itsmevjnk/MelbourneTrainTracker/Hardware/Rev2/models/usbc.STEP

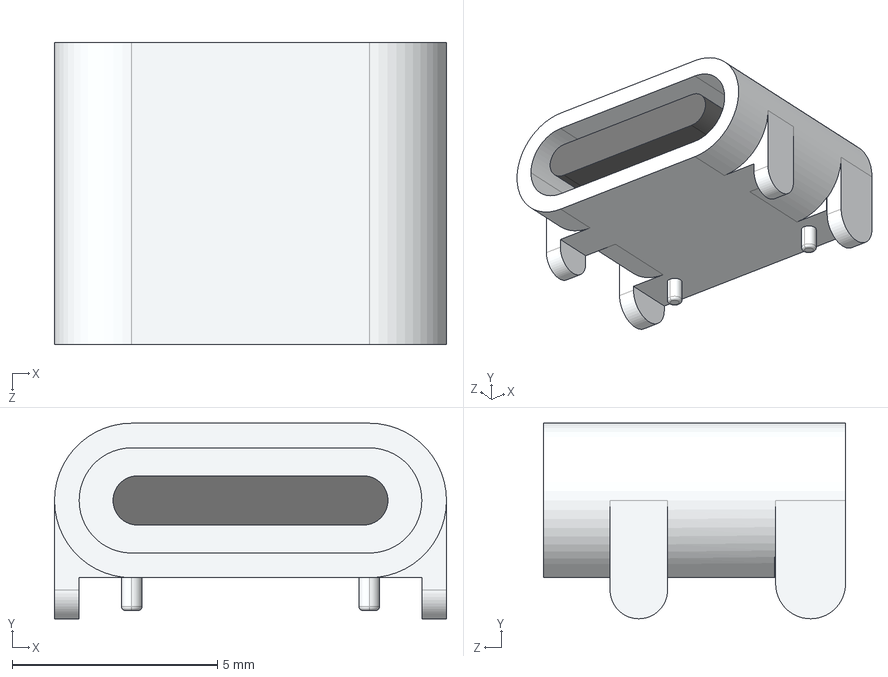
[picture p1: CAD file, 2026-01-21]
Hardware/Rev2/models/usbc.STEP
9.54 x 4.76 x 7.35 mm
