itsmevjnk/MelbourneTrainTracker/Hardware/Rev2/models/sd.STEP

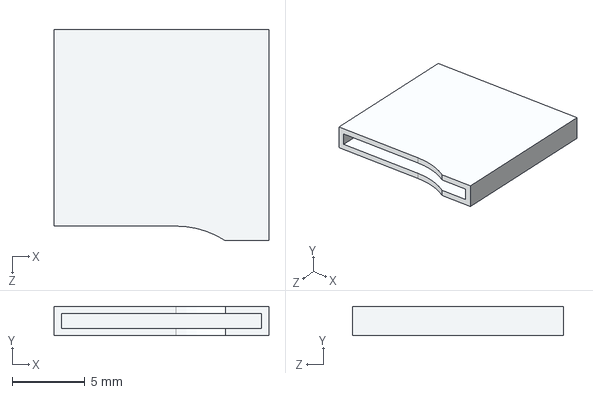
[picture p2: CAD file, 2026-01-21]
Hardware/Rev2/models/sd.STEP
14.8 x 2.00 x 14.5 mm
