itsmevjnk/MelbourneTrainTracker/Hardware/Rev2/models/1010 led.STEP

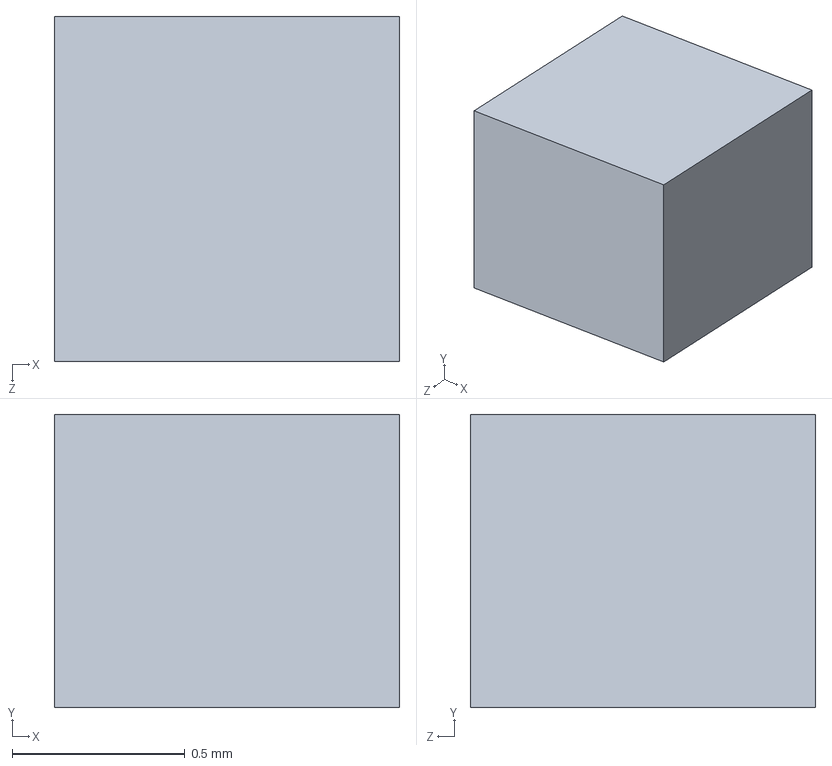
[picture p3: CAD file, 2026-01-21]
Hardware/Rev2/models/1010 led.STEP
1.00 x 0.85 x 1.00 mm
