itsmevjnk/MelbourneTrainTracker/Hardware/Rev2/models/aw20216.STEP

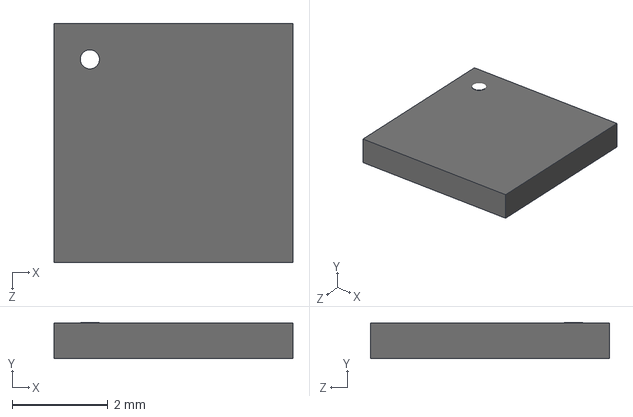
[picture p4: CAD file, 2026-01-21]
Hardware/Rev2/models/aw20216.STEP
5.00 x 0.76 x 5.00 mm
