itsmevjnk/MelbourneTrainTracker/Hardware/Rev1/Schematic.pdf

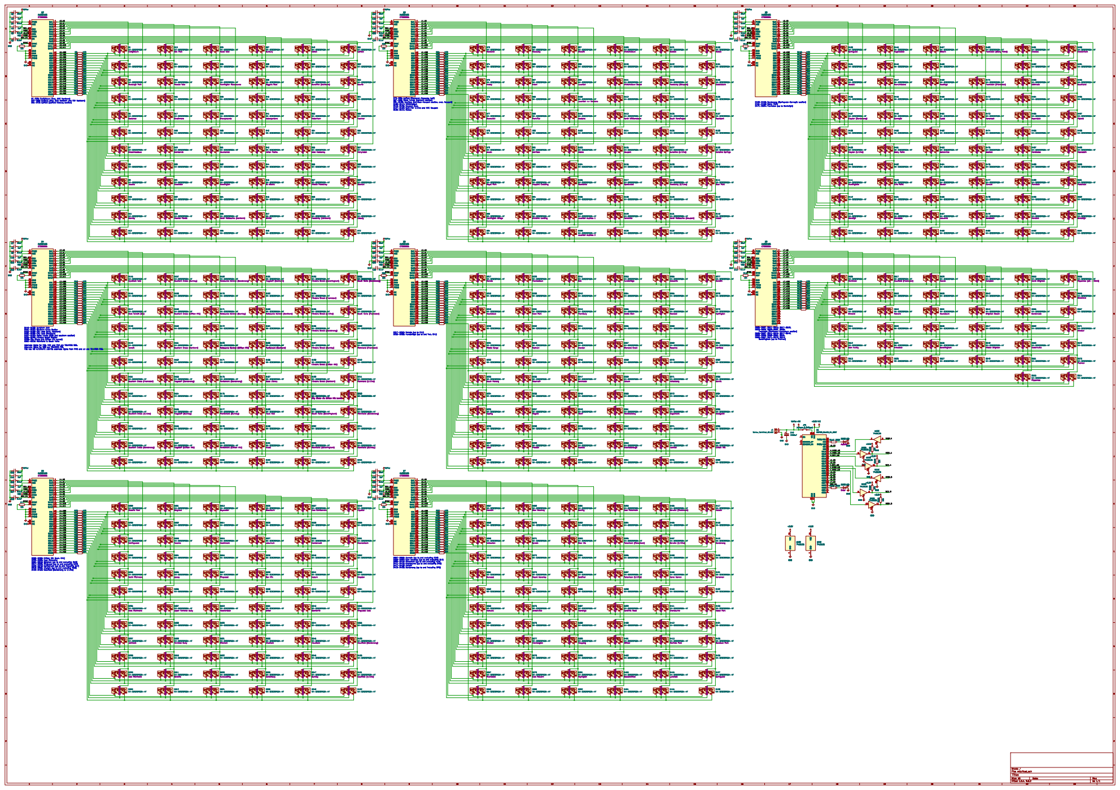
[picture p5: page 1]

Vdrive
PVCC 6 VCC 24 SCK 30 MOSI 31 CSN 28 MISO 27 EN 29 SYNC 33

3 D13 NH-B2020RGBA-HF Oak Park C2874116 RG

3 D25 NH-B2020RGBA-HF Ascot Vale C2874116 RG

3 D37 NH-B2020RGBA-HF Sunbury C2874116 RG

3 D49 NH-B2020RGBA-HF Albion C2874116 RG

3 D61 NH-B2020RGBA-HF Upfield C2874116 RG

3 D85 NH-B2020RGBA-HF Macaulay C2874116 RG

3 D133 NH-B2020RGBA-HF Melton C2874116 RG

3 D41 NH-B2020RGBA-HF C2874116 Watergardens RG

3 D51 NH-B2020RGBA-HF C2874116 Sunshine (Northern) RG

3 D135 NH-B2020RGBA-HF C2874116 Cobblebank RG

3 D483 NH-B2020RGBA-HF C2874116 Edithvale RG

3 D333 NH-B2020RGBA-HF Chatham C2874116 GND

3 D15 NH-B2020RGBA-HF C2874116 Pascoe Vale RG

3 D123 NH-B2020RGBA-HF C2874116 Footscray (Newport) RG

3 D447 NH-B2020RGBA-HF C2874116 Murrumbeena RG

3 D27 NH-B2020RGBA-HF C2874116 Flemington Racecourse RG

3 D39 NH-B2020RGBA-HF C2874116 Diggers Rest RG

3 D111 NH-B2020RGBA-HF C2874116 Williamstown Beach RG

3 D471 NH-B2020RGBA-HF C2874116 Frankston (Frankston)

3 D495 NH-B2020RGBA-HF C2874116 Southland RG

3 D17 NH-B2020RGBA-HF C2874116 Strathmore RG

3 D29 NH-B2020RGBA-HF C2874116 Showgrounds RG

3 D241 NH-B2020RGBA-HF Bell C2874116 RG

3 D101 NH-B2020RGBA-HF C2874116 Westona RG

3 D65 NH-B2020RGBA-HF C2874116 Fawkner RG

3 D113 NH-B2020RGBA-HF C2874116 North Williamstown RG

3 D125 NH-B2020RGBA-HF C2874116 South Kensington RG

3 D497 NH-B2020RGBA-HF C2874116 Highett RG

3 D499 NH-B2020RGBA-HF C2874116 Moorabbin RG

3 D347 NH-B2020RGBA-HF Burnley C2874116 RG

3 D115 NH-B2020RGBA-HF C2874116 Newport RG

3 D7 NH-B2020RGBA-HF C2874116 Broadmeadows RG

3 D31 NH-B2020RGBA-HF C2874116 Newmarket RG

3 D43 NH-B2020RGBA-HF C2874116 Keilor Plains RG

3 D55 NH-B2020RGBA-HF C2874116 West Footscray RG

3 D67 NH-B2020RGBA-HF C2874116 Merlynston RG

3 D127 NH-B2020RGBA-HF C2874116 Sunshine (V/Line) RG

3 D139 NH-B2020RGBA-HF C2874116 Caroline Springs RG

3 D451 NH-B2020RGBA-HF C2874116 Stony Point RG

3 D487 NH-B2020RGBA-HF C2874116 Mordialloc RG

3 D21 NH-B2020RGBA-HF Essendon C2874116 RG

3 D81 NH-B2020RGBA-HF Royal Park C2874116 RG

3 D453 NH-B2020RGBA-HF Crib Point C2874116 RG

3 D93 NH-B2020RGBA-HF Hoppers Crossing C2874116 RG

3 D143 NH-B2020RGBA-HF Ardeer C2874116 RG

3 D45 NH-B2020RGBA-HF St Albans C2874116

3 D57 NH-B2020RGBA-HF Middle Footscray C2874116

3 D117 NH-B2020RGBA-HF Spotswood C2874116 RG

3 D141 NH-B2020RGBA-HF Deer Park C2874116 VCC 14 GND

3 D465 NH-B2020RGBA-HF Baxter C2874116 RG

3 D95 NH-B2020RGBA-HF Williams Landing C2874116 RG

3 D119 NH-B2020RGBA-HF Yarraville C2874116 RG

3 D503 NH-B2020RGBA-HF Bentleigh C2874116 RG

3 D35 NH-B2020RGBA-HF North Melbourne (Northern) C2874116 RG

3 D47 NH-B2020RGBA-HF Ginifer C2874116 RG

3 D131 NH-B2020RGBA-HF North Melbourne (Newport) C2874116

3 D479 NH-B2020RGBA-HF Bonbeach C2874116 RG

3 D132 NH-B2020RGBA-HF C2874116 R151 10k +3.3V GND R152 10k +3.3V VCC GND

3 D219 NH-B2020RGBA-HF C2874116 Hawkstowe RG

3 D253 NH-B2020RGBA-HF Hurstbridge C2874116 RG

3 D157 NH-B2020RGBA-HF Southern Cross (Burnley) C2874116 RG

3 D145 NH-B2020RGBA-HF Wyndham Vale C2874116

3 D217 NH-B2020RGBA-HF Mernda C2874116 RG

3 D265 NH-B2020RGBA-HF Watsonia C2874116 RG

3 D277 NH-B2020RGBA-HF Darebin C2874116 RG

3 D517 NH-B2020RGBA-HF Caulfield (Frankston) C2874116

3 D553 NH-B2020RGBA-HF North Brighton C2874116

3 D565 NH-B2020RGBA-HF Ripponlea (alt - D515) C2874116 RG

3 D543 NH-B2020RGBA-HF C2874116 Brighton Beach RG

3 D231 NH-B2020RGBA-HF C2874116 Keon Park RG

3 D267 NH-B2020RGBA-HF C2874116 Macleod RG

3 D555 NH-B2020RGBA-HF C2874116 Gardenvale RG

3 D512 NH-B2020RGBA-HF C2874116 Glen Huntly R144 30R

3 D159 NH-B2020RGBA-HF C2874116 Southern Cross (Clifton Hill)

3 D195 NH-B2020RGBA-HF C2874116 Flinders Street (V/Line) RG

3 D183 NH-B2020RGBA-HF C2874116 Melbourne Central (Northern) RG

3 D255 NH-B2020RGBA-HF C2874116 Wattle Glen RG

3 D519 NH-B2020RGBA-HF C2874116 Malvern RG

3 D531 NH-B2020RGBA-HF C2874116 Hawksburn RG

3 D185 NH-B2020RGBA-HF C2874116 Parliament (Northern) RG

3 D281 NH-B2020RGBA-HF C2874116 Fairfield RG

3 D196 NH-B2020RGBA-HF C2874116 Flinders Street (Dandenong)

3 D571 NH-B2020RGBA-HF C2874116 Windsor RG

3 D271 NH-B2020RGBA-HF C2874116 Heidelberg RG

3 D524 NH-B2020RGBA-HF C2874116 Armadale RG

3 D257 NH-B2020RGBA-HF C2874116 Diamond Creek RG

3 D161 NH-B2020RGBA-HF C2874116 Southern Cross (Northern)

3 D173 NH-B2020RGBA-HF C2874116 Melbourne Central (Clifton Hill) RG

3 D197 NH-B2020RGBA-HF C2874116 Flinders Street (Burnley) RG

3 D209 NH-B2020RGBA-HF C2874116 Richmond (Frankston)

3 D221 NH-B2020RGBA-HF C2874116 Middle Gorge RG

3 D233 NH-B2020RGBA-HF C2874116 Ruthven RG

3 D245 NH-B2020RGBA-HF C2874116 Croxton RG

3 D560 NH-B2020RGBA-HF C2874116 Elsternwick RG

3 D269 NH-B2020RGBA-HF C2874116 Rosanna RG

3 D548 NH-B2020RGBA-HF C2874116 Middle Brighton RG

3 D199 NH-B2020RGBA-HF C2874116 Flinders Street (Northern) RG

3 D515 NH-B2020RGBA-HF C2874116 Ripponlea RG

3 D273 NH-B2020RGBA-HF Eaglemont C2874116 RG

3 D187 NH-B2020RGBA-HF C2874116 State Library

3 D211 NH-B2020RGBA-HF C2874116 Richmond (V/Line)

3 D223 NH-B2020RGBA-HF C2874116 South Morang RG

3 D235 NH-B2020RGBA-HF C2874116 Reservoir RG

3 D283 NH-B2020RGBA-HF C2874116 Dennis RG

3 D200 NH-B2020RGBA-HF C2874116 City Circle via Clifton Hill tunnel RG

3 D261 NH-B2020RGBA-HF Montmorency C2874116 RG

3 D153 NH-B2020RGBA-HF Southern Cross (V/Line) C2874116 R78 47R

3 D177 NH-B2020RGBA-HF Parliament (Burnley) C2874116

3 D201 NH-B2020RGBA-HF South Yarra (Sandringham) C2874116

3 D213 NH-B2020RGBA-HF Richmond (Dandenong) C2874116

3 D155 NH-B2020RGBA-HF Southern Cross (Dandenong) C2874116 RG

3 D179 NH-B2020RGBA-HF Parliament (Clifton Hill) C2874116

3 D191 NH-B2020RGBA-HF Anzac C2874116 RG

3 D203 NH-B2020RGBA-HF Richmond (Sandringham) C2874116 RG

3 D215 NH-B2020RGBA-HF Richmond (Burnley) C2874116 RG

3 D287 NH-B2020RGBA-HF Clifton Hill C2874116

Vdrive R77

3 D289 NH-B2020RGBA-HF Victoria Park C2874116 RG

3 D325 NH-B2020RGBA-HF Blackburn C2874116 RG

3 D337 NH-B2020RGBA-HF East Camberwell C2874116

3 D369 NH-B2020RGBA-HF Glen Waverley C2874116 RG

3 D393 NH-B2020RGBA-HF East Pakenham C2874116

3 D405 NH-B2020RGBA-HF Berwick (Pakenham) C2874116

3 D395 NH-B2020RGBA-HF C2874116 Pakenham (Pakenham) RG

3 D303 NH-B2020RGBA-HF C2874116 Tecoma RG

3 D383 NH-B2020RGBA-HF C2874116 Glen Iris R104 30R

3 D361 NH-B2020RGBA-HF C2874116 Burwood RG

3 D371 NH-B2020RGBA-HF C2874116 Syndal RG

3 D339 NH-B2020RGBA-HF C2874116 Camberwell RG

3 D407 NH-B2020RGBA-HF C2874116 Berwick (V/Line)

3 D299 NH-B2020RGBA-HF East Richmond C2874116 RG

3 D305 NH-B2020RGBA-HF C2874116 Upwey RG

3 D341 NH-B2020RGBA-HF C2874116 Auburn RG

3 D293 NH-B2020RGBA-HF C2874116 North Richmond RG

3 D329 NH-B2020RGBA-HF C2874116 Box Hill

3 D397 NH-B2020RGBA-HF C2874116 Pakenham (V/Line) RG

3 D409 NH-B2020RGBA-HF C2874116 Narre Warren

3 D421 NH-B2020RGBA-HF C2874116 Yarraman RG

3 D307 NH-B2020RGBA-HF C2874116 Upper Ferntree Gully RG

3 D411 NH-B2020RGBA-HF C2874116 Cranbourne RG

3 D295 NH-B2020RGBA-HF C2874116 West Richmond

3 D331 NH-B2020RGBA-HF C2874116 Union RG

3 D399 NH-B2020RGBA-HF C2874116 Cardinia Road RG

3 D423 NH-B2020RGBA-HF C2874116 Noble Park

3 D321 NH-B2020RGBA-HF Mitcham C2874116 RG

3 D345 NH-B2020RGBA-HF Hawthorn C2874116 RG

3 D425 NH-B2020RGBA-HF Sandown Park C2874116 RG

3 D429 NH-B2020RGBA-HF Caulfield (Dandenong) C2874116

3 D413 NH-B2020RGBA-HF Merinda Park C2874116

3 D311 NH-B2020RGBA-HF Boronia C2874116 RG

3 D379 NH-B2020RGBA-HF East Malvern C2874116

Id: 1/1 Title: File: mtt.kicad_sch Sheet: /
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
