itsmevjnk/MelbourneTrainTracker/Hardware/Rev2/Rev2.kicad_pcb

## KiCad design Hardware/Rev2/Rev2.kicad_pcb (2026-08-19)

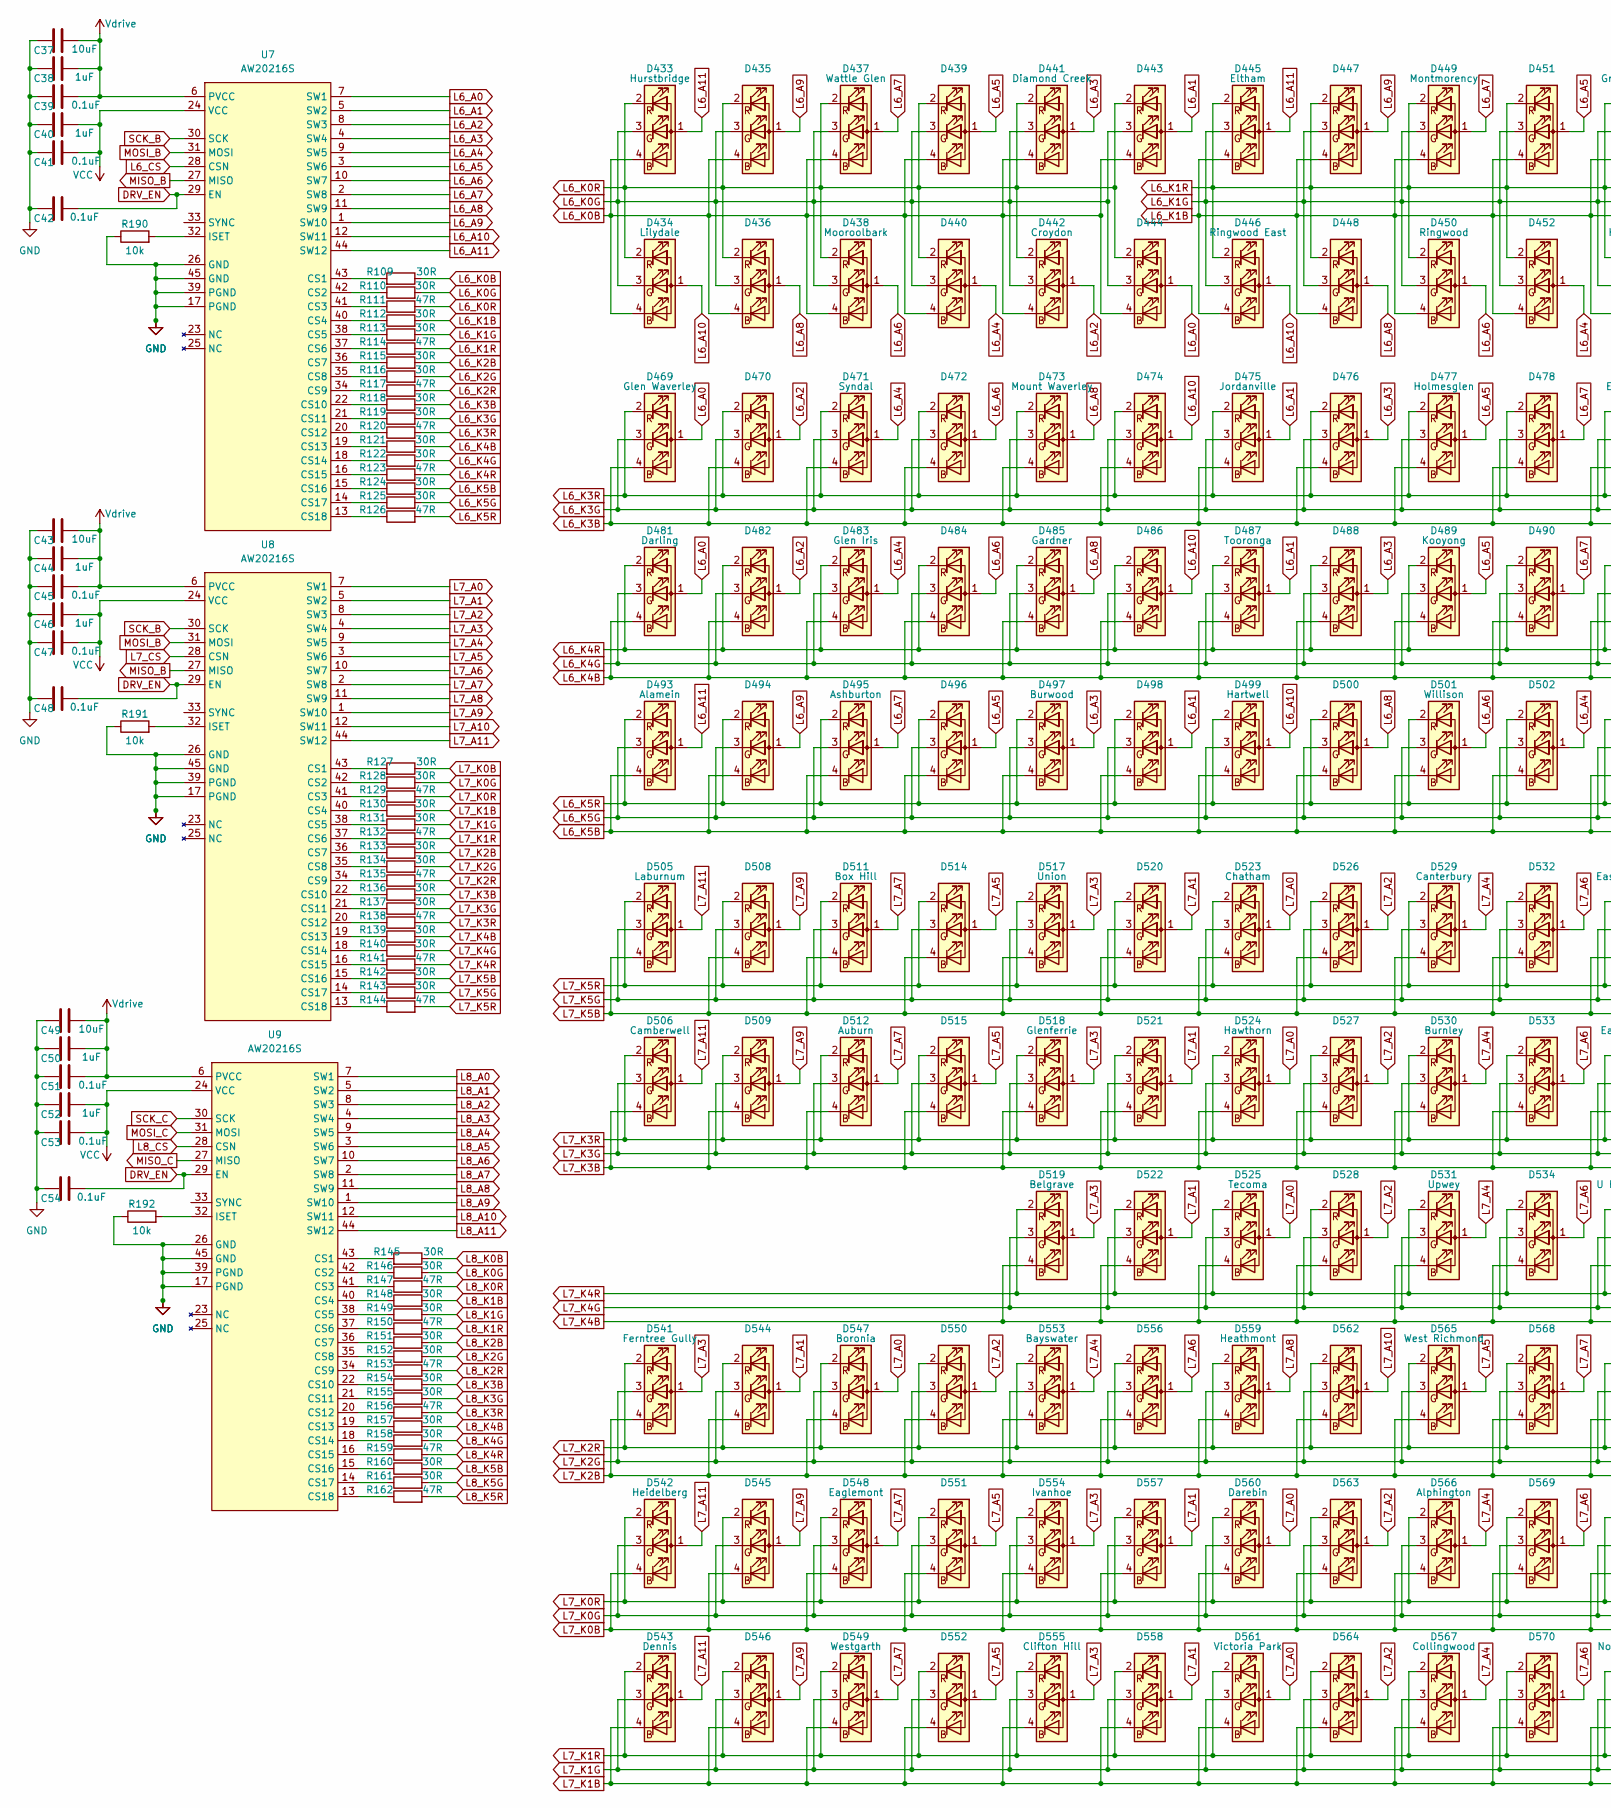
[picture p6: schematic led3.kicad_sch, part in row 1, column 1]

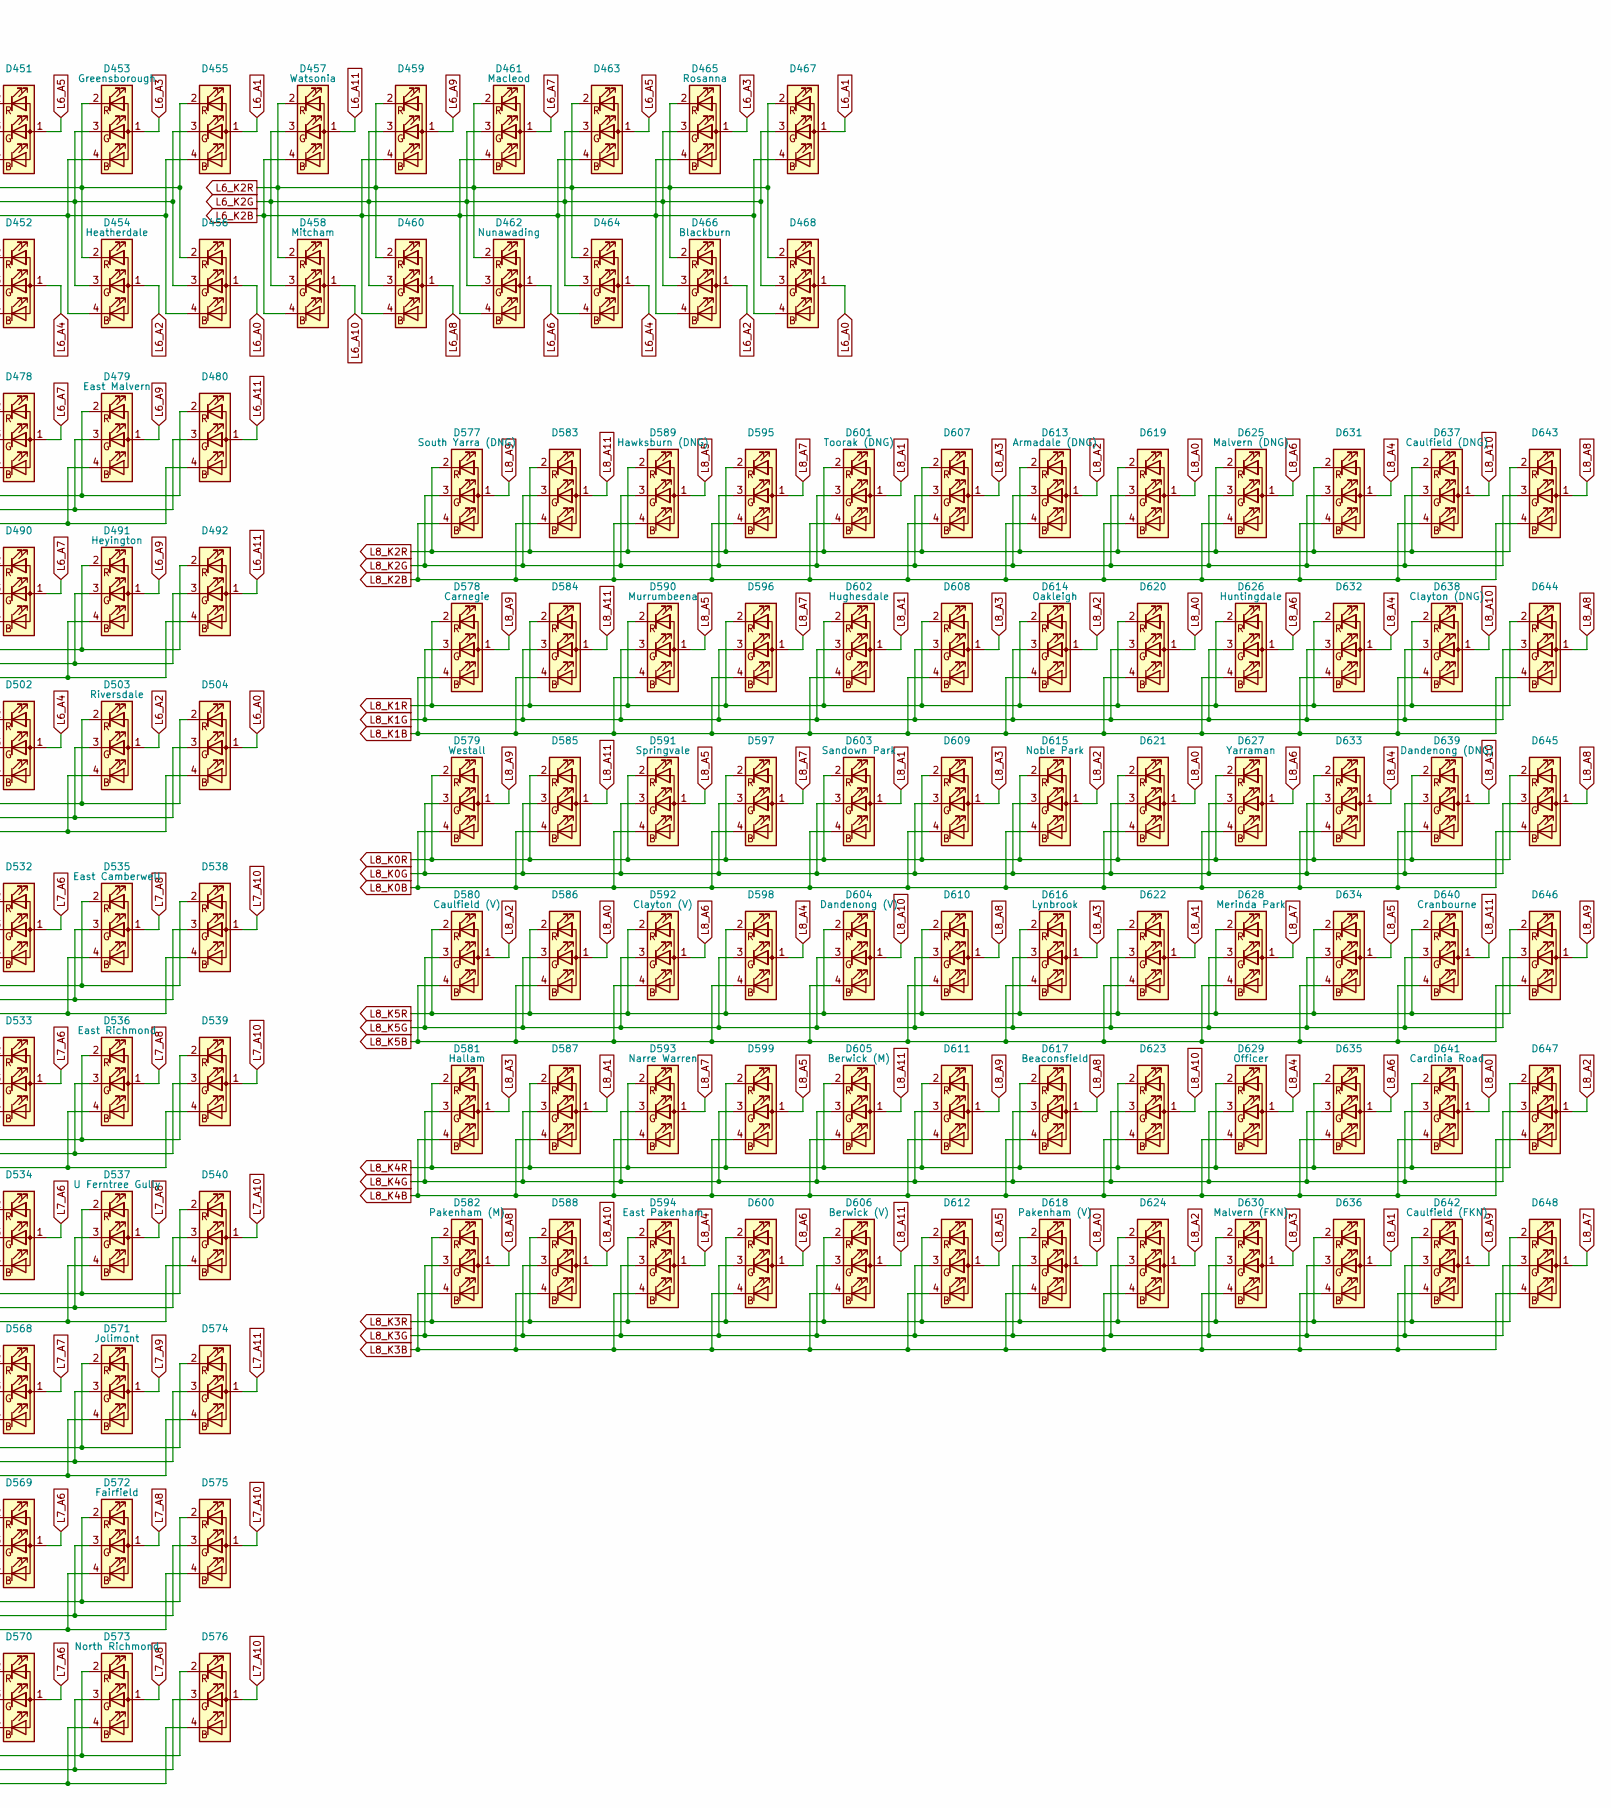
[picture p7: schematic led3.kicad_sch, part in row 1, column 2]

Parts:
C37, C43, C49: 10uF; C_0805_2012Metric_Pad1.18x1.45mm_HandSolder; MPN C380332
C38, C40, C44, C46, C50, C52: 1uF; C_0603_1608Metric_Pad1.08x0.95mm_HandSolder; MPN C6119849
C39, C41, C42, C45, C47, C48, C51, C53, C54: 0.1uF; C_0603_1608Metric_Pad1.08x0.95mm_HandSolder; MPN C14663
D433, D434, D435, D436, D437, D438, D439, D440, D441, D442, D443, D444, D445, D446, D447, D448, D449, D450, D451, D452, D453, D454, D455, D456, D457, D458, D459, D460, D461, D462, D463, D464, D465, D466, D467, D468, D469, D470, D471, D472, D473, D474, D475, D476, D477, D478, D479, D480, D481, D482, D483, D484, D485, D486, D487, D488, D489, D490, D491, D492, D493, D494, D495, D496, D497, D498, D499, D500, D501, D502, D503, D504, D505, D506, D508, D509, D511, D512, D514, D515, D517, D518, D519, D520, D521, D522, D523, D524, D525, D526, D527, D528, D529, D530, D531, D532, D533, D534, D535, D536, D537, D538, D539, D540, D541, D542, D543, D544, D545, D546, D547, D548, D549, D550, D551, D552, D553, D554, D555, D556, D557, D558, D559, D560, D561, D562, D563, D564, D565, D566, D567, D568, D569, D570, D571, D572, D573, D574, D575, D576, D577, D578, D579, D580, D581, D582, D583, D584, D585, D586, D587, D588, D589, D590, D591, D592, D593, D594, D595, D596, D597, D598, D599, D600, D601, D602, D603, D604, D605, D606, D607, D608, D609, D610, D611, D612, D613, D614, D615, D616, D617, D618, D619, D620, D621, D622, D623, D624, D625, D626, D627, D628, D629, D630, D631, D632, D633, D634, D635, D636, D637, D638, D639, D640, D641, D642, D643, D644, D645, D646, D647, D648: XL-B1010RGBT-HF; LED_RGB_Xinglight-1010; MPN C22464515
R109, R110, R112, R113, R115, R116, R118, R119, R121, R122, R124, R125, R127, R128, R130, R131, R133, R134, R136, R137, R139, R140, R142, R143, R145, R146, R148, R149, R151, R152, R154, R155, R157, R158, R160, R161: 30R; R_0805_2012Metric_Pad1.20x1.40mm_HandSolder
R111, R114, R117, R120, R123, R126, R129, R132, R135, R138, R141, R144, R147, R150, R153, R156, R159, R162: 47R; R_0805_2012Metric_Pad1.20x1.40mm_HandSolder
R190, R191, R192: 10k; R_0603_1608Metric_Pad0.98x0.95mm_HandSolder; MPN C15401
U7, U8, U9: AW20216S; QFN-44-1EP_5x5mm_P0.4mm_EP2.45x2.45mm; MPN C7385556

Connections:
+3.3V: C40.2, C41.2, C46.2, C47.2, C52.2, C53.2, U7.24 (VCC), U8.24 (VCC), U9.24 (VCC); also elsewhere on the board
+5V: C37.2, C38.2, C39.2, C43.2, C44.2, C45.2, C49.2, C50.2, C51.2, U7.6 (PVCC), U8.6 (PVCC), U9.6 (PVCC); also elsewhere on the board
DRV_EN: C42.2, C48.2, C54.2, U7.29 (EN), U8.29 (EN), U9.29 (EN); also elsewhere on the board
GND: C37.1, C38.1, C39.1, C40.1, C41.1, C42.1, C43.1, C44.1, C45.1, C46.1, C47.1, C48.1, C49.1, C50.1, C51.1, C52.1, C53.1, C54.1, R190.1, R191.1, R192.1, U7.17 (PGND), U7.26 (GND), U7.39 (PGND), U7.45 (GND), U8.17 (PGND), U8.26 (GND), U8.39 (PGND), U8.45 (GND), U9.17 (PGND), U9.26 (GND), U9.39 (PGND), U9.45 (GND); also elsewhere on the board
L6_A0: D444.1 (A), D456.1 (A), D468.1 (A), D469.1 (A), D481.1 (A), D504.1 (A), U7.7 (SW1)
L6_A1: D443.1 (A), D455.1 (A), D467.1 (A), D475.1 (A), D487.1 (A), D498.1 (A), U7.5 (SW2)
L6_A2: D442.1 (A), D454.1 (A), D466.1 (A), D470.1 (A), D482.1 (A), D503.1 (A), U7.8 (SW3)
L6_A3: D441.1 (A), D453.1 (A), D465.1 (A), D476.1 (A), D488.1 (A), D497.1 (A), U7.4 (SW4)
L6_A4: D440.1 (A), D452.1 (A), D464.1 (A), D471.1 (A), D483.1 (A), D502.1 (A), U7.9 (SW5)
L6_A5: D439.1 (A), D451.1 (A), D463.1 (A), D477.1 (A), D489.1 (A), D496.1 (A), U7.3 (SW6)
L6_A6: D438.1 (A), D450.1 (A), D462.1 (A), D472.1 (A), D484.1 (A), D501.1 (A), U7.10 (SW7)
L6_A7: D437.1 (A), D449.1 (A), D461.1 (A), D478.1 (A), D490.1 (A), D495.1 (A), U7.2 (SW8)
L6_A8: D436.1 (A), D448.1 (A), D460.1 (A), D473.1 (A), D485.1 (A), D500.1 (A), U7.11 (SW9)
L6_A9: D435.1 (A), D447.1 (A), D459.1 (A), D479.1 (A), D491.1 (A), D494.1 (A), U7.1 (SW10)
L6_A10: D434.1 (A), D446.1 (A), D458.1 (A), D474.1 (A), D486.1 (A), D499.1 (A), U7.12 (SW11)
L6_A11: D433.1 (A), D445.1 (A), D457.1 (A), D480.1 (A), D492.1 (A), D493.1 (A), U7.44 (SW12)
L6_CS: U7.28 (CSN); also elsewhere on the board
L6_K0B: D433.4 (BK), D434.4 (BK), D435.4 (BK), D436.4 (BK), D437.4 (BK), D438.4 (BK), D439.4 (BK), D440.4 (BK), D441.4 (BK), D442.4 (BK), D443.4 (BK), D444.4 (BK), R109.1
L6_K0G: D433.3 (GK), D434.3 (GK), D435.3 (GK), D436.3 (GK), D437.3 (GK), D438.3 (GK), D439.3 (GK), D440.3 (GK), D441.3 (GK), D442.3 (GK), D443.3 (GK), D444.3 (GK), R110.2
L6_K0R: D433.2 (RK), D434.2 (RK), D435.2 (RK), D436.2 (RK), D437.2 (RK), D438.2 (RK), D439.2 (RK), D440.2 (RK), D441.2 (RK), D442.2 (RK), D443.2 (RK), D444.2 (RK), R111.2
L6_K1B: D445.4 (BK), D446.4 (BK), D447.4 (BK), D448.4 (BK), D449.4 (BK), D450.4 (BK), D451.4 (BK), D452.4 (BK), D453.4 (BK), D454.4 (BK), D455.4 (BK), D456.4 (BK), R112.2
L6_K1G: D445.3 (GK), D446.3 (GK), D447.3 (GK), D448.3 (GK), D449.3 (GK), D450.3 (GK), D451.3 (GK), D452.3 (GK), D453.3 (GK), D454.3 (GK), D455.3 (GK), D456.3 (GK), R113.2
L6_K1R: D445.2 (RK), D446.2 (RK), D447.2 (RK), D448.2 (RK), D449.2 (RK), D450.2 (RK), D451.2 (RK), D452.2 (RK), D453.2 (RK), D454.2 (RK), D455.2 (RK), D456.2 (RK), R114.2
L6_K2B: D457.4 (BK), D458.4 (BK), D459.4 (BK), D460.4 (BK), D461.4 (BK), D462.4 (BK), D463.4 (BK), D464.4 (BK), D465.4 (BK), D466.4 (BK), D467.4 (BK), D468.4 (BK), R115.2
L6_K2G: D457.3 (GK), D458.3 (GK), D459.3 (GK), D460.3 (GK), D461.3 (GK), D462.3 (GK), D463.3 (GK), D464.3 (GK), D465.3 (GK), D466.3 (GK), D467.3 (GK), D468.3 (GK), R116.2
L6_K2R: D457.2 (RK), D458.2 (RK), D459.2 (RK), D460.2 (RK), D461.2 (RK), D462.2 (RK), D463.2 (RK), D464.2 (RK), D465.2 (RK), D466.2 (RK), D467.2 (RK), D468.2 (RK), R117.2
L6_K3B: D469.4 (BK), D470.4 (BK), D471.4 (BK), D472.4 (BK), D473.4 (BK), D474.4 (BK), D475.4 (BK), D476.4 (BK), D477.4 (BK), D478.4 (BK), D479.4 (BK), D480.4 (BK), R118.2
L6_K3G: D469.3 (GK), D470.3 (GK), D471.3 (GK), D472.3 (GK), D473.3 (GK), D474.3 (GK), D475.3 (GK), D476.3 (GK), D477.3 (GK), D478.3 (GK), D479.3 (GK), D480.3 (GK), R119.2
L6_K3R: D469.2 (RK), D470.2 (RK), D471.2 (RK), D472.2 (RK), D473.2 (RK), D474.2 (RK), D475.2 (RK), D476.2 (RK), D477.2 (RK), D478.2 (RK), D479.2 (RK), D480.2 (RK), R120.2
L6_K4B: D481.4 (BK), D482.4 (BK), D483.4 (BK), D484.4 (BK), D485.4 (BK), D486.4 (BK), D487.4 (BK), D488.4 (BK), D489.4 (BK), D490.4 (BK), D491.4 (BK), D492.4 (BK), R121.2
L6_K4G: D481.3 (GK), D482.3 (GK), D483.3 (GK), D484.3 (GK), D485.3 (GK), D486.3 (GK), D487.3 (GK), D488.3 (GK), D489.3 (GK), D490.3 (GK), D491.3 (GK), D492.3 (GK), R122.2
L6_K4R: D481.2 (RK), D482.2 (RK), D483.2 (RK), D484.2 (RK), D485.2 (RK), D486.2 (RK), D487.2 (RK), D488.2 (RK), D489.2 (RK), D490.2 (RK), D491.2 (RK), D492.2 (RK), R123.2
L6_K5B: D493.4 (BK), D494.4 (BK), D495.4 (BK), D496.4 (BK), D497.4 (BK), D498.4 (BK), D499.4 (BK), D500.4 (BK), D501.4 (BK), D502.4 (BK), D503.4 (BK), D504.4 (BK), R124.2
L6_K5G: D493.3 (GK), D494.3 (GK), D495.3 (GK), D496.3 (GK), D497.3 (GK), D498.3 (GK), D499.3 (GK), D500.3 (GK), D501.3 (GK), D502.3 (GK), D503.3 (GK), D504.3 (GK), R125.2
L6_K5R: D493.2 (RK), D494.2 (RK), D495.2 (RK), D496.2 (RK), D497.2 (RK), D498.2 (RK), D499.2 (RK), D500.2 (RK), D501.2 (RK), D502.2 (RK), D503.2 (RK), D504.2 (RK), R126.2
L7_A0: D523.1 (A), D524.1 (A), D525.1 (A), D547.1 (A), D560.1 (A), D561.1 (A), U8.7 (SW1)
L7_A1: D520.1 (A), D521.1 (A), D522.1 (A), D544.1 (A), D557.1 (A), D558.1 (A), U8.5 (SW2)
L7_A2: D526.1 (A), D527.1 (A), D528.1 (A), D550.1 (A), D563.1 (A), D564.1 (A), U8.8 (SW3)
L7_A3: D517.1 (A), D518.1 (A), D519.1 (A), D541.1 (A), D554.1 (A), D555.1 (A), U8.4 (SW4)
L7_A4: D529.1 (A), D530.1 (A), D531.1 (A), D553.1 (A), D566.1 (A), D567.1 (A), U8.9 (SW5)
L7_A5: D514.1 (A), D515.1 (A), D551.1 (A), D552.1 (A), D565.1 (A), U8.3 (SW6)
L7_A6: D532.1 (A), D533.1 (A), D534.1 (A), D556.1 (A), D569.1 (A), D570.1 (A), U8.10 (SW7)
L7_A7: D511.1 (A), D512.1 (A), D548.1 (A), D549.1 (A), D568.1 (A), U8.2 (SW8)
L7_A8: D535.1 (A), D536.1 (A), D537.1 (A), D559.1 (A), D572.1 (A), D573.1 (A), U8.11 (SW9)
L7_A9: D508.1 (A), D509.1 (A), D545.1 (A), D546.1 (A), D571.1 (A), U8.1 (SW10)
L7_A10: D538.1 (A), D539.1 (A), D540.1 (A), D562.1 (A), D575.1 (A), D576.1 (A), U8.12 (SW11)
L7_A11: D505.1 (A), D506.1 (A), D542.1 (A), D543.1 (A), D574.1 (A), U8.44 (SW12)
L7_CS: U8.28 (CSN); also elsewhere on the board
L7_K0B: D542.4 (BK), D545.4 (BK), D548.4 (BK), D551.4 (BK), D554.4 (BK), D557.4 (BK), D560.4 (BK), D563.4 (BK), D566.4 (BK), D569.4 (BK), D572.4 (BK), D575.4 (BK), R127.1
L7_K0G: D542.3 (GK), D545.3 (GK), D548.3 (GK), D551.3 (GK), D554.3 (GK), D557.3 (GK), D560.3 (GK), D563.3 (GK), D566.3 (GK), D569.3 (GK), D572.3 (GK), D575.3 (GK), R128.2
L7_K0R: D542.2 (RK), D545.2 (RK), D548.2 (RK), D551.2 (RK), D554.2 (RK), D557.2 (RK), D560.2 (RK), D563.2 (RK), D566.2 (RK), D569.2 (RK), D572.2 (RK), D575.2 (RK), R129.2
L7_K1B: D543.4 (BK), D546.4 (BK), D549.4 (BK), D552.4 (BK), D555.4 (BK), D558.4 (BK), D561.4 (BK), D564.4 (BK), D567.4 (BK), D570.4 (BK), D573.4 (BK), D576.4 (BK), R130.2
L7_K1G: D543.3 (GK), D546.3 (GK), D549.3 (GK), D552.3 (GK), D555.3 (GK), D558.3 (GK), D561.3 (GK), D564.3 (GK), D567.3 (GK), D570.3 (GK), D573.3 (GK), D576.3 (GK), R131.2
L7_K1R: D543.2 (RK), D546.2 (RK), D549.2 (RK), D552.2 (RK), D555.2 (RK), D558.2 (RK), D561.2 (RK), D564.2 (RK), D567.2 (RK), D570.2 (RK), D573.2 (RK), D576.2 (RK), R132.2
L7_K2B: D541.4 (BK), D544.4 (BK), D547.4 (BK), D550.4 (BK), D553.4 (BK), D556.4 (BK), D559.4 (BK), D562.4 (BK), D565.4 (BK), D568.4 (BK), D571.4 (BK), D574.4 (BK), R133.2
L7_K2G: D541.3 (GK), D544.3 (GK), D547.3 (GK), D550.3 (GK), D553.3 (GK), D556.3 (GK), D559.3 (GK), D562.3 (GK), D565.3 (GK), D568.3 (GK), D571.3 (GK), D574.3 (GK), R134.2
L7_K2R: D541.2 (RK), D544.2 (RK), D547.2 (RK), D550.2 (RK), D553.2 (RK), D556.2 (RK), D559.2 (RK), D562.2 (RK), D565.2 (RK), D568.2 (RK), D571.2 (RK), D574.2 (RK), R135.2
L7_K3B: D506.4 (BK), D509.4 (BK), D512.4 (BK), D515.4 (BK), D518.4 (BK), D521.4 (BK), D524.4 (BK), D527.4 (BK), D530.4 (BK), D533.4 (BK), D536.4 (BK), D539.4 (BK), R136.2
L7_K3G: D506.3 (GK), D509.3 (GK), D512.3 (GK), D515.3 (GK), D518.3 (GK), D521.3 (GK), D524.3 (GK), D527.3 (GK), D530.3 (GK), D533.3 (GK), D536.3 (GK), D539.3 (GK), R137.2
L7_K3R: D506.2 (RK), D509.2 (RK), D512.2 (RK), D515.2 (RK), D518.2 (RK), D521.2 (RK), D524.2 (RK), D527.2 (RK), D530.2 (RK), D533.2 (RK), D536.2 (RK), D539.2 (RK), R138.2
L7_K4B: D519.4 (BK), D522.4 (BK), D525.4 (BK), D528.4 (BK), D531.4 (BK), D534.4 (BK), D537.4 (BK), D540.4 (BK), R139.2
L7_K4G: D519.3 (GK), D522.3 (GK), D525.3 (GK), D528.3 (GK), D531.3 (GK), D534.3 (GK), D537.3 (GK), D540.3 (GK), R140.2
L7_K4R: D519.2 (RK), D522.2 (RK), D525.2 (RK), D528.2 (RK), D531.2 (RK), D534.2 (RK), D537.2 (RK), D540.2 (RK), R141.2
L7_K5B: D505.4 (BK), D508.4 (BK), D511.4 (BK), D514.4 (BK), D517.4 (BK), D520.4 (BK), D523.4 (BK), D526.4 (BK), D529.4 (BK), D532.4 (BK), D535.4 (BK), D538.4 (BK), R142.2
L7_K5G: D505.3 (GK), D508.3 (GK), D511.3 (GK), D514.3 (GK), D517.3 (GK), D520.3 (GK), D523.3 (GK), D526.3 (GK), D529.3 (GK), D532.3 (GK), D535.3 (GK), D538.3 (GK), R143.2
L7_K5R: D505.2 (RK), D508.2 (RK), D511.2 (RK), D514.2 (RK), D517.2 (RK), D520.2 (RK), D523.2 (RK), D526.2 (RK), D529.2 (RK), D532.2 (RK), D535.2 (RK), D538.2 (RK), R144.2
L8_A0: D586.1 (A), D618.1 (A), D619.1 (A), D620.1 (A), D621.1 (A), D641.1 (A), U9.7 (SW1)
L8_A1: D587.1 (A), D601.1 (A), D602.1 (A), D603.1 (A), D622.1 (A), D636.1 (A), U9.5 (SW2)
L8_A2: D580.1 (A), D613.1 (A), D614.1 (A), D615.1 (A), D624.1 (A), D647.1 (A), U9.8 (SW3)
L8_A3: D581.1 (A), D607.1 (A), D608.1 (A), D609.1 (A), D616.1 (A), D630.1 (A), U9.4 (SW4)
L8_A4: D594.1 (A), D598.1 (A), D629.1 (A), D631.1 (A), D632.1 (A), D633.1 (A), U9.9 (SW5)
L8_A5: D589.1 (A), D590.1 (A), D591.1 (A), D599.1 (A), D612.1 (A), D634.1 (A), U9.3 (SW6)
L8_A6: D592.1 (A), D600.1 (A), D625.1 (A), D626.1 (A), D627.1 (A), D635.1 (A), U9.10 (SW7)
L8_A7: D593.1 (A), D595.1 (A), D596.1 (A), D597.1 (A), D628.1 (A), D648.1 (A), U9.2 (SW8)
L8_A8: D582.1 (A), D610.1 (A), D617.1 (A), D643.1 (A), D644.1 (A), D645.1 (A), U9.11 (SW9)
L8_A9: D577.1 (A), D578.1 (A), D579.1 (A), D611.1 (A), D642.1 (A), D646.1 (A), U9.1 (SW10)
L8_A10: D588.1 (A), D604.1 (A), D623.1 (A), D637.1 (A), D638.1 (A), D639.1 (A), U9.12 (SW11)
L8_A11: D583.1 (A), D584.1 (A), D585.1 (A), D605.1 (A), D606.1 (A), D640.1 (A), U9.44 (SW12)
L8_CS: U9.28 (CSN); also elsewhere on the board
L8_K0B: D579.4 (BK), D585.4 (BK), D591.4 (BK), D597.4 (BK), D603.4 (BK), D609.4 (BK), D615.4 (BK), D621.4 (BK), D627.4 (BK), D633.4 (BK), D639.4 (BK), D645.4 (BK), R145.1
L8_K0G: D579.3 (GK), D585.3 (GK), D591.3 (GK), D597.3 (GK), D603.3 (GK), D609.3 (GK), D615.3 (GK), D621.3 (GK), D627.3 (GK), D633.3 (GK), D639.3 (GK), D645.3 (GK), R146.2
L8_K0R: D579.2 (RK), D585.2 (RK), D591.2 (RK), D597.2 (RK), D603.2 (RK), D609.2 (RK), D615.2 (RK), D621.2 (RK), D627.2 (RK), D633.2 (RK), D639.2 (RK), D645.2 (RK), R147.2
L8_K1B: D578.4 (BK), D584.4 (BK), D590.4 (BK), D596.4 (BK), D602.4 (BK), D608.4 (BK), D614.4 (BK), D620.4 (BK), D626.4 (BK), D632.4 (BK), D638.4 (BK), D644.4 (BK), R148.2
L8_K1G: D578.3 (GK), D584.3 (GK), D590.3 (GK), D596.3 (GK), D602.3 (GK), D608.3 (GK), D614.3 (GK), D620.3 (GK), D626.3 (GK), D632.3 (GK), D638.3 (GK), D644.3 (GK), R149.2
L8_K1R: D578.2 (RK), D584.2 (RK), D590.2 (RK), D596.2 (RK), D602.2 (RK), D608.2 (RK), D614.2 (RK), D620.2 (RK), D626.2 (RK), D632.2 (RK), D638.2 (RK), D644.2 (RK), R150.2
L8_K2B: D577.4 (BK), D583.4 (BK), D589.4 (BK), D595.4 (BK), D601.4 (BK), D607.4 (BK), D613.4 (BK), D619.4 (BK), D625.4 (BK), D631.4 (BK), D637.4 (BK), D643.4 (BK), R151.2
L8_K2G: D577.3 (GK), D583.3 (GK), D589.3 (GK), D595.3 (GK), D601.3 (GK), D607.3 (GK), D613.3 (GK), D619.3 (GK), D625.3 (GK), D631.3 (GK), D637.3 (GK), D643.3 (GK), R152.2
L8_K2R: D577.2 (RK), D583.2 (RK), D589.2 (RK), D595.2 (RK), D601.2 (RK), D607.2 (RK), D613.2 (RK), D619.2 (RK), D625.2 (RK), D631.2 (RK), D637.2 (RK), D643.2 (RK), R153.2
L8_K3B: D582.4 (BK), D588.4 (BK), D594.4 (BK), D600.4 (BK), D606.4 (BK), D612.4 (BK), D618.4 (BK), D624.4 (BK), D630.4 (BK), D636.4 (BK), D642.4 (BK), D648.4 (BK), R154.2
L8_K3G: D582.3 (GK), D588.3 (GK), D594.3 (GK), D600.3 (GK), D606.3 (GK), D612.3 (GK), D618.3 (GK), D624.3 (GK), D630.3 (GK), D636.3 (GK), D642.3 (GK), D648.3 (GK), R155.2
L8_K3R: D582.2 (RK), D588.2 (RK), D594.2 (RK), D600.2 (RK), D606.2 (RK), D612.2 (RK), D618.2 (RK), D624.2 (RK), D630.2 (RK), D636.2 (RK), D642.2 (RK), D648.2 (RK), R156.2
L8_K4B: D581.4 (BK), D587.4 (BK), D593.4 (BK), D599.4 (BK), D605.4 (BK), D611.4 (BK), D617.4 (BK), D623.4 (BK), D629.4 (BK), D635.4 (BK), D641.4 (BK), D647.4 (BK), R157.2
L8_K4G: D581.3 (GK), D587.3 (GK), D593.3 (GK), D599.3 (GK), D605.3 (GK), D611.3 (GK), D617.3 (GK), D623.3 (GK), D629.3 (GK), D635.3 (GK), D641.3 (GK), D647.3 (GK), R158.2
L8_K4R: D581.2 (RK), D587.2 (RK), D593.2 (RK), D599.2 (RK), D605.2 (RK), D611.2 (RK), D617.2 (RK), D623.2 (RK), D629.2 (RK), D635.2 (RK), D641.2 (RK), D647.2 (RK), R159.2
L8_K5B: D580.4 (BK), D586.4 (BK), D592.4 (BK), D598.4 (BK), D604.4 (BK), D610.4 (BK), D616.4 (BK), D622.4 (BK), D628.4 (BK), D634.4 (BK), D640.4 (BK), D646.4 (BK), R160.2
L8_K5G: D580.3 (GK), D586.3 (GK), D592.3 (GK), D598.3 (GK), D604.3 (GK), D610.3 (GK), D616.3 (GK), D622.3 (GK), D628.3 (GK), D634.3 (GK), D640.3 (GK), D646.3 (GK), R161.2
L8_K5R: D580.2 (RK), D586.2 (RK), D592.2 (RK), D598.2 (RK), D604.2 (RK), D610.2 (RK), D616.2 (RK), D622.2 (RK), D628.2 (RK), D634.2 (RK), D640.2 (RK), D646.2 (RK), R162.2
MISO_B: U7.27 (MISO), U8.27 (MISO); also elsewhere on the board
MISO_C: U9.27 (MISO); also elsewhere on the board
MOSI_B: U7.31 (MOSI), U8.31 (MOSI); also elsewhere on the board
MOSI_C: U9.31 (MOSI); also elsewhere on the board
unnamed: R109.2, U7.43 (CS1)
unnamed: R110.1, U7.42 (CS2)
unnamed: R111.1, U7.41 (CS3)
unnamed: R112.1, U7.40 (CS4)
unnamed: R113.1, U7.38 (CS5)
unnamed: R114.1, U7.37 (CS6)
unnamed: R115.1, U7.36 (CS7)
unnamed: R116.1, U7.35 (CS8)
unnamed: R117.1, U7.34 (CS9)
unnamed: R118.1, U7.22 (CS10)
unnamed: R119.1, U7.21 (CS11)
unnamed: R120.1, U7.20 (CS12)
unnamed: R121.1, U7.19 (CS13)
unnamed: R122.1, U7.18 (CS14)
unnamed: R123.1, U7.16 (CS15)
unnamed: R124.1, U7.15 (CS16)
unnamed: R125.1, U7.14 (CS17)
unnamed: R126.1, U7.13 (CS18)
unnamed: R190.2, U7.32 (ISET)
unnamed: R127.2, U8.43 (CS1)
unnamed: R128.1, U8.42 (CS2)
unnamed: R129.1, U8.41 (CS3)
unnamed: R130.1, U8.40 (CS4)
unnamed: R131.1, U8.38 (CS5)
unnamed: R132.1, U8.37 (CS6)
unnamed: R133.1, U8.36 (CS7)
unnamed: R134.1, U8.35 (CS8)
unnamed: R135.1, U8.34 (CS9)
unnamed: R136.1, U8.22 (CS10)
unnamed: R137.1, U8.21 (CS11)
unnamed: R138.1, U8.20 (CS12)
unnamed: R139.1, U8.19 (CS13)
unnamed: R140.1, U8.18 (CS14)
unnamed: R141.1, U8.16 (CS15)
unnamed: R142.1, U8.15 (CS16)
unnamed: R143.1, U8.14 (CS17)
unnamed: R144.1, U8.13 (CS18)
unnamed: R191.2, U8.32 (ISET)
unnamed: R145.2, U9.43 (CS1)
unnamed: R146.1, U9.42 (CS2)
unnamed: R147.1, U9.41 (CS3)
unnamed: R148.1, U9.40 (CS4)
unnamed: R149.1, U9.38 (CS5)
unnamed: R150.1, U9.37 (CS6)
unnamed: R151.1, U9.36 (CS7)
unnamed: R152.1, U9.35 (CS8)
unnamed: R153.1, U9.34 (CS9)
unnamed: R154.1, U9.22 (CS10)
unnamed: R155.1, U9.21 (CS11)
unnamed: R156.1, U9.20 (CS12)
unnamed: R157.1, U9.19 (CS13)
unnamed: R158.1, U9.18 (CS14)
unnamed: R159.1, U9.16 (CS15)
unnamed: R160.1, U9.15 (CS16)
unnamed: R161.1, U9.14 (CS17)
unnamed: R162.1, U9.13 (CS18)
unnamed: R192.2, U9.32 (ISET)
SCK_B: U7.30 (SCK), U8.30 (SCK); also elsewhere on the board
SCK_C: U9.30 (SCK); also elsewhere on the board
