itsmevjnk/MelbourneTrainTracker/Hardware/Rev2/Rev2.kicad_pcb

## KiCad design Hardware/Rev2/Rev2.kicad_pcb (continued)

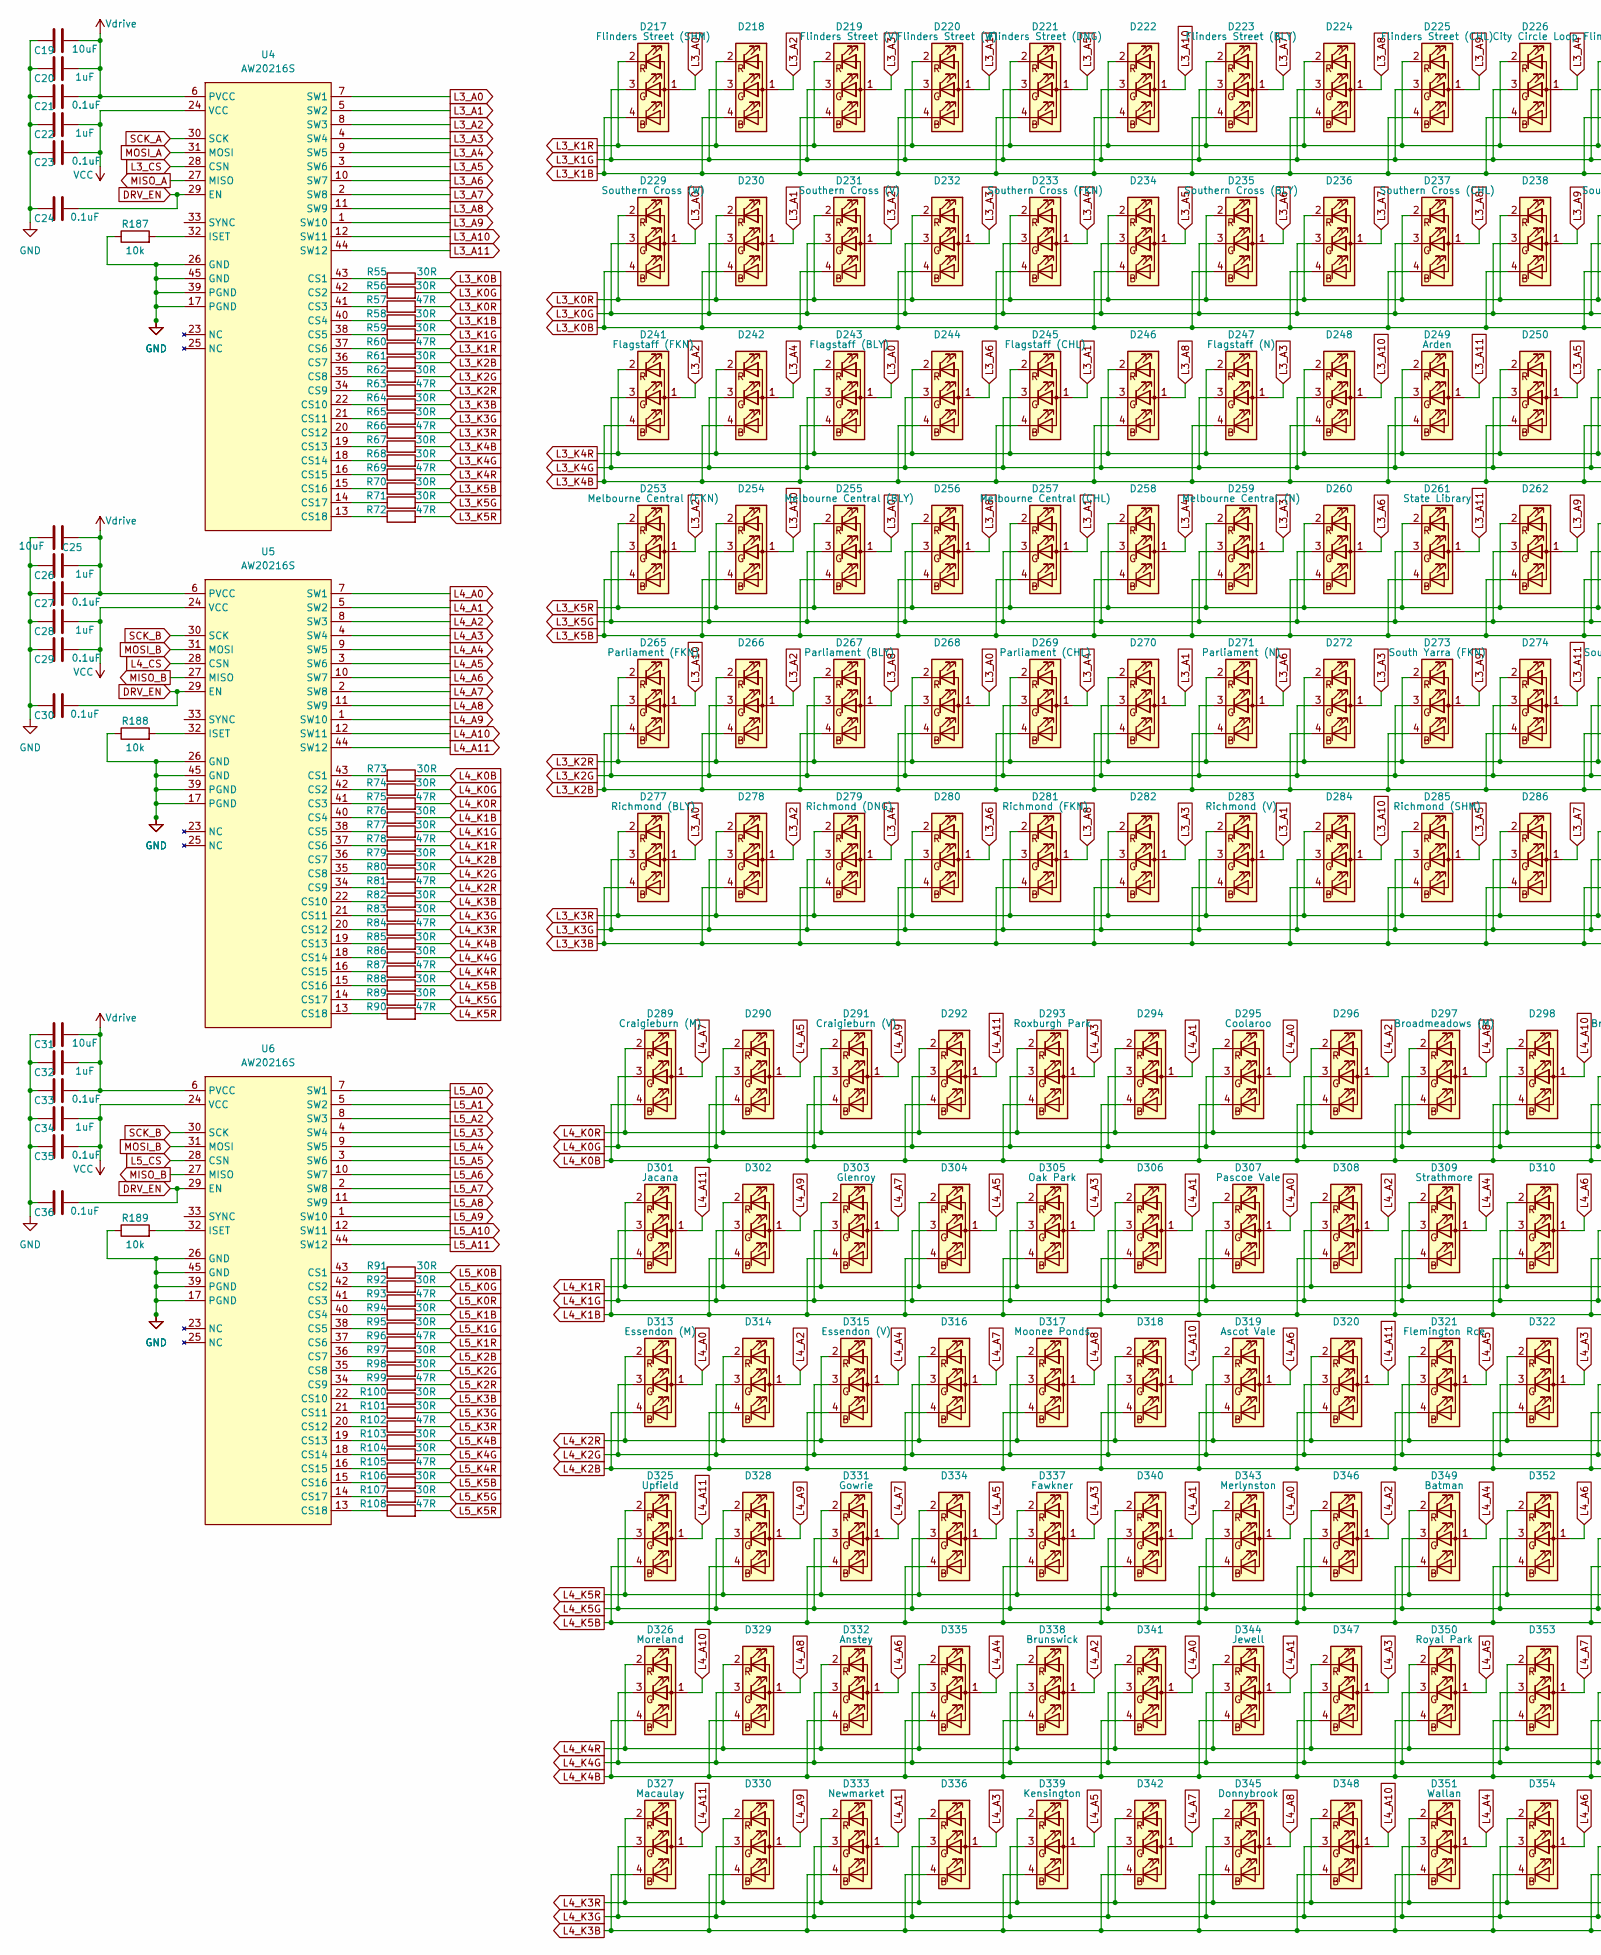
[picture p8: schematic city.kicad_sch, part in row 1, column 1]

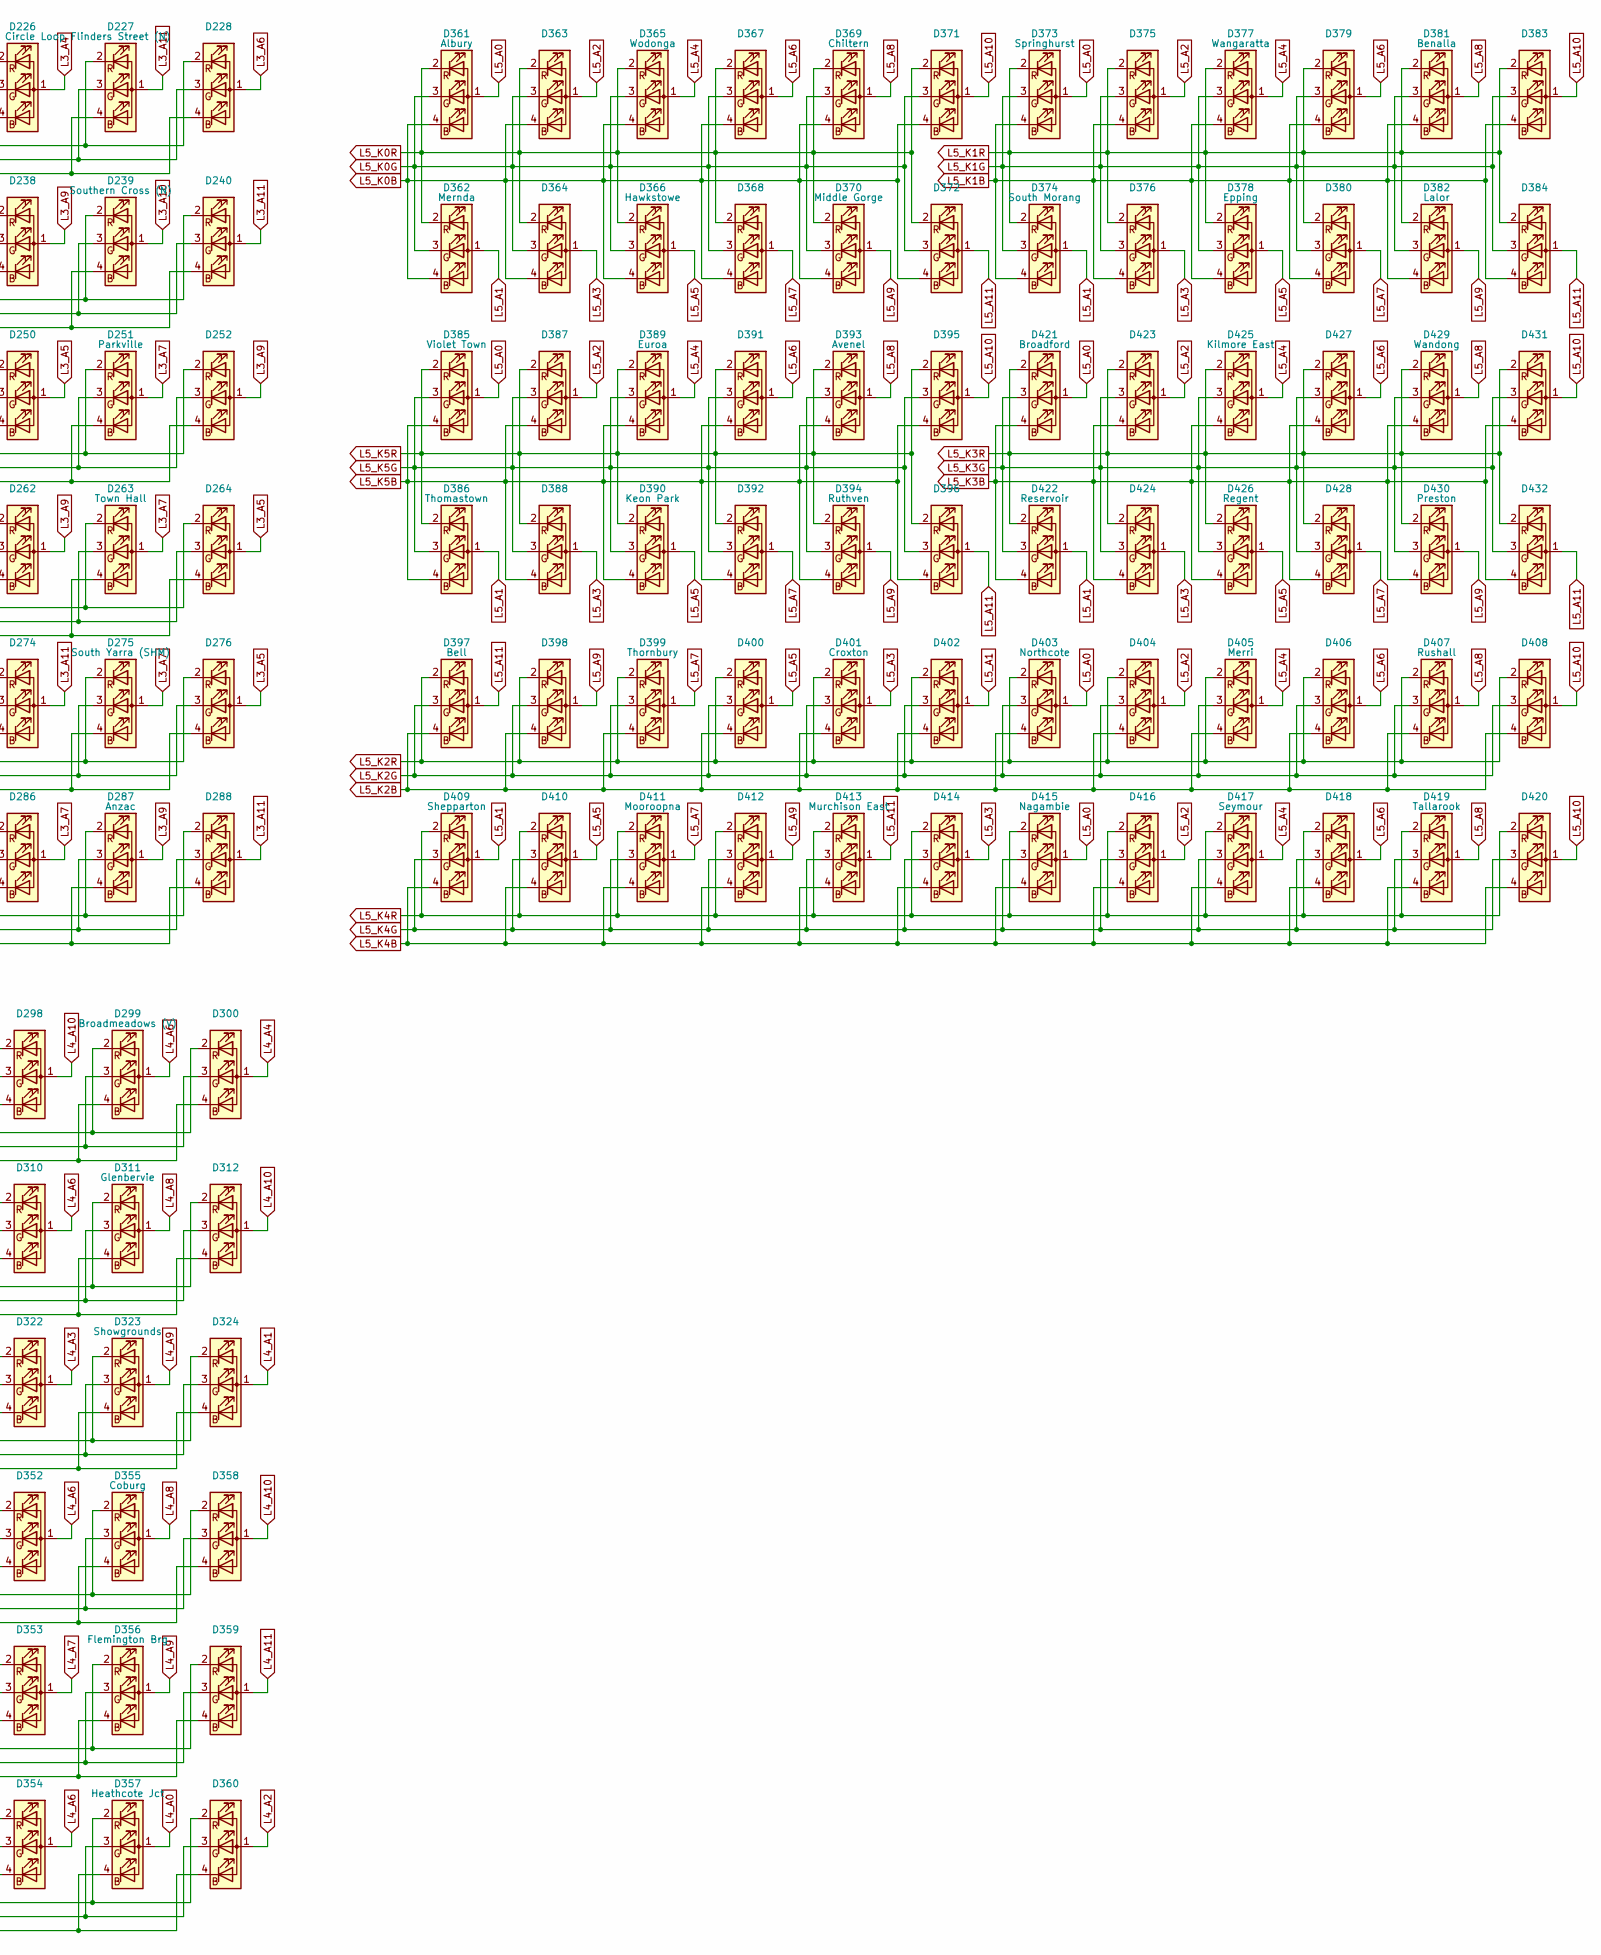
[picture p9: schematic city.kicad_sch, part in row 1, column 2]

Parts:
C19, C25, C31: 10uF; C_0805_2012Metric_Pad1.18x1.45mm_HandSolder; MPN C380332
C20, C22, C26, C28, C32, C34: 1uF; C_0603_1608Metric_Pad1.08x0.95mm_HandSolder; MPN C6119849
C21, C23, C24, C27, C29, C30, C33, C35, C36: 0.1uF; C_0603_1608Metric_Pad1.08x0.95mm_HandSolder; MPN C14663
D217, D218, D219, D220, D221, D222, D223, D224, D225, D226, D227, D228, D229, D230, D231, D232, D233, D234, D235, D236, D237, D238, D239, D240, D241, D242, D243, D244, D245, D246, D247, D248, D249, D250, D251, D252, D253, D254, D255, D256, D257, D258, D259, D260, D261, D262, D263, D264, D265, D266, D267, D268, D269, D270, D271, D272, D273, D274, D275, D276, D277, D278, D279, D280, D281, D282, D283, D284, D285, D286, D287, D288, D289, D290, D291, D292, D293, D294, D295, D296, D297, D298, D299, D300, D301, D302, D303, D304, D305, D306, D307, D308, D309, D310, D311, D312, D313, D314, D315, D316, D317, D318, D319, D320, D321, D322, D323, D324, D325, D326, D327, D328, D329, D330, D331, D332, D333, D334, D335, D336, D337, D338, D339, D340, D341, D342, D343, D344, D345, D346, D347, D348, D349, D350, D351, D352, D353, D354, D355, D356, D357, D358, D359, D360, D361, D362, D363, D364, D365, D366, D367, D368, D369, D370, D371, D372, D373, D374, D375, D376, D377, D378, D379, D380, D381, D382, D383, D384, D385, D386, D387, D388, D389, D390, D391, D392, D393, D394, D395, D396, D397, D398, D399, D400, D401, D402, D403, D404, D405, D406, D407, D408, D409, D410, D411, D412, D413, D414, D415, D416, D417, D418, D419, D420, D421, D422, D423, D424, D425, D426, D427, D428, D429, D430, D431, D432: XL-B1010RGBT-HF; LED_RGB_Xinglight-1010; MPN C22464515
R55, R56, R58, R59, R61, R62, R64, R65, R67, R68, R70, R71, R73, R74, R76, R77, R79, R80, R82, R83, R85, R86, R88, R89, R91, R92, R94, R95, R97, R98, R100, R101, R103, R104, R106, R107: 30R; R_0805_2012Metric_Pad1.20x1.40mm_HandSolder
R57, R60, R63, R66, R69, R72, R75, R78, R81, R84, R87, R90, R93, R96, R99, R102, R105, R108: 47R; R_0805_2012Metric_Pad1.20x1.40mm_HandSolder
R187, R188, R189: 10k; R_0603_1608Metric_Pad0.98x0.95mm_HandSolder; MPN C15401
U4, U5, U6: AW20216S; QFN-44-1EP_5x5mm_P0.4mm_EP2.45x2.45mm; MPN C7385556

Connections:
+3.3V: C22.2, C23.2, C28.2, C29.2, C34.2, C35.2, U4.24 (VCC), U5.24 (VCC), U6.24 (VCC); also elsewhere on the board
+5V: C19.2, C20.2, C21.2, C25.1, C26.2, C27.2, C31.2, C32.2, C33.2, U4.6 (PVCC), U5.6 (PVCC), U6.6 (PVCC); also elsewhere on the board
DRV_EN: C24.2, C30.2, C36.2, U4.29 (EN), U5.29 (EN), U6.29 (EN); also elsewhere on the board
GND: C19.1, C20.1, C21.1, C22.1, C23.1, C24.1, C25.2, C26.1, C27.1, C28.1, C29.1, C30.1, C31.1, C32.1, C33.1, C34.1, C35.1, C36.1, R187.1, R188.1, R189.1, U4.17 (PGND), U4.26 (GND), U4.39 (PGND), U4.45 (GND), U5.17 (PGND), U5.26 (GND), U5.39 (PGND), U5.45 (GND), U6.17 (PGND), U6.26 (GND), U6.39 (PGND), U6.45 (GND); also elsewhere on the board
L3_A0: D217.1 (A), D229.1 (A), D243.1 (A), D255.1 (A), D268.1 (A), D277.1 (A), U4.7 (SW1)
L3_A1: D220.1 (A), D230.1 (A), D245.1 (A), D257.1 (A), D270.1 (A), D283.1 (A), U4.5 (SW2)
L3_A2: D218.1 (A), D231.1 (A), D241.1 (A), D253.1 (A), D266.1 (A), D278.1 (A), U4.8 (SW3)
L3_A3: D219.1 (A), D232.1 (A), D247.1 (A), D259.1 (A), D272.1 (A), D282.1 (A), U4.4 (SW4)
L3_A4: D226.1 (A), D233.1 (A), D242.1 (A), D258.1 (A), D269.1 (A), D279.1 (A), U4.9 (SW5)
L3_A5: D221.1 (A), D234.1 (A), D250.1 (A), D264.1 (A), D276.1 (A), D285.1 (A), U4.3 (SW6)
L3_A6: D228.1 (A), D235.1 (A), D244.1 (A), D260.1 (A), D271.1 (A), D280.1 (A), U4.10 (SW7)
L3_A7: D223.1 (A), D236.1 (A), D251.1 (A), D263.1 (A), D275.1 (A), D286.1 (A), U4.2 (SW8)
L3_A8: D224.1 (A), D237.1 (A), D246.1 (A), D256.1 (A), D267.1 (A), D281.1 (A), U4.11 (SW9)
L3_A9: D225.1 (A), D238.1 (A), D252.1 (A), D262.1 (A), D273.1 (A), D287.1 (A), U4.1 (SW10)
L3_A10: D222.1 (A), D239.1 (A), D248.1 (A), D254.1 (A), D265.1 (A), D284.1 (A), U4.12 (SW11)
L3_A11: D227.1 (A), D240.1 (A), D249.1 (A), D261.1 (A), D274.1 (A), D288.1 (A), U4.44 (SW12)
L3_CS: U4.28 (CSN); also elsewhere on the board
L3_K0B: D229.4 (BK), D230.4 (BK), D231.4 (BK), D232.4 (BK), D233.4 (BK), D234.4 (BK), D235.4 (BK), D236.4 (BK), D237.4 (BK), D238.4 (BK), D239.4 (BK), D240.4 (BK), R55.1
L3_K0G: D229.3 (GK), D230.3 (GK), D231.3 (GK), D232.3 (GK), D233.3 (GK), D234.3 (GK), D235.3 (GK), D236.3 (GK), D237.3 (GK), D238.3 (GK), D239.3 (GK), D240.3 (GK), R56.2
L3_K0R: D229.2 (RK), D230.2 (RK), D231.2 (RK), D232.2 (RK), D233.2 (RK), D234.2 (RK), D235.2 (RK), D236.2 (RK), D237.2 (RK), D238.2 (RK), D239.2 (RK), D240.2 (RK), R57.2
L3_K1B: D217.4 (BK), D218.4 (BK), D219.4 (BK), D220.4 (BK), D221.4 (BK), D222.4 (BK), D223.4 (BK), D224.4 (BK), D225.4 (BK), D226.4 (BK), D227.4 (BK), D228.4 (BK), R58.2
L3_K1G: D217.3 (GK), D218.3 (GK), D219.3 (GK), D220.3 (GK), D221.3 (GK), D222.3 (GK), D223.3 (GK), D224.3 (GK), D225.3 (GK), D226.3 (GK), D227.3 (GK), D228.3 (GK), R59.2
L3_K1R: D217.2 (RK), D218.2 (RK), D219.2 (RK), D220.2 (RK), D221.2 (RK), D222.2 (RK), D223.2 (RK), D224.2 (RK), D225.2 (RK), D226.2 (RK), D227.2 (RK), D228.2 (RK), R60.2
L3_K2B: D265.4 (BK), D266.4 (BK), D267.4 (BK), D268.4 (BK), D269.4 (BK), D270.4 (BK), D271.4 (BK), D272.4 (BK), D273.4 (BK), D274.4 (BK), D275.4 (BK), D276.4 (BK), R61.2
L3_K2G: D265.3 (GK), D266.3 (GK), D267.3 (GK), D268.3 (GK), D269.3 (GK), D270.3 (GK), D271.3 (GK), D272.3 (GK), D273.3 (GK), D274.3 (GK), D275.3 (GK), D276.3 (GK), R62.2
L3_K2R: D265.2 (RK), D266.2 (RK), D267.2 (RK), D268.2 (RK), D269.2 (RK), D270.2 (RK), D271.2 (RK), D272.2 (RK), D273.2 (RK), D274.2 (RK), D275.2 (RK), D276.2 (RK), R63.2
L3_K3B: D277.4 (BK), D278.4 (BK), D279.4 (BK), D280.4 (BK), D281.4 (BK), D282.4 (BK), D283.4 (BK), D284.4 (BK), D285.4 (BK), D286.4 (BK), D287.4 (BK), D288.4 (BK), R64.2
L3_K3G: D277.3 (GK), D278.3 (GK), D279.3 (GK), D280.3 (GK), D281.3 (GK), D282.3 (GK), D283.3 (GK), D284.3 (GK), D285.3 (GK), D286.3 (GK), D287.3 (GK), D288.3 (GK), R65.2
L3_K3R: D277.2 (RK), D278.2 (RK), D279.2 (RK), D280.2 (RK), D281.2 (RK), D282.2 (RK), D283.2 (RK), D284.2 (RK), D285.2 (RK), D286.2 (RK), D287.2 (RK), D288.2 (RK), R66.2
L3_K4B: D241.4 (BK), D242.4 (BK), D243.4 (BK), D244.4 (BK), D245.4 (BK), D246.4 (BK), D247.4 (BK), D248.4 (BK), D249.4 (BK), D250.4 (BK), D251.4 (BK), D252.4 (BK), R67.2
L3_K4G: D241.3 (GK), D242.3 (GK), D243.3 (GK), D244.3 (GK), D245.3 (GK), D246.3 (GK), D247.3 (GK), D248.3 (GK), D249.3 (GK), D250.3 (GK), D251.3 (GK), D252.3 (GK), R68.2
L3_K4R: D241.2 (RK), D242.2 (RK), D243.2 (RK), D244.2 (RK), D245.2 (RK), D246.2 (RK), D247.2 (RK), D248.2 (RK), D249.2 (RK), D250.2 (RK), D251.2 (RK), D252.2 (RK), R69.2
L3_K5B: D253.4 (BK), D254.4 (BK), D255.4 (BK), D256.4 (BK), D257.4 (BK), D258.4 (BK), D259.4 (BK), D260.4 (BK), D261.4 (BK), D262.4 (BK), D263.4 (BK), D264.4 (BK), R70.2
L3_K5G: D253.3 (GK), D254.3 (GK), D255.3 (GK), D256.3 (GK), D257.3 (GK), D258.3 (GK), D259.3 (GK), D260.3 (GK), D261.3 (GK), D262.3 (GK), D263.3 (GK), D264.3 (GK), R71.2
L3_K5R: D253.2 (RK), D254.2 (RK), D255.2 (RK), D256.2 (RK), D257.2 (RK), D258.2 (RK), D259.2 (RK), D260.2 (RK), D261.2 (RK), D262.2 (RK), D263.2 (RK), D264.2 (RK), R72.2
L4_A0: D295.1 (A), D307.1 (A), D313.1 (A), D341.1 (A), D343.1 (A), D357.1 (A), U5.7 (SW1)
L4_A1: D294.1 (A), D306.1 (A), D324.1 (A), D333.1 (A), D340.1 (A), D344.1 (A), U5.5 (SW2)
L4_A2: D296.1 (A), D308.1 (A), D314.1 (A), D338.1 (A), D346.1 (A), D360.1 (A), U5.8 (SW3)
L4_A3: D293.1 (A), D305.1 (A), D322.1 (A), D336.1 (A), D337.1 (A), D347.1 (A), U5.4 (SW4)
L4_A4: D300.1 (A), D309.1 (A), D315.1 (A), D335.1 (A), D349.1 (A), D351.1 (A), U5.9 (SW5)
L4_A5: D290.1 (A), D304.1 (A), D321.1 (A), D334.1 (A), D339.1 (A), D350.1 (A), U5.3 (SW6)
L4_A6: D299.1 (A), D310.1 (A), D319.1 (A), D332.1 (A), D352.1 (A), D354.1 (A), U5.10 (SW7)
L4_A7: D289.1 (A), D303.1 (A), D316.1 (A), D331.1 (A), D342.1 (A), D353.1 (A), U5.2 (SW8)
L4_A8: D297.1 (A), D311.1 (A), D317.1 (A), D329.1 (A), D345.1 (A), D355.1 (A), U5.11 (SW9)
L4_A9: D291.1 (A), D302.1 (A), D323.1 (A), D328.1 (A), D330.1 (A), D356.1 (A), U5.1 (SW10)
L4_A10: D298.1 (A), D312.1 (A), D318.1 (A), D326.1 (A), D348.1 (A), D358.1 (A), U5.12 (SW11)
L4_A11: D292.1 (A), D301.1 (A), D320.1 (A), D325.1 (A), D327.1 (A), D359.1 (A), U5.44 (SW12)
L4_CS: U5.28 (CSN); also elsewhere on the board
L4_K0B: D289.4 (BK), D290.4 (BK), D291.4 (BK), D292.4 (BK), D293.4 (BK), D294.4 (BK), D295.4 (BK), D296.4 (BK), D297.4 (BK), D298.4 (BK), D299.4 (BK), D300.4 (BK), R73.1
L4_K0G: D289.3 (GK), D290.3 (GK), D291.3 (GK), D292.3 (GK), D293.3 (GK), D294.3 (GK), D295.3 (GK), D296.3 (GK), D297.3 (GK), D298.3 (GK), D299.3 (GK), D300.3 (GK), R74.2
L4_K0R: D289.2 (RK), D290.2 (RK), D291.2 (RK), D292.2 (RK), D293.2 (RK), D294.2 (RK), D295.2 (RK), D296.2 (RK), D297.2 (RK), D298.2 (RK), D299.2 (RK), D300.2 (RK), R75.2
L4_K1B: D301.4 (BK), D302.4 (BK), D303.4 (BK), D304.4 (BK), D305.4 (BK), D306.4 (BK), D307.4 (BK), D308.4 (BK), D309.4 (BK), D310.4 (BK), D311.4 (BK), D312.4 (BK), R76.2
L4_K1G: D301.3 (GK), D302.3 (GK), D303.3 (GK), D304.3 (GK), D305.3 (GK), D306.3 (GK), D307.3 (GK), D308.3 (GK), D309.3 (GK), D310.3 (GK), D311.3 (GK), D312.3 (GK), R77.2
L4_K1R: D301.2 (RK), D302.2 (RK), D303.2 (RK), D304.2 (RK), D305.2 (RK), D306.2 (RK), D307.2 (RK), D308.2 (RK), D309.2 (RK), D310.2 (RK), D311.2 (RK), D312.2 (RK), R78.2
L4_K2B: D313.4 (BK), D314.4 (BK), D315.4 (BK), D316.4 (BK), D317.4 (BK), D318.4 (BK), D319.4 (BK), D320.4 (BK), D321.4 (BK), D322.4 (BK), D323.4 (BK), D324.4 (BK), R79.2
L4_K2G: D313.3 (GK), D314.3 (GK), D315.3 (GK), D316.3 (GK), D317.3 (GK), D318.3 (GK), D319.3 (GK), D320.3 (GK), D321.3 (GK), D322.3 (GK), D323.3 (GK), D324.3 (GK), R80.2
L4_K2R: D313.2 (RK), D314.2 (RK), D315.2 (RK), D316.2 (RK), D317.2 (RK), D318.2 (RK), D319.2 (RK), D320.2 (RK), D321.2 (RK), D322.2 (RK), D323.2 (RK), D324.2 (RK), R81.2
L4_K3B: D327.4 (BK), D330.4 (BK), D333.4 (BK), D336.4 (BK), D339.4 (BK), D342.4 (BK), D345.4 (BK), D348.4 (BK), D351.4 (BK), D354.4 (BK), D357.4 (BK), D360.4 (BK), R82.2
L4_K3G: D327.3 (GK), D330.3 (GK), D333.3 (GK), D336.3 (GK), D339.3 (GK), D342.3 (GK), D345.3 (GK), D348.3 (GK), D351.3 (GK), D354.3 (GK), D357.3 (GK), D360.3 (GK), R83.2
L4_K3R: D327.2 (RK), D330.2 (RK), D333.2 (RK), D336.2 (RK), D339.2 (RK), D342.2 (RK), D345.2 (RK), D348.2 (RK), D351.2 (RK), D354.2 (RK), D357.2 (RK), D360.2 (RK), R84.2
L4_K4B: D326.4 (BK), D329.4 (BK), D332.4 (BK), D335.4 (BK), D338.4 (BK), D341.4 (BK), D344.4 (BK), D347.4 (BK), D350.4 (BK), D353.4 (BK), D356.4 (BK), D359.4 (BK), R85.2
L4_K4G: D326.3 (GK), D329.3 (GK), D332.3 (GK), D335.3 (GK), D338.3 (GK), D341.3 (GK), D344.3 (GK), D347.3 (GK), D350.3 (GK), D353.3 (GK), D356.3 (GK), D359.3 (GK), R86.2
L4_K4R: D326.2 (RK), D329.2 (RK), D332.2 (RK), D335.2 (RK), D338.2 (RK), D341.2 (RK), D344.2 (RK), D347.2 (RK), D350.2 (RK), D353.2 (RK), D356.2 (RK), D359.2 (RK), R87.2
L4_K5B: D325.4 (BK), D328.4 (BK), D331.4 (BK), D334.4 (BK), D337.4 (BK), D340.4 (BK), D343.4 (BK), D346.4 (BK), D349.4 (BK), D352.4 (BK), D355.4 (BK), D358.4 (BK), R88.2
L4_K5G: D325.3 (GK), D328.3 (GK), D331.3 (GK), D334.3 (GK), D337.3 (GK), D340.3 (GK), D343.3 (GK), D346.3 (GK), D349.3 (GK), D352.3 (GK), D355.3 (GK), D358.3 (GK), R89.2
L4_K5R: D325.2 (RK), D328.2 (RK), D331.2 (RK), D334.2 (RK), D337.2 (RK), D340.2 (RK), D343.2 (RK), D346.2 (RK), D349.2 (RK), D352.2 (RK), D355.2 (RK), D358.2 (RK), R90.2
L5_A0: D361.1 (A), D373.1 (A), D385.1 (A), D403.1 (A), D415.1 (A), D421.1 (A), U6.7 (SW1)
L5_A1: D362.1 (A), D374.1 (A), D386.1 (A), D402.1 (A), D409.1 (A), D422.1 (A), U6.5 (SW2)
L5_A2: D363.1 (A), D375.1 (A), D387.1 (A), D404.1 (A), D416.1 (A), D423.1 (A), U6.8 (SW3)
L5_A3: D364.1 (A), D376.1 (A), D388.1 (A), D401.1 (A), D414.1 (A), D424.1 (A), U6.4 (SW4)
L5_A4: D365.1 (A), D377.1 (A), D389.1 (A), D405.1 (A), D417.1 (A), D425.1 (A), U6.9 (SW5)
L5_A5: D366.1 (A), D378.1 (A), D390.1 (A), D400.1 (A), D410.1 (A), D426.1 (A), U6.3 (SW6)
L5_A6: D367.1 (A), D379.1 (A), D391.1 (A), D406.1 (A), D418.1 (A), D427.1 (A), U6.10 (SW7)
L5_A7: D368.1 (A), D380.1 (A), D392.1 (A), D399.1 (A), D411.1 (A), D428.1 (A), U6.2 (SW8)
L5_A8: D369.1 (A), D381.1 (A), D393.1 (A), D407.1 (A), D419.1 (A), D429.1 (A), U6.11 (SW9)
L5_A9: D370.1 (A), D382.1 (A), D394.1 (A), D398.1 (A), D412.1 (A), D430.1 (A), U6.1 (SW10)
L5_A10: D371.1 (A), D383.1 (A), D395.1 (A), D408.1 (A), D420.1 (A), D431.1 (A), U6.12 (SW11)
L5_A11: D372.1 (A), D384.1 (A), D396.1 (A), D397.1 (A), D413.1 (A), D432.1 (A), U6.44 (SW12)
L5_CS: U6.28 (CSN); also elsewhere on the board
L5_K0B: D361.4 (BK), D362.4 (BK), D363.4 (BK), D364.4 (BK), D365.4 (BK), D366.4 (BK), D367.4 (BK), D368.4 (BK), D369.4 (BK), D370.4 (BK), D371.4 (BK), D372.4 (BK), R91.1
L5_K0G: D361.3 (GK), D362.3 (GK), D363.3 (GK), D364.3 (GK), D365.3 (GK), D366.3 (GK), D367.3 (GK), D368.3 (GK), D369.3 (GK), D370.3 (GK), D371.3 (GK), D372.3 (GK), R92.2
L5_K0R: D361.2 (RK), D362.2 (RK), D363.2 (RK), D364.2 (RK), D365.2 (RK), D366.2 (RK), D367.2 (RK), D368.2 (RK), D369.2 (RK), D370.2 (RK), D371.2 (RK), D372.2 (RK), R93.2
L5_K1B: D373.4 (BK), D374.4 (BK), D375.4 (BK), D376.4 (BK), D377.4 (BK), D378.4 (BK), D379.4 (BK), D380.4 (BK), D381.4 (BK), D382.4 (BK), D383.4 (BK), D384.4 (BK), R94.2
L5_K1G: D373.3 (GK), D374.3 (GK), D375.3 (GK), D376.3 (GK), D377.3 (GK), D378.3 (GK), D379.3 (GK), D380.3 (GK), D381.3 (GK), D382.3 (GK), D383.3 (GK), D384.3 (GK), R95.2
L5_K1R: D373.2 (RK), D374.2 (RK), D375.2 (RK), D376.2 (RK), D377.2 (RK), D378.2 (RK), D379.2 (RK), D380.2 (RK), D381.2 (RK), D382.2 (RK), D383.2 (RK), D384.2 (RK), R96.2
L5_K2B: D397.4 (BK), D398.4 (BK), D399.4 (BK), D400.4 (BK), D401.4 (BK), D402.4 (BK), D403.4 (BK), D404.4 (BK), D405.4 (BK), D406.4 (BK), D407.4 (BK), D408.4 (BK), R97.2
L5_K2G: D397.3 (GK), D398.3 (GK), D399.3 (GK), D400.3 (GK), D401.3 (GK), D402.3 (GK), D403.3 (GK), D404.3 (GK), D405.3 (GK), D406.3 (GK), D407.3 (GK), D408.3 (GK), R98.2
L5_K2R: D397.2 (RK), D398.2 (RK), D399.2 (RK), D400.2 (RK), D401.2 (RK), D402.2 (RK), D403.2 (RK), D404.2 (RK), D405.2 (RK), D406.2 (RK), D407.2 (RK), D408.2 (RK), R99.2
L5_K3B: D421.4 (BK), D422.4 (BK), D423.4 (BK), D424.4 (BK), D425.4 (BK), D426.4 (BK), D427.4 (BK), D428.4 (BK), D429.4 (BK), D430.4 (BK), D431.4 (BK), D432.4 (BK), R100.2
L5_K3G: D421.3 (GK), D422.3 (GK), D423.3 (GK), D424.3 (GK), D425.3 (GK), D426.3 (GK), D427.3 (GK), D428.3 (GK), D429.3 (GK), D430.3 (GK), D431.3 (GK), D432.3 (GK), R101.2
L5_K3R: D421.2 (RK), D422.2 (RK), D423.2 (RK), D424.2 (RK), D425.2 (RK), D426.2 (RK), D427.2 (RK), D428.2 (RK), D429.2 (RK), D430.2 (RK), D431.2 (RK), D432.2 (RK), R102.2
L5_K4B: D409.4 (BK), D410.4 (BK), D411.4 (BK), D412.4 (BK), D413.4 (BK), D414.4 (BK), D415.4 (BK), D416.4 (BK), D417.4 (BK), D418.4 (BK), D419.4 (BK), D420.4 (BK), R103.2
L5_K4G: D409.3 (GK), D410.3 (GK), D411.3 (GK), D412.3 (GK), D413.3 (GK), D414.3 (GK), D415.3 (GK), D416.3 (GK), D417.3 (GK), D418.3 (GK), D419.3 (GK), D420.3 (GK), R104.2
L5_K4R: D409.2 (RK), D410.2 (RK), D411.2 (RK), D412.2 (RK), D413.2 (RK), D414.2 (RK), D415.2 (RK), D416.2 (RK), D417.2 (RK), D418.2 (RK), D419.2 (RK), D420.2 (RK), R105.2
L5_K5B: D385.4 (BK), D386.4 (BK), D387.4 (BK), D388.4 (BK), D389.4 (BK), D390.4 (BK), D391.4 (BK), D392.4 (BK), D393.4 (BK), D394.4 (BK), D395.4 (BK), D396.4 (BK), R106.2
L5_K5G: D385.3 (GK), D386.3 (GK), D387.3 (GK), D388.3 (GK), D389.3 (GK), D390.3 (GK), D391.3 (GK), D392.3 (GK), D393.3 (GK), D394.3 (GK), D395.3 (GK), D396.3 (GK), R107.2
L5_K5R: D385.2 (RK), D386.2 (RK), D387.2 (RK), D388.2 (RK), D389.2 (RK), D390.2 (RK), D391.2 (RK), D392.2 (RK), D393.2 (RK), D394.2 (RK), D395.2 (RK), D396.2 (RK), R108.2
MISO_A: U4.27 (MISO); also elsewhere on the board
MISO_B: U5.27 (MISO), U6.27 (MISO); also elsewhere on the board
MOSI_A: U4.31 (MOSI); also elsewhere on the board
MOSI_B: U5.31 (MOSI), U6.31 (MOSI); also elsewhere on the board
unnamed: R55.2, U4.43 (CS1)
unnamed: R56.1, U4.42 (CS2)
unnamed: R57.1, U4.41 (CS3)
unnamed: R58.1, U4.40 (CS4)
unnamed: R59.1, U4.38 (CS5)
unnamed: R60.1, U4.37 (CS6)
unnamed: R61.1, U4.36 (CS7)
unnamed: R62.1, U4.35 (CS8)
unnamed: R63.1, U4.34 (CS9)
unnamed: R64.1, U4.22 (CS10)
unnamed: R65.1, U4.21 (CS11)
unnamed: R66.1, U4.20 (CS12)
unnamed: R67.1, U4.19 (CS13)
unnamed: R68.1, U4.18 (CS14)
unnamed: R69.1, U4.16 (CS15)
unnamed: R70.1, U4.15 (CS16)
unnamed: R71.1, U4.14 (CS17)
unnamed: R72.1, U4.13 (CS18)
unnamed: R187.2, U4.32 (ISET)
unnamed: R73.2, U5.43 (CS1)
unnamed: R74.1, U5.42 (CS2)
unnamed: R75.1, U5.41 (CS3)
unnamed: R76.1, U5.40 (CS4)
unnamed: R77.1, U5.38 (CS5)
unnamed: R78.1, U5.37 (CS6)
unnamed: R79.1, U5.36 (CS7)
unnamed: R80.1, U5.35 (CS8)
unnamed: R81.1, U5.34 (CS9)
unnamed: R82.1, U5.22 (CS10)
unnamed: R83.1, U5.21 (CS11)
unnamed: R84.1, U5.20 (CS12)
unnamed: R85.1, U5.19 (CS13)
unnamed: R86.1, U5.18 (CS14)
unnamed: R87.1, U5.16 (CS15)
unnamed: R88.1, U5.15 (CS16)
unnamed: R89.1, U5.14 (CS17)
unnamed: R90.1, U5.13 (CS18)
unnamed: R188.2, U5.32 (ISET)
unnamed: R91.2, U6.43 (CS1)
unnamed: R92.1, U6.42 (CS2)
unnamed: R93.1, U6.41 (CS3)
unnamed: R94.1, U6.40 (CS4)
unnamed: R95.1, U6.38 (CS5)
unnamed: R96.1, U6.37 (CS6)
unnamed: R97.1, U6.36 (CS7)
unnamed: R98.1, U6.35 (CS8)
unnamed: R99.1, U6.34 (CS9)
unnamed: R100.1, U6.22 (CS10)
unnamed: R101.1, U6.21 (CS11)
unnamed: R102.1, U6.20 (CS12)
unnamed: R103.1, U6.19 (CS13)
unnamed: R104.1, U6.18 (CS14)
unnamed: R105.1, U6.16 (CS15)
unnamed: R106.1, U6.15 (CS16)
unnamed: R107.1, U6.14 (CS17)
unnamed: R108.1, U6.13 (CS18)
unnamed: R189.2, U6.32 (ISET)
SCK_A: U4.30 (SCK); also elsewhere on the board
SCK_B: U5.30 (SCK), U6.30 (SCK); also elsewhere on the board

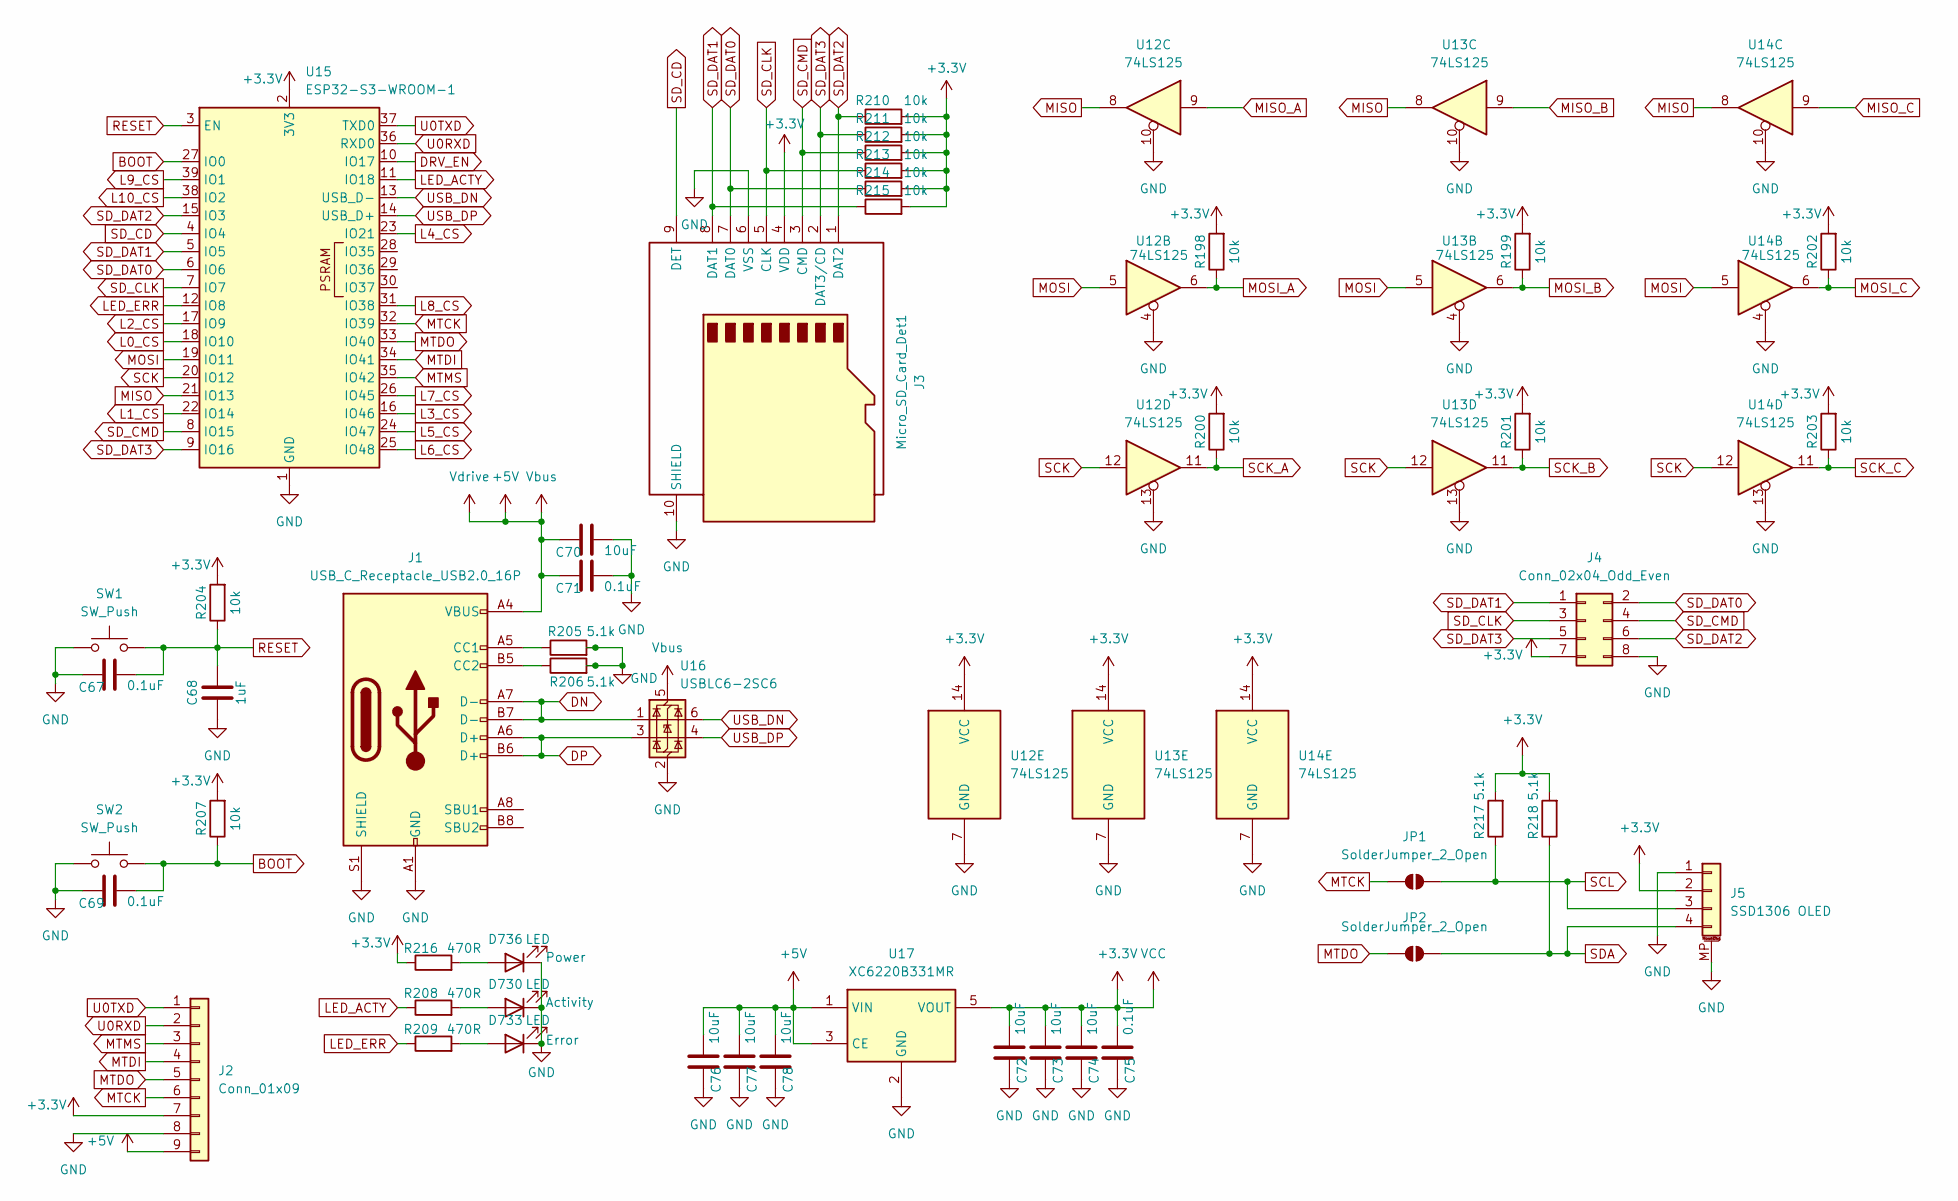
[picture p10: schematic ctrl.kicad_sch]

Parts:
C67, C69, C71, C75: 0.1uF; C_0603_1608Metric_Pad1.08x0.95mm_HandSolder; MPN C14663
C68: 1uF; C_0603_1608Metric_Pad1.08x0.95mm_HandSolder; MPN C6119849
C70, C72, C73, C74, C76, C77, C78: 10uF; C_0805_2012Metric_Pad1.18x1.45mm_HandSolder; MPN C380332
D730, D733, D736: LED; LED_1206_3216Metric_Pad1.42x1.75mm_HandSolder; MPN C965822
J1: USB_C_Receptacle_USB2.0_16P; ShouHan-USBC-16P-2MD; MPN C2765186
J2: Conn_01x09; PinHeader_1x09_P2.54mm_Vertical; MPN C49451372
J3: Micro_SD_Card_Det1; TFW11-N1S1-2000-A; MPN C22357898
J4: Conn_02x04_Odd_Even; PinHeader_2x04_P2.54mm_Vertical
J5: SSD1306 OLED; HS96L03W2C03
JP1, JP2: SolderJumper_2_Open; SolderJumper-2_P1.3mm_Open_TrianglePad1.0x1.5mm
R198, R199, R200, R201, R202, R203, R204, R207, R210, R211, R212, R213, R214, R215: 10k; R_0603_1608Metric_Pad0.98x0.95mm_HandSolder; MPN C15401
R205, R206, R217, R218: 5.1k; R_0603_1608Metric_Pad0.98x0.95mm_HandSolder; MPN C328370
R208, R209: 470R; R_0603_1608Metric_Pad0.98x0.95mm_HandSolder; MPN C23179
R216: 470R; R_0603_1608Metric_Pad0.98x0.95mm_HandSolder; MPN C2907127
SW1, SW2: SW_Push; SW_Push_1P1T_NO_E-Switch_TL3301NxxxxxG; MPN C5342967
U12, U13, U14: 74LS125; SO-14_3.9x8.65mm_P1.27mm; MPN C5138994
U15: ESP32-S3-WROOM-1; MPN C2913201
U16: USBLC6-2SC6; SOT-23-6
U17: XC6220B331MR; SOT-23-5

Connections:
+3.3V: C72.2, C73.2, C74.2, C75.2, J2.7, J3.4 (VDD), J4.7, J5.2, R198.2, R199.2, R200.2, R201.2, R202.2, R203.2, R204.2, R207.2, R210.2, R211.2, R212.2, R213.2, R214.2, R215.2, R216.1, R217.2, R218.2, U12.14 (VCC), U13.14 (VCC), U14.14 (VCC), U15.2 (3V3), U17.5 (VOUT); also elsewhere on the board
+5V: C70.1, C71.1, C76.2, C77.2, C78.2, J1.A4 (VBUS), J1.A9 (VBUS), J1.B4 (VBUS), J1.B9 (VBUS), J2.9, U16.5 (VBUS), U17.1 (VIN), U17.3 (CE); also elsewhere on the board
BOOT: C69.2, R207.1, SW2.2, U15.27 (IO0)
DN: J1.A7 (D-), J1.B7 (D-), U16.1 (I/O1)
DP: J1.A6 (D+), J1.B6 (D+), U16.3 (I/O2)
DRV_EN: U15.10 (IO17); also elsewhere on the board
GND: C67.1, C68.1, C69.1, C70.2, C71.2, C72.1, C73.1, C74.1, C75.1, C76.1, C77.1, C78.1, D730.1 (K), D733.1 (K), D736.1 (K), J1.A1 (GND), J1.A12 (GND), J1.B1 (GND), J1.B12 (GND), J1.S1 (SHIELD), J2.8, J3.6 (VSS), J3.10 (SHIELD), J4.8, J5.1, J5.MP (MountPin), R205.2, R206.2, SW1.1, SW2.1, U12.4, U12.7 (GND), U12.10, U12.13, U13.4, U13.7 (GND), U13.10, U13.13, U14.4, U14.7 (GND), U14.10, U14.13, U15.1 (GND), U15.40 (GND), U15.41 (GND), U16.2 (GND), U17.2 (GND); also elsewhere on the board
L0_CS: U15.18 (IO10); also elsewhere on the board
L1_CS: U15.22 (IO14); also elsewhere on the board
L2_CS: U15.17 (IO9); also elsewhere on the board
L3_CS: U15.16 (IO46); also elsewhere on the board
L4_CS: U15.23 (IO21); also elsewhere on the board
L5_CS: U15.24 (IO47); also elsewhere on the board
L6_CS: U15.25 (IO48); also elsewhere on the board
L7_CS: U15.26 (IO45); also elsewhere on the board
L8_CS: U15.31 (IO38); also elsewhere on the board
L9_CS: U15.39 (IO1); also elsewhere on the board
L10_CS: U15.38 (IO2); also elsewhere on the board
LED_ACTY: R208.1, U15.11 (IO18)
LED_ERR: R209.1, U15.12 (IO8)
MISO: U12.8, U13.8, U14.8, U15.21 (IO13)
MISO_A: U12.9; also elsewhere on the board
MISO_B: U13.9; also elsewhere on the board
MISO_C: U14.9; also elsewhere on the board
MOSI: U12.5, U13.5, U14.5, U15.19 (IO11)
MOSI_A: R198.1, U12.6; also elsewhere on the board
MOSI_B: R199.1, U13.6; also elsewhere on the board
MOSI_C: R202.1, U14.6; also elsewhere on the board
MTCK: J2.6, JP1.1 (A), U15.32 (IO39)
MTDI: J2.4, U15.34 (IO41)
MTDO: J2.5, JP2.1 (A), U15.33 (IO40)
MTMS: J2.3, U15.35 (IO42)
unnamed: D730.2 (A), R208.2
unnamed: D733.2 (A), R209.2
unnamed: D736.2 (A), R216.2
unnamed: J1.A5 (CC1), R205.1
unnamed: J1.B5 (CC2), R206.1
RESET: C67.2, C68.2, R204.1, SW1.2, U15.3 (EN)
SCK: U12.12, U13.12, U14.12, U15.20 (IO12)
SCK_A: R200.1, U12.11; also elsewhere on the board
SCK_B: R201.1, U13.11; also elsewhere on the board
SCK_C: R203.1, U14.11; also elsewhere on the board
SCL: J5.3, JP1.2 (B), R217.1
SDA: J5.4, JP2.2 (B), R218.1
SD_CD: J3.9 (DET), U15.4 (IO4)
SD_CLK: J3.5 (CLK), J4.3, R213.1, U15.7 (IO7)
SD_CMD: J3.3 (CMD), J4.4, R212.1, U15.8 (IO15)
SD_DAT0: J3.7 (DAT0), J4.2, R214.1, U15.6 (IO6)
SD_DAT1: J3.8 (DAT1), J4.1, R215.1, U15.5 (IO5)
SD_DAT2: J3.1 (DAT2), J4.6, R210.1, U15.15 (IO3)
SD_DAT3: J3.2 (DAT3/CD), J4.5, R211.1, U15.9 (IO16)
U0RXD: J2.2, U15.36 (RXD0)
U0TXD: J2.1, U15.37 (TXD0)
USB_DN: U15.13 (USB_D-), U16.6 (I/O1)
USB_DP: U15.14 (USB_D+), U16.4 (I/O2)
