itsmevjnk/MelbourneTrainTracker/Hardware/Rev2/Rev2.kicad_pcb

## KiCad design Hardware/Rev2/Rev2.kicad_pcb (continued)

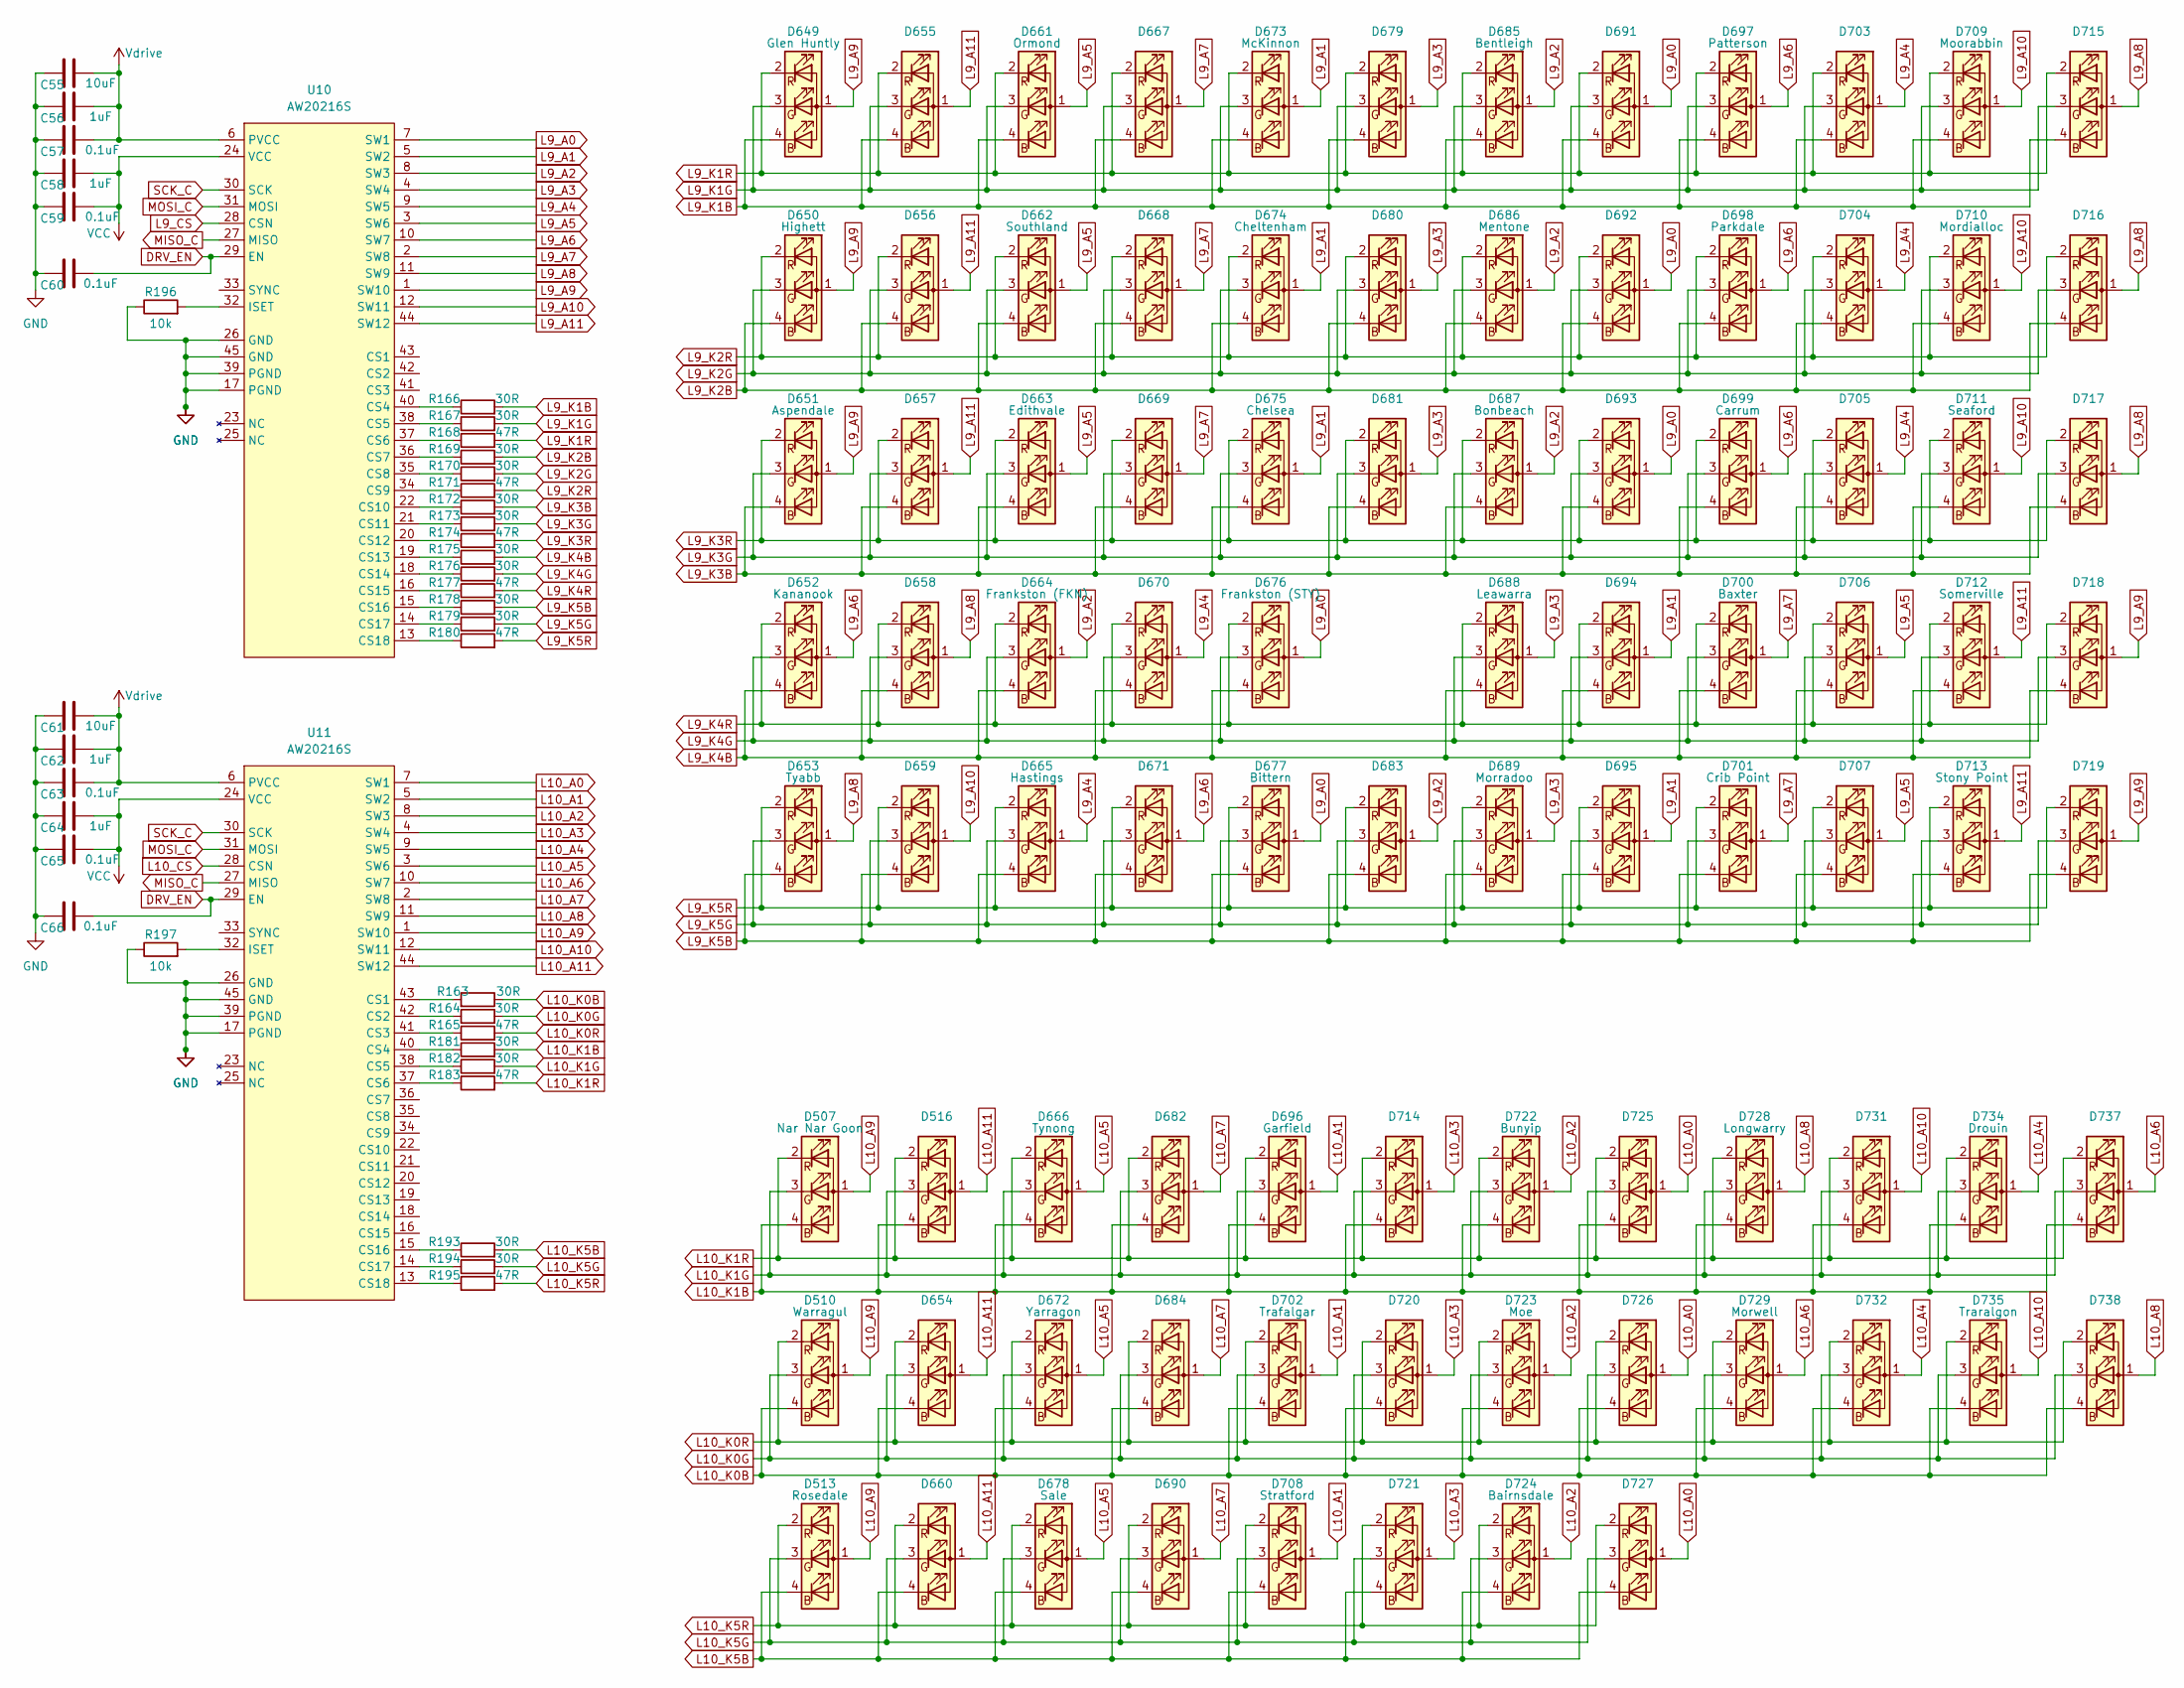
[picture p11: schematic led4.kicad_sch]

Parts:
C55, C61: 10uF; C_0805_2012Metric_Pad1.18x1.45mm_HandSolder; MPN C380332
C56, C58, C62, C64: 1uF; C_0603_1608Metric_Pad1.08x0.95mm_HandSolder; MPN C6119849
C57, C59, C60, C63, C65, C66: 0.1uF; C_0603_1608Metric_Pad1.08x0.95mm_HandSolder; MPN C14663
D507, D510, D513, D516, D649, D650, D651, D652, D653, D654, D655, D656, D657, D658, D659, D660, D661, D662, D663, D664, D665, D666, D667, D668, D669, D670, D671, D672, D673, D674, D675, D676, D677, D678, D679, D680, D681, D682, D683, D684, D685, D686, D687, D688, D689, D690, D691, D692, D693, D694, D695, D696, D697, D698, D699, D700, D701, D702, D703, D704, D705, D706, D707, D708, D709, D710, D711, D712, D713, D714, D715, D716, D717, D718, D719, D720, D721, D722, D723, D724, D725, D726, D727, D728, D729, D731, D732, D734, D735, D737, D738: XL-B1010RGBT-HF; LED_RGB_Xinglight-1010; MPN C22464515
R163, R164, R166, R167, R169, R170, R172, R173, R175, R176, R178, R179, R181, R182, R193, R194: 30R; R_0805_2012Metric_Pad1.20x1.40mm_HandSolder
R165, R168, R171, R174, R177, R180, R183, R195: 47R; R_0805_2012Metric_Pad1.20x1.40mm_HandSolder
R196, R197: 10k; R_0603_1608Metric_Pad0.98x0.95mm_HandSolder; MPN C15401
U10, U11: AW20216S; QFN-44-1EP_5x5mm_P0.4mm_EP2.45x2.45mm; MPN C7385556

Connections:
+3.3V: C58.2, C59.2, C64.2, C65.2, U10.24 (VCC), U11.24 (VCC); also elsewhere on the board
+5V: C55.2, C56.2, C57.2, C61.2, C62.2, C63.2, U10.6 (PVCC), U11.6 (PVCC); also elsewhere on the board
DRV_EN: C60.2, C66.2, U10.29 (EN), U11.29 (EN); also elsewhere on the board
GND: C55.1, C56.1, C57.1, C58.1, C59.1, C60.1, C61.1, C62.1, C63.1, C64.1, C65.1, C66.1, R196.1, R197.1, U10.17 (PGND), U10.26 (GND), U10.39 (PGND), U10.45 (GND), U11.17 (PGND), U11.26 (GND), U11.39 (PGND), U11.45 (GND); also elsewhere on the board
L9_A0: D676.1 (A), D677.1 (A), D691.1 (A), D692.1 (A), D693.1 (A), U10.7 (SW1)
L9_A1: D673.1 (A), D674.1 (A), D675.1 (A), D694.1 (A), D695.1 (A), U10.5 (SW2)
L9_A2: D664.1 (A), D683.1 (A), D685.1 (A), D686.1 (A), D687.1 (A), U10.8 (SW3)
L9_A3: D679.1 (A), D680.1 (A), D681.1 (A), D688.1 (A), D689.1 (A), U10.4 (SW4)
L9_A4: D665.1 (A), D670.1 (A), D703.1 (A), D704.1 (A), D705.1 (A), U10.9 (SW5)
L9_A5: D661.1 (A), D662.1 (A), D663.1 (A), D706.1 (A), D707.1 (A), U10.3 (SW6)
L9_A6: D652.1 (A), D671.1 (A), D697.1 (A), D698.1 (A), D699.1 (A), U10.10 (SW7)
L9_A7: D667.1 (A), D668.1 (A), D669.1 (A), D700.1 (A), D701.1 (A), U10.2 (SW8)
L9_A8: D653.1 (A), D658.1 (A), D715.1 (A), D716.1 (A), D717.1 (A), U10.11 (SW9)
L9_A9: D649.1 (A), D650.1 (A), D651.1 (A), D718.1 (A), D719.1 (A), U10.1 (SW10)
L9_A10: D659.1 (A), D709.1 (A), D710.1 (A), D711.1 (A), U10.12 (SW11)
L9_A11: D655.1 (A), D656.1 (A), D657.1 (A), D712.1 (A), D713.1 (A), U10.44 (SW12)
L9_CS: U10.28 (CSN); also elsewhere on the board
L9_K1B: D649.4 (BK), D655.4 (BK), D661.4 (BK), D667.4 (BK), D673.4 (BK), D679.4 (BK), D685.4 (BK), D691.4 (BK), D697.4 (BK), D703.4 (BK), D709.4 (BK), D715.4 (BK), R166.2
L9_K1G: D649.3 (GK), D655.3 (GK), D661.3 (GK), D667.3 (GK), D673.3 (GK), D679.3 (GK), D685.3 (GK), D691.3 (GK), D697.3 (GK), D703.3 (GK), D709.3 (GK), D715.3 (GK), R167.2
L9_K1R: D649.2 (RK), D655.2 (RK), D661.2 (RK), D667.2 (RK), D673.2 (RK), D679.2 (RK), D685.2 (RK), D691.2 (RK), D697.2 (RK), D703.2 (RK), D709.2 (RK), D715.2 (RK), R168.2
L9_K2B: D650.4 (BK), D656.4 (BK), D662.4 (BK), D668.4 (BK), D674.4 (BK), D680.4 (BK), D686.4 (BK), D692.4 (BK), D698.4 (BK), D704.4 (BK), D710.4 (BK), D716.4 (BK), R169.2
L9_K2G: D650.3 (GK), D656.3 (GK), D662.3 (GK), D668.3 (GK), D674.3 (GK), D680.3 (GK), D686.3 (GK), D692.3 (GK), D698.3 (GK), D704.3 (GK), D710.3 (GK), D716.3 (GK), R170.2
L9_K2R: D650.2 (RK), D656.2 (RK), D662.2 (RK), D668.2 (RK), D674.2 (RK), D680.2 (RK), D686.2 (RK), D692.2 (RK), D698.2 (RK), D704.2 (RK), D710.2 (RK), D716.2 (RK), R171.2
L9_K3B: D651.4 (BK), D657.4 (BK), D663.4 (BK), D669.4 (BK), D675.4 (BK), D681.4 (BK), D687.4 (BK), D693.4 (BK), D699.4 (BK), D705.4 (BK), D711.4 (BK), D717.4 (BK), R172.2
L9_K3G: D651.3 (GK), D657.3 (GK), D663.3 (GK), D669.3 (GK), D675.3 (GK), D681.3 (GK), D687.3 (GK), D693.3 (GK), D699.3 (GK), D705.3 (GK), D711.3 (GK), D717.3 (GK), R173.2
L9_K3R: D651.2 (RK), D657.2 (RK), D663.2 (RK), D669.2 (RK), D675.2 (RK), D681.2 (RK), D687.2 (RK), D693.2 (RK), D699.2 (RK), D705.2 (RK), D711.2 (RK), D717.2 (RK), R174.2
L9_K4B: D652.4 (BK), D658.4 (BK), D664.4 (BK), D670.4 (BK), D676.4 (BK), D688.4 (BK), D694.4 (BK), D700.4 (BK), D706.4 (BK), D712.4 (BK), D718.4 (BK), R175.2
L9_K4G: D652.3 (GK), D658.3 (GK), D664.3 (GK), D670.3 (GK), D676.3 (GK), D688.3 (GK), D694.3 (GK), D700.3 (GK), D706.3 (GK), D712.3 (GK), D718.3 (GK), R176.2
L9_K4R: D652.2 (RK), D658.2 (RK), D664.2 (RK), D670.2 (RK), D676.2 (RK), D688.2 (RK), D694.2 (RK), D700.2 (RK), D706.2 (RK), D712.2 (RK), D718.2 (RK), R177.2
L9_K5B: D653.4 (BK), D659.4 (BK), D665.4 (BK), D671.4 (BK), D677.4 (BK), D683.4 (BK), D689.4 (BK), D695.4 (BK), D701.4 (BK), D707.4 (BK), D713.4 (BK), D719.4 (BK), R178.2
L9_K5G: D653.3 (GK), D659.3 (GK), D665.3 (GK), D671.3 (GK), D677.3 (GK), D683.3 (GK), D689.3 (GK), D695.3 (GK), D701.3 (GK), D707.3 (GK), D713.3 (GK), D719.3 (GK), R179.2
L9_K5R: D653.2 (RK), D659.2 (RK), D665.2 (RK), D671.2 (RK), D677.2 (RK), D683.2 (RK), D689.2 (RK), D695.2 (RK), D701.2 (RK), D707.2 (RK), D713.2 (RK), D719.2 (RK), R180.2
L10_A0: D725.1 (A), D726.1 (A), D727.1 (A), U11.7 (SW1)
L10_A1: D696.1 (A), D702.1 (A), D708.1 (A), U11.5 (SW2)
L10_A2: D722.1 (A), D723.1 (A), D724.1 (A), U11.8 (SW3)
L10_A3: D714.1 (A), D720.1 (A), D721.1 (A), U11.4 (SW4)
L10_A4: D732.1 (A), D734.1 (A), U11.9 (SW5)
L10_A5: D666.1 (A), D672.1 (A), D678.1 (A), U11.3 (SW6)
L10_A6: D729.1 (A), D737.1 (A), U11.10 (SW7)
L10_A7: D682.1 (A), D684.1 (A), D690.1 (A), U11.2 (SW8)
L10_A8: D728.1 (A), D738.1 (A), U11.11 (SW9)
L10_A9: D507.1 (A), D510.1 (A), D513.1 (A), U11.1 (SW10)
L10_A10: D731.1 (A), D735.1 (A), U11.12 (SW11)
L10_A11: D516.1 (A), D654.1 (A), D660.1 (A), U11.44 (SW12)
L10_CS: U11.28 (CSN); also elsewhere on the board
L10_K0B: D510.4 (BK), D654.4 (BK), D672.4 (BK), D684.4 (BK), D702.4 (BK), D720.4 (BK), D723.4 (BK), D726.4 (BK), D729.4 (BK), D732.4 (BK), D735.4 (BK), D738.4 (BK), R163.1
L10_K0G: D510.3 (GK), D654.3 (GK), D672.3 (GK), D684.3 (GK), D702.3 (GK), D720.3 (GK), D723.3 (GK), D726.3 (GK), D729.3 (GK), D732.3 (GK), D735.3 (GK), D738.3 (GK), R164.2
L10_K0R: D510.2 (RK), D654.2 (RK), D672.2 (RK), D684.2 (RK), D702.2 (RK), D720.2 (RK), D723.2 (RK), D726.2 (RK), D729.2 (RK), D732.2 (RK), D735.2 (RK), D738.2 (RK), R165.2
L10_K1B: D507.4 (BK), D516.4 (BK), D666.4 (BK), D682.4 (BK), D696.4 (BK), D714.4 (BK), D722.4 (BK), D725.4 (BK), D728.4 (BK), D731.4 (BK), D734.4 (BK), D737.4 (BK), R181.2
L10_K1G: D507.3 (GK), D516.3 (GK), D666.3 (GK), D682.3 (GK), D696.3 (GK), D714.3 (GK), D722.3 (GK), D725.3 (GK), D728.3 (GK), D731.3 (GK), D734.3 (GK), D737.3 (GK), R182.2
L10_K1R: D507.2 (RK), D516.2 (RK), D666.2 (RK), D682.2 (RK), D696.2 (RK), D714.2 (RK), D722.2 (RK), D725.2 (RK), D728.2 (RK), D731.2 (RK), D734.2 (RK), D737.2 (RK), R183.2
L10_K5B: D513.4 (BK), D660.4 (BK), D678.4 (BK), D690.4 (BK), D708.4 (BK), D721.4 (BK), D724.4 (BK), D727.4 (BK), R193.2
L10_K5G: D513.3 (GK), D660.3 (GK), D678.3 (GK), D690.3 (GK), D708.3 (GK), D721.3 (GK), D724.3 (GK), D727.3 (GK), R194.2
L10_K5R: D513.2 (RK), D660.2 (RK), D678.2 (RK), D690.2 (RK), D708.2 (RK), D721.2 (RK), D724.2 (RK), D727.2 (RK), R195.2
MISO_C: U10.27 (MISO), U11.27 (MISO); also elsewhere on the board
MOSI_C: U10.31 (MOSI), U11.31 (MOSI); also elsewhere on the board
unnamed: R166.1, U10.40 (CS4)
unnamed: R167.1, U10.38 (CS5)
unnamed: R168.1, U10.37 (CS6)
unnamed: R169.1, U10.36 (CS7)
unnamed: R170.1, U10.35 (CS8)
unnamed: R171.1, U10.34 (CS9)
unnamed: R172.1, U10.22 (CS10)
unnamed: R173.1, U10.21 (CS11)
unnamed: R174.1, U10.20 (CS12)
unnamed: R175.1, U10.19 (CS13)
unnamed: R176.1, U10.18 (CS14)
unnamed: R177.1, U10.16 (CS15)
unnamed: R178.1, U10.15 (CS16)
unnamed: R179.1, U10.14 (CS17)
unnamed: R180.1, U10.13 (CS18)
unnamed: R196.2, U10.32 (ISET)
unnamed: R163.2, U11.43 (CS1)
unnamed: R164.1, U11.42 (CS2)
unnamed: R165.1, U11.41 (CS3)
unnamed: R181.1, U11.40 (CS4)
unnamed: R182.1, U11.38 (CS5)
unnamed: R183.1, U11.37 (CS6)
unnamed: R193.1, U11.15 (CS16)
unnamed: R194.1, U11.14 (CS17)
unnamed: R195.1, U11.13 (CS18)
unnamed: R197.2, U11.32 (ISET)
SCK_C: U10.30 (SCK), U11.30 (SCK); also elsewhere on the board
