itsmevjnk/MelbourneTrainTracker/Hardware/Rev2/Rev2.kicad_pcb

## KiCad design Hardware/Rev2/Rev2.kicad_pcb (continued)

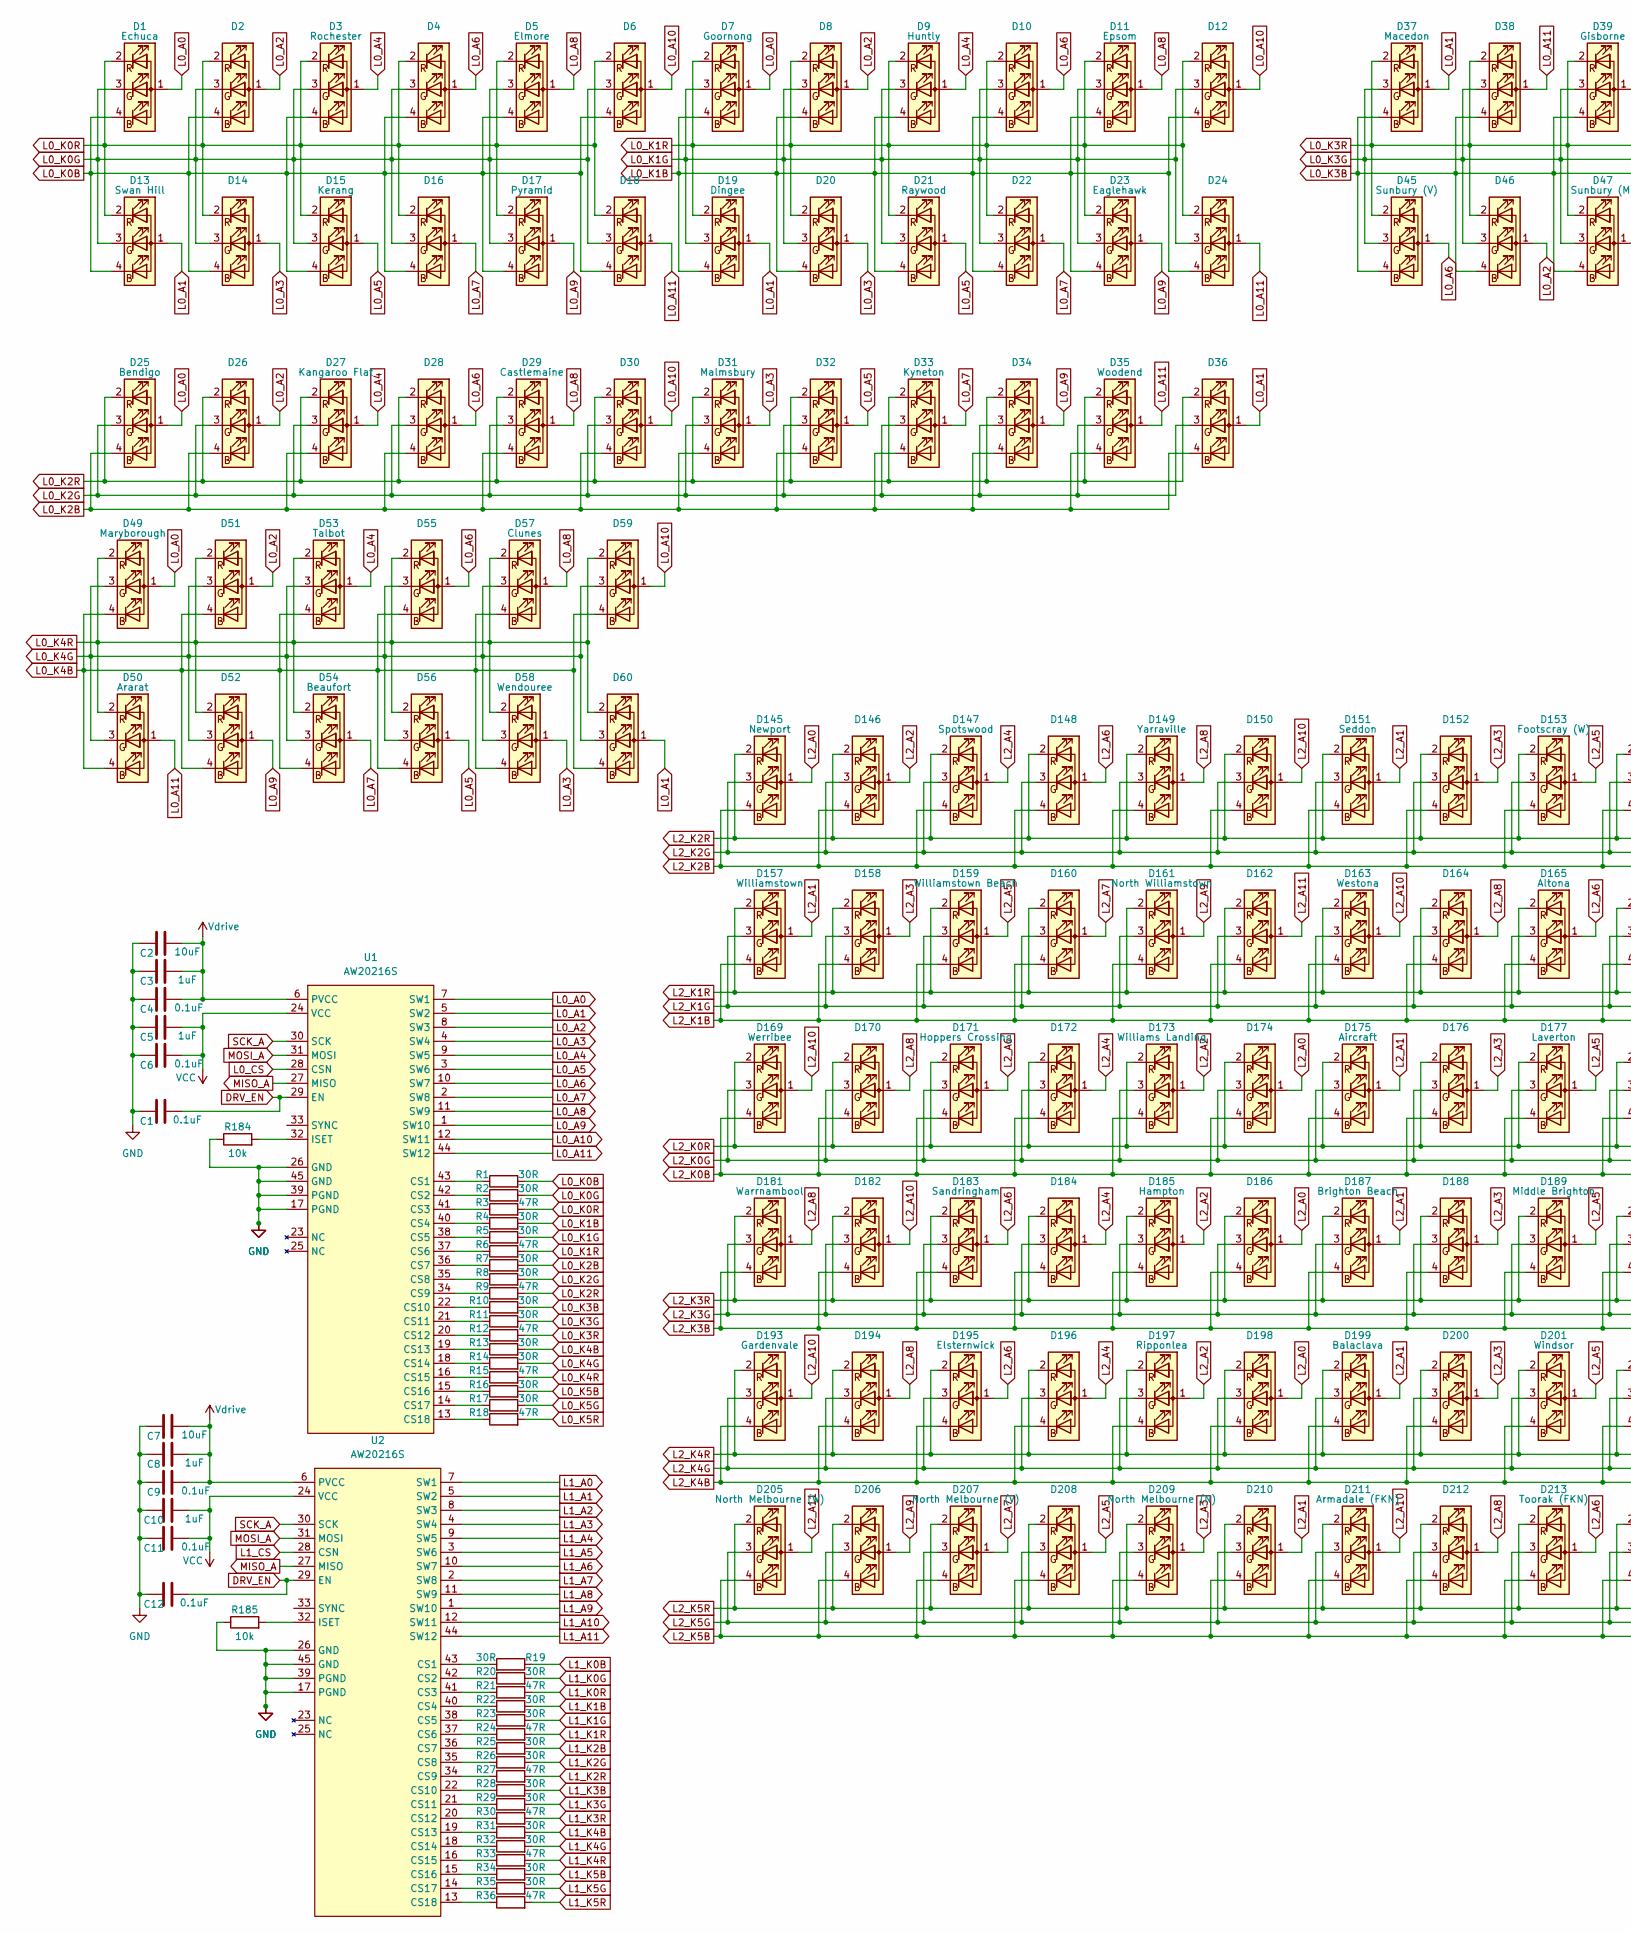
[picture p12: schematic vline_west.kicad_sch, part in row 1, column 1]

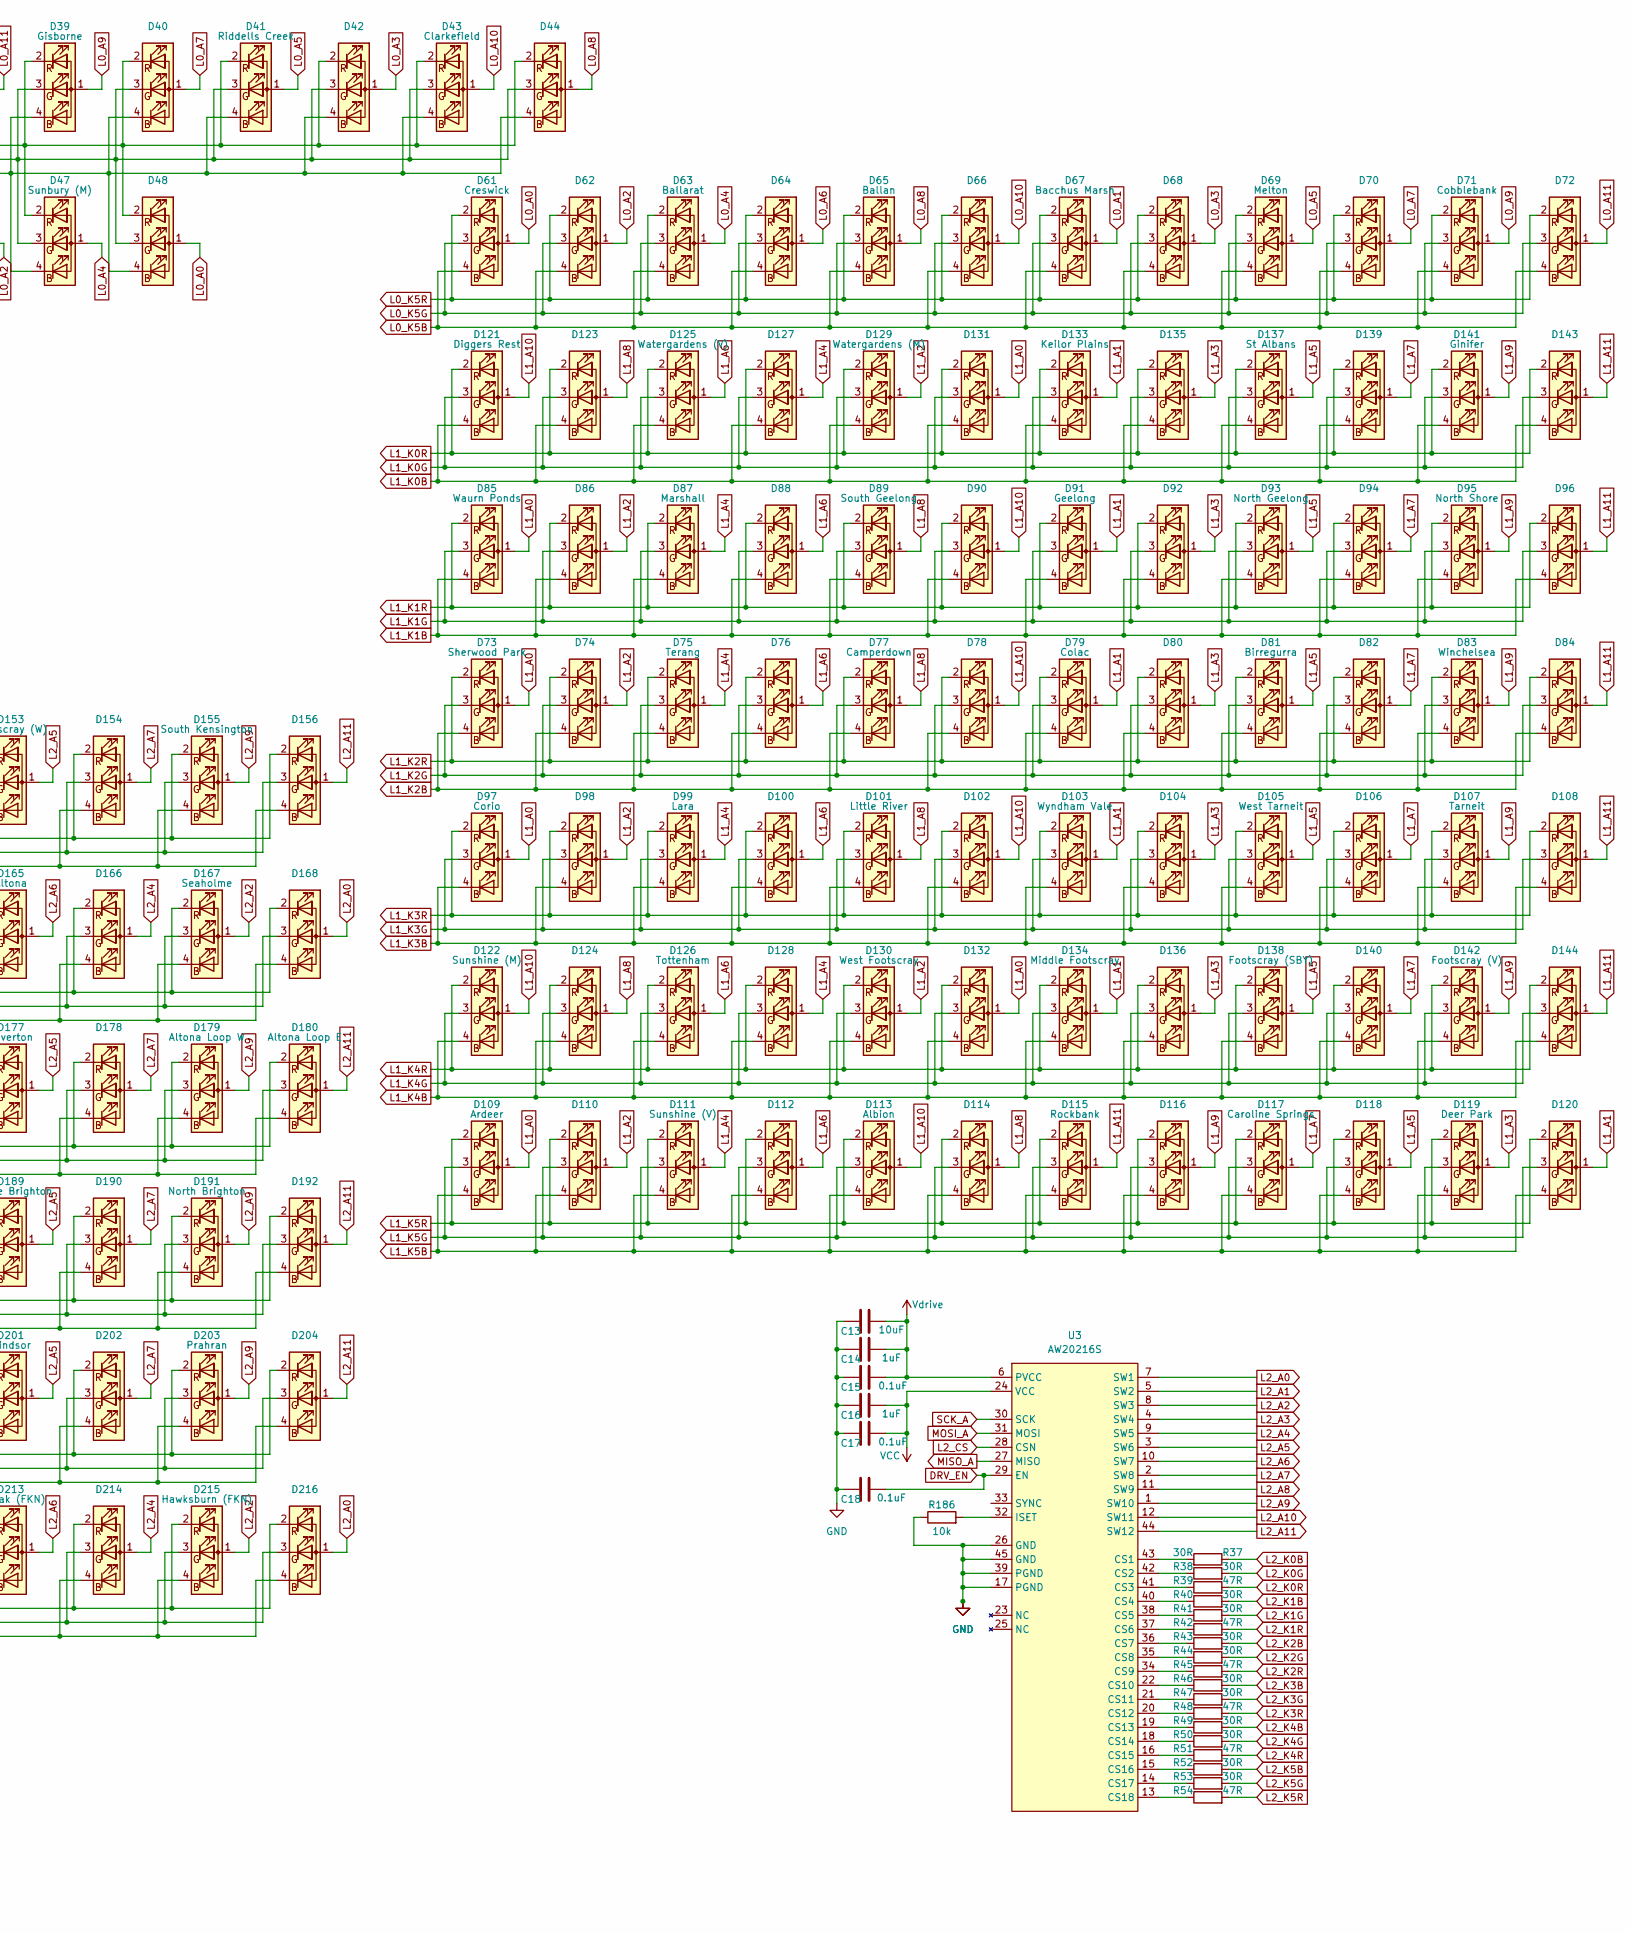
[picture p13: schematic vline_west.kicad_sch, part in row 1, column 2]

Parts:
C1, C4, C6, C9, C11, C12, C15, C17, C18: 0.1uF; C_0603_1608Metric_Pad1.08x0.95mm_HandSolder; MPN C14663
C2, C7, C13: 10uF; C_0805_2012Metric_Pad1.18x1.45mm_HandSolder; MPN C380332
C3, C5, C8, C10, C14, C16: 1uF; C_0603_1608Metric_Pad1.08x0.95mm_HandSolder; MPN C6119849
D1, D2, D3, D4, D5, D6, D7, D8, D9, D10, D11, D12, D13, D14, D15, D16, D17, D18, D19, D20, D21, D22, D23, D24, D25, D26, D27, D28, D29, D30, D31, D32, D33, D34, D35, D36, D37, D38, D39, D40, D41, D42, D43, D44, D45, D46, D47, D48, D49, D50, D51, D52, D53, D54, D55, D56, D57, D58, D59, D60, D61, D62, D63, D64, D65, D66, D67, D68, D69, D70, D71, D72, D73, D74, D75, D76, D77, D78, D79, D80, D81, D82, D83, D84, D85, D86, D87, D88, D89, D90, D91, D92, D93, D94, D95, D96, D97, D98, D99, D100, D101, D102, D103, D104, D105, D106, D107, D108, D109, D110, D111, D112, D113, D114, D115, D116, D117, D118, D119, D120, D121, D122, D123, D124, D125, D126, D127, D128, D129, D130, D131, D132, D133, D134, D135, D136, D137, D138, D139, D140, D141, D142, D143, D144, D145, D146, D147, D148, D149, D150, D151, D152, D153, D154, D155, D156, D157, D158, D159, D160, D161, D162, D163, D164, D165, D166, D167, D168, D169, D170, D171, D172, D173, D174, D175, D176, D177, D178, D179, D180, D181, D182, D183, D184, D185, D186, D187, D188, D189, D190, D191, D192, D193, D194, D195, D196, D197, D198, D199, D200, D201, D202, D203, D204, D205, D206, D207, D208, D209, D210, D211, D212, D213, D214, D215, D216: XL-B1010RGBT-HF; LED_RGB_Xinglight-1010; MPN C22464515
R1, R2, R4, R5, R7, R8, R10, R11, R13, R14, R16, R17, R19, R20, R22, R23, R25, R26, R28, R29, R31, R32, R34, R35, R37, R38, R40, R41, R43, R44, R46, R47, R49, R50, R52, R53: 30R; R_0805_2012Metric_Pad1.20x1.40mm_HandSolder
R3, R6, R9, R12, R15, R18, R21, R24, R27, R30, R33, R36, R39, R42, R45, R48, R51, R54: 47R; R_0805_2012Metric_Pad1.20x1.40mm_HandSolder
R184, R185, R186: 10k; R_0603_1608Metric_Pad0.98x0.95mm_HandSolder; MPN C15401
U1, U2, U3: AW20216S; QFN-44-1EP_5x5mm_P0.4mm_EP2.45x2.45mm; MPN C7385556

Connections:
+3.3V: C5.2, C6.2, C10.2, C11.2, C16.2, C17.2, U1.24 (VCC), U2.24 (VCC), U3.24 (VCC); also elsewhere on the board
+5V: C2.2, C3.2, C4.2, C7.2, C8.2, C9.2, C13.2, C14.2, C15.2, U1.6 (PVCC), U2.6 (PVCC), U3.6 (PVCC); also elsewhere on the board
DRV_EN: C1.2, C12.2, C18.2, U1.29 (EN), U2.29 (EN), U3.29 (EN); also elsewhere on the board
GND: C1.1, C2.1, C3.1, C4.1, C5.1, C6.1, C7.1, C8.1, C9.1, C10.1, C11.1, C12.1, C13.1, C14.1, C15.1, C16.1, C17.1, C18.1, R184.1, R185.1, R186.1, U1.17 (PGND), U1.26 (GND), U1.39 (PGND), U1.45 (GND), U2.17 (PGND), U2.26 (GND), U2.39 (PGND), U2.45 (GND), U3.17 (PGND), U3.26 (GND), U3.39 (PGND), U3.45 (GND); also elsewhere on the board
L0_A0: D1.1 (A), D7.1 (A), D25.1 (A), D48.1 (A), D49.1 (A), D61.1 (A), U1.7 (SW1)
L0_A1: D13.1 (A), D19.1 (A), D36.1 (A), D37.1 (A), D60.1 (A), D67.1 (A), U1.5 (SW2)
L0_A2: D2.1 (A), D8.1 (A), D26.1 (A), D46.1 (A), D51.1 (A), D62.1 (A), U1.8 (SW3)
L0_A3: D14.1 (A), D20.1 (A), D31.1 (A), D42.1 (A), D58.1 (A), D68.1 (A), U1.4 (SW4)
L0_A4: D3.1 (A), D9.1 (A), D27.1 (A), D47.1 (A), D53.1 (A), D63.1 (A), U1.9 (SW5)
L0_A5: D15.1 (A), D21.1 (A), D32.1 (A), D41.1 (A), D56.1 (A), D69.1 (A), U1.3 (SW6)
L0_A6: D4.1 (A), D10.1 (A), D28.1 (A), D45.1 (A), D55.1 (A), D64.1 (A), U1.10 (SW7)
L0_A7: D16.1 (A), D22.1 (A), D33.1 (A), D40.1 (A), D54.1 (A), D70.1 (A), U1.2 (SW8)
L0_A8: D5.1 (A), D11.1 (A), D29.1 (A), D44.1 (A), D57.1 (A), D65.1 (A), U1.11 (SW9)
L0_A9: D17.1 (A), D23.1 (A), D34.1 (A), D39.1 (A), D52.1 (A), D71.1 (A), U1.1 (SW10)
L0_A10: D6.1 (A), D12.1 (A), D30.1 (A), D43.1 (A), D59.1 (A), D66.1 (A), U1.12 (SW11)
L0_A11: D18.1 (A), D24.1 (A), D35.1 (A), D38.1 (A), D50.1 (A), D72.1 (A), U1.44 (SW12)
L0_CS: U1.28 (CSN); also elsewhere on the board
L0_K0B: D1.4 (BK), D2.4 (BK), D3.4 (BK), D4.4 (BK), D5.4 (BK), D6.4 (BK), D13.4 (BK), D14.4 (BK), D15.4 (BK), D16.4 (BK), D17.4 (BK), D18.4 (BK), R1.2
L0_K0G: D1.3 (GK), D2.3 (GK), D3.3 (GK), D4.3 (GK), D5.3 (GK), D6.3 (GK), D13.3 (GK), D14.3 (GK), D15.3 (GK), D16.3 (GK), D17.3 (GK), D18.3 (GK), R2.2
L0_K0R: D1.2 (RK), D2.2 (RK), D3.2 (RK), D4.2 (RK), D5.2 (RK), D6.2 (RK), D13.2 (RK), D14.2 (RK), D15.2 (RK), D16.2 (RK), D17.2 (RK), D18.2 (RK), R3.2
L0_K1B: D7.4 (BK), D8.4 (BK), D9.4 (BK), D10.4 (BK), D11.4 (BK), D12.4 (BK), D19.4 (BK), D20.4 (BK), D21.4 (BK), D22.4 (BK), D23.4 (BK), D24.4 (BK), R4.2
L0_K1G: D7.3 (GK), D8.3 (GK), D9.3 (GK), D10.3 (GK), D11.3 (GK), D12.3 (GK), D19.3 (GK), D20.3 (GK), D21.3 (GK), D22.3 (GK), D23.3 (GK), D24.3 (GK), R5.2
L0_K1R: D7.2 (RK), D8.2 (RK), D9.2 (RK), D10.2 (RK), D11.2 (RK), D12.2 (RK), D19.2 (RK), D20.2 (RK), D21.2 (RK), D22.2 (RK), D23.2 (RK), D24.2 (RK), R6.2
L0_K2B: D25.4 (BK), D26.4 (BK), D27.4 (BK), D28.4 (BK), D29.4 (BK), D30.4 (BK), D31.4 (BK), D32.4 (BK), D33.4 (BK), D34.4 (BK), D35.4 (BK), D36.4 (BK), R7.2
L0_K2G: D25.3 (GK), D26.3 (GK), D27.3 (GK), D28.3 (GK), D29.3 (GK), D30.3 (GK), D31.3 (GK), D32.3 (GK), D33.3 (GK), D34.3 (GK), D35.3 (GK), D36.3 (GK), R8.2
L0_K2R: D25.2 (RK), D26.2 (RK), D27.2 (RK), D28.2 (RK), D29.2 (RK), D30.2 (RK), D31.2 (RK), D32.2 (RK), D33.2 (RK), D34.2 (RK), D35.2 (RK), D36.2 (RK), R9.2
L0_K3B: D37.4 (BK), D38.4 (BK), D39.4 (BK), D40.4 (BK), D41.4 (BK), D42.4 (BK), D43.4 (BK), D44.4 (BK), D45.4 (BK), D46.4 (BK), D47.4 (BK), D48.4 (BK), R10.2
L0_K3G: D37.3 (GK), D38.3 (GK), D39.3 (GK), D40.3 (GK), D41.3 (GK), D42.3 (GK), D43.3 (GK), D44.3 (GK), D45.3 (GK), D46.3 (GK), D47.3 (GK), D48.3 (GK), R11.2
L0_K3R: D37.2 (RK), D38.2 (RK), D39.2 (RK), D40.2 (RK), D41.2 (RK), D42.2 (RK), D43.2 (RK), D44.2 (RK), D45.2 (RK), D46.2 (RK), D47.2 (RK), D48.2 (RK), R12.2
L0_K4B: D49.4 (BK), D50.4 (BK), D51.4 (BK), D52.4 (BK), D53.4 (BK), D54.4 (BK), D55.4 (BK), D56.4 (BK), D57.4 (BK), D58.4 (BK), D59.4 (BK), D60.4 (BK), R13.2
L0_K4G: D49.3 (GK), D50.3 (GK), D51.3 (GK), D52.3 (GK), D53.3 (GK), D54.3 (GK), D55.3 (GK), D56.3 (GK), D57.3 (GK), D58.3 (GK), D59.3 (GK), D60.3 (GK), R14.2
L0_K4R: D49.2 (RK), D50.2 (RK), D51.2 (RK), D52.2 (RK), D53.2 (RK), D54.2 (RK), D55.2 (RK), D56.2 (RK), D57.2 (RK), D58.2 (RK), D59.2 (RK), D60.2 (RK), R15.2
L0_K5B: D61.4 (BK), D62.4 (BK), D63.4 (BK), D64.4 (BK), D65.4 (BK), D66.4 (BK), D67.4 (BK), D68.4 (BK), D69.4 (BK), D70.4 (BK), D71.4 (BK), D72.4 (BK), R16.2
L0_K5G: D61.3 (GK), D62.3 (GK), D63.3 (GK), D64.3 (GK), D65.3 (GK), D66.3 (GK), D67.3 (GK), D68.3 (GK), D69.3 (GK), D70.3 (GK), D71.3 (GK), D72.3 (GK), R17.2
L0_K5R: D61.2 (RK), D62.2 (RK), D63.2 (RK), D64.2 (RK), D65.2 (RK), D66.2 (RK), D67.2 (RK), D68.2 (RK), D69.2 (RK), D70.2 (RK), D71.2 (RK), D72.2 (RK), R18.2
L1_A0: D73.1 (A), D85.1 (A), D97.1 (A), D109.1 (A), D131.1 (A), D132.1 (A), U2.7 (SW1)
L1_A1: D79.1 (A), D91.1 (A), D103.1 (A), D120.1 (A), D133.1 (A), D134.1 (A), U2.5 (SW2)
L1_A2: D74.1 (A), D86.1 (A), D98.1 (A), D110.1 (A), D129.1 (A), D130.1 (A), U2.8 (SW3)
L1_A3: D80.1 (A), D92.1 (A), D104.1 (A), D119.1 (A), D135.1 (A), D136.1 (A), U2.4 (SW4)
L1_A4: D75.1 (A), D87.1 (A), D99.1 (A), D111.1 (A), D127.1 (A), D128.1 (A), U2.9 (SW5)
L1_A5: D81.1 (A), D93.1 (A), D105.1 (A), D118.1 (A), D137.1 (A), D138.1 (A), U2.3 (SW6)
L1_A6: D76.1 (A), D88.1 (A), D100.1 (A), D112.1 (A), D125.1 (A), D126.1 (A), U2.10 (SW7)
L1_A7: D82.1 (A), D94.1 (A), D106.1 (A), D117.1 (A), D139.1 (A), D140.1 (A), U2.2 (SW8)
L1_A8: D77.1 (A), D89.1 (A), D101.1 (A), D114.1 (A), D123.1 (A), D124.1 (A), U2.11 (SW9)
L1_A9: D83.1 (A), D95.1 (A), D107.1 (A), D116.1 (A), D141.1 (A), D142.1 (A), U2.1 (SW10)
L1_A10: D78.1 (A), D90.1 (A), D102.1 (A), D113.1 (A), D121.1 (A), D122.1 (A), U2.12 (SW11)
L1_A11: D84.1 (A), D96.1 (A), D108.1 (A), D115.1 (A), D143.1 (A), D144.1 (A), U2.44 (SW12)
L1_CS: U2.28 (CSN); also elsewhere on the board
L1_K0B: D121.4 (BK), D123.4 (BK), D125.4 (BK), D127.4 (BK), D129.4 (BK), D131.4 (BK), D133.4 (BK), D135.4 (BK), D137.4 (BK), D139.4 (BK), D141.4 (BK), D143.4 (BK), R19.1
L1_K0G: D121.3 (GK), D123.3 (GK), D125.3 (GK), D127.3 (GK), D129.3 (GK), D131.3 (GK), D133.3 (GK), D135.3 (GK), D137.3 (GK), D139.3 (GK), D141.3 (GK), D143.3 (GK), R20.2
L1_K0R: D121.2 (RK), D123.2 (RK), D125.2 (RK), D127.2 (RK), D129.2 (RK), D131.2 (RK), D133.2 (RK), D135.2 (RK), D137.2 (RK), D139.2 (RK), D141.2 (RK), D143.2 (RK), R21.2
L1_K1B: D85.4 (BK), D86.4 (BK), D87.4 (BK), D88.4 (BK), D89.4 (BK), D90.4 (BK), D91.4 (BK), D92.4 (BK), D93.4 (BK), D94.4 (BK), D95.4 (BK), D96.4 (BK), R22.2
L1_K1G: D85.3 (GK), D86.3 (GK), D87.3 (GK), D88.3 (GK), D89.3 (GK), D90.3 (GK), D91.3 (GK), D92.3 (GK), D93.3 (GK), D94.3 (GK), D95.3 (GK), D96.3 (GK), R23.2
L1_K1R: D85.2 (RK), D86.2 (RK), D87.2 (RK), D88.2 (RK), D89.2 (RK), D90.2 (RK), D91.2 (RK), D92.2 (RK), D93.2 (RK), D94.2 (RK), D95.2 (RK), D96.2 (RK), R24.2
L1_K2B: D73.4 (BK), D74.4 (BK), D75.4 (BK), D76.4 (BK), D77.4 (BK), D78.4 (BK), D79.4 (BK), D80.4 (BK), D81.4 (BK), D82.4 (BK), D83.4 (BK), D84.4 (BK), R25.2
L1_K2G: D73.3 (GK), D74.3 (GK), D75.3 (GK), D76.3 (GK), D77.3 (GK), D78.3 (GK), D79.3 (GK), D80.3 (GK), D81.3 (GK), D82.3 (GK), D83.3 (GK), D84.3 (GK), R26.2
L1_K2R: D73.2 (RK), D74.2 (RK), D75.2 (RK), D76.2 (RK), D77.2 (RK), D78.2 (RK), D79.2 (RK), D80.2 (RK), D81.2 (RK), D82.2 (RK), D83.2 (RK), D84.2 (RK), R27.2
L1_K3B: D97.4 (BK), D98.4 (BK), D99.4 (BK), D100.4 (BK), D101.4 (BK), D102.4 (BK), D103.4 (BK), D104.4 (BK), D105.4 (BK), D106.4 (BK), D107.4 (BK), D108.4 (BK), R28.2
L1_K3G: D97.3 (GK), D98.3 (GK), D99.3 (GK), D100.3 (GK), D101.3 (GK), D102.3 (GK), D103.3 (GK), D104.3 (GK), D105.3 (GK), D106.3 (GK), D107.3 (GK), D108.3 (GK), R29.2
L1_K3R: D97.2 (RK), D98.2 (RK), D99.2 (RK), D100.2 (RK), D101.2 (RK), D102.2 (RK), D103.2 (RK), D104.2 (RK), D105.2 (RK), D106.2 (RK), D107.2 (RK), D108.2 (RK), R30.2
L1_K4B: D122.4 (BK), D124.4 (BK), D126.4 (BK), D128.4 (BK), D130.4 (BK), D132.4 (BK), D134.4 (BK), D136.4 (BK), D138.4 (BK), D140.4 (BK), D142.4 (BK), D144.4 (BK), R31.2
L1_K4G: D122.3 (GK), D124.3 (GK), D126.3 (GK), D128.3 (GK), D130.3 (GK), D132.3 (GK), D134.3 (GK), D136.3 (GK), D138.3 (GK), D140.3 (GK), D142.3 (GK), D144.3 (GK), R32.2
L1_K4R: D122.2 (RK), D124.2 (RK), D126.2 (RK), D128.2 (RK), D130.2 (RK), D132.2 (RK), D134.2 (RK), D136.2 (RK), D138.2 (RK), D140.2 (RK), D142.2 (RK), D144.2 (RK), R33.2
L1_K5B: D109.4 (BK), D110.4 (BK), D111.4 (BK), D112.4 (BK), D113.4 (BK), D114.4 (BK), D115.4 (BK), D116.4 (BK), D117.4 (BK), D118.4 (BK), D119.4 (BK), D120.4 (BK), R34.2
L1_K5G: D109.3 (GK), D110.3 (GK), D111.3 (GK), D112.3 (GK), D113.3 (GK), D114.3 (GK), D115.3 (GK), D116.3 (GK), D117.3 (GK), D118.3 (GK), D119.3 (GK), D120.3 (GK), R35.2
L1_K5R: D109.2 (RK), D110.2 (RK), D111.2 (RK), D112.2 (RK), D113.2 (RK), D114.2 (RK), D115.2 (RK), D116.2 (RK), D117.2 (RK), D118.2 (RK), D119.2 (RK), D120.2 (RK), R36.2
L2_A0: D145.1 (A), D168.1 (A), D174.1 (A), D186.1 (A), D198.1 (A), D216.1 (A), U3.7 (SW1)
L2_A1: D151.1 (A), D157.1 (A), D175.1 (A), D187.1 (A), D199.1 (A), D210.1 (A), U3.5 (SW2)
L2_A2: D146.1 (A), D167.1 (A), D173.1 (A), D185.1 (A), D197.1 (A), D215.1 (A), U3.8 (SW3)
L2_A3: D152.1 (A), D158.1 (A), D176.1 (A), D188.1 (A), D200.1 (A), D209.1 (A), U3.4 (SW4)
L2_A4: D147.1 (A), D166.1 (A), D172.1 (A), D184.1 (A), D196.1 (A), D214.1 (A), U3.9 (SW5)
L2_A5: D153.1 (A), D159.1 (A), D177.1 (A), D189.1 (A), D201.1 (A), D208.1 (A), U3.3 (SW6)
L2_A6: D148.1 (A), D165.1 (A), D171.1 (A), D183.1 (A), D195.1 (A), D213.1 (A), U3.10 (SW7)
L2_A7: D154.1 (A), D160.1 (A), D178.1 (A), D190.1 (A), D202.1 (A), D207.1 (A), U3.2 (SW8)
L2_A8: D149.1 (A), D164.1 (A), D170.1 (A), D181.1 (A), D194.1 (A), D212.1 (A), U3.11 (SW9)
L2_A9: D155.1 (A), D161.1 (A), D179.1 (A), D191.1 (A), D203.1 (A), D206.1 (A), U3.1 (SW10)
L2_A10: D150.1 (A), D163.1 (A), D169.1 (A), D182.1 (A), D193.1 (A), D211.1 (A), U3.12 (SW11)
L2_A11: D156.1 (A), D162.1 (A), D180.1 (A), D192.1 (A), D204.1 (A), D205.1 (A), U3.44 (SW12)
L2_CS: U3.28 (CSN); also elsewhere on the board
L2_K0B: D169.4 (BK), D170.4 (BK), D171.4 (BK), D172.4 (BK), D173.4 (BK), D174.4 (BK), D175.4 (BK), D176.4 (BK), D177.4 (BK), D178.4 (BK), D179.4 (BK), D180.4 (BK), R37.1
L2_K0G: D169.3 (GK), D170.3 (GK), D171.3 (GK), D172.3 (GK), D173.3 (GK), D174.3 (GK), D175.3 (GK), D176.3 (GK), D177.3 (GK), D178.3 (GK), D179.3 (GK), D180.3 (GK), R38.2
L2_K0R: D169.2 (RK), D170.2 (RK), D171.2 (RK), D172.2 (RK), D173.2 (RK), D174.2 (RK), D175.2 (RK), D176.2 (RK), D177.2 (RK), D178.2 (RK), D179.2 (RK), D180.2 (RK), R39.2
L2_K1B: D157.4 (BK), D158.4 (BK), D159.4 (BK), D160.4 (BK), D161.4 (BK), D162.4 (BK), D163.4 (BK), D164.4 (BK), D165.4 (BK), D166.4 (BK), D167.4 (BK), D168.4 (BK), R40.2
L2_K1G: D157.3 (GK), D158.3 (GK), D159.3 (GK), D160.3 (GK), D161.3 (GK), D162.3 (GK), D163.3 (GK), D164.3 (GK), D165.3 (GK), D166.3 (GK), D167.3 (GK), D168.3 (GK), R41.2
L2_K1R: D157.2 (RK), D158.2 (RK), D159.2 (RK), D160.2 (RK), D161.2 (RK), D162.2 (RK), D163.2 (RK), D164.2 (RK), D165.2 (RK), D166.2 (RK), D167.2 (RK), D168.2 (RK), R42.2
L2_K2B: D145.4 (BK), D146.4 (BK), D147.4 (BK), D148.4 (BK), D149.4 (BK), D150.4 (BK), D151.4 (BK), D152.4 (BK), D153.4 (BK), D154.4 (BK), D155.4 (BK), D156.4 (BK), R43.2
L2_K2G: D145.3 (GK), D146.3 (GK), D147.3 (GK), D148.3 (GK), D149.3 (GK), D150.3 (GK), D151.3 (GK), D152.3 (GK), D153.3 (GK), D154.3 (GK), D155.3 (GK), D156.3 (GK), R44.2
L2_K2R: D145.2 (RK), D146.2 (RK), D147.2 (RK), D148.2 (RK), D149.2 (RK), D150.2 (RK), D151.2 (RK), D152.2 (RK), D153.2 (RK), D154.2 (RK), D155.2 (RK), D156.2 (RK), R45.2
L2_K3B: D181.4 (BK), D182.4 (BK), D183.4 (BK), D184.4 (BK), D185.4 (BK), D186.4 (BK), D187.4 (BK), D188.4 (BK), D189.4 (BK), D190.4 (BK), D191.4 (BK), D192.4 (BK), R46.2
L2_K3G: D181.3 (GK), D182.3 (GK), D183.3 (GK), D184.3 (GK), D185.3 (GK), D186.3 (GK), D187.3 (GK), D188.3 (GK), D189.3 (GK), D190.3 (GK), D191.3 (GK), D192.3 (GK), R47.2
L2_K3R: D181.2 (RK), D182.2 (RK), D183.2 (RK), D184.2 (RK), D185.2 (RK), D186.2 (RK), D187.2 (RK), D188.2 (RK), D189.2 (RK), D190.2 (RK), D191.2 (RK), D192.2 (RK), R48.2
L2_K4B: D193.4 (BK), D194.4 (BK), D195.4 (BK), D196.4 (BK), D197.4 (BK), D198.4 (BK), D199.4 (BK), D200.4 (BK), D201.4 (BK), D202.4 (BK), D203.4 (BK), D204.4 (BK), R49.2
L2_K4G: D193.3 (GK), D194.3 (GK), D195.3 (GK), D196.3 (GK), D197.3 (GK), D198.3 (GK), D199.3 (GK), D200.3 (GK), D201.3 (GK), D202.3 (GK), D203.3 (GK), D204.3 (GK), R50.2
L2_K4R: D193.2 (RK), D194.2 (RK), D195.2 (RK), D196.2 (RK), D197.2 (RK), D198.2 (RK), D199.2 (RK), D200.2 (RK), D201.2 (RK), D202.2 (RK), D203.2 (RK), D204.2 (RK), R51.2
L2_K5B: D205.4 (BK), D206.4 (BK), D207.4 (BK), D208.4 (BK), D209.4 (BK), D210.4 (BK), D211.4 (BK), D212.4 (BK), D213.4 (BK), D214.4 (BK), D215.4 (BK), D216.4 (BK), R52.2
L2_K5G: D205.3 (GK), D206.3 (GK), D207.3 (GK), D208.3 (GK), D209.3 (GK), D210.3 (GK), D211.3 (GK), D212.3 (GK), D213.3 (GK), D214.3 (GK), D215.3 (GK), D216.3 (GK), R53.2
L2_K5R: D205.2 (RK), D206.2 (RK), D207.2 (RK), D208.2 (RK), D209.2 (RK), D210.2 (RK), D211.2 (RK), D212.2 (RK), D213.2 (RK), D214.2 (RK), D215.2 (RK), D216.2 (RK), R54.2
MISO_A: U1.27 (MISO), U2.27 (MISO), U3.27 (MISO); also elsewhere on the board
MOSI_A: U1.31 (MOSI), U2.31 (MOSI), U3.31 (MOSI); also elsewhere on the board
unnamed: R1.1, U1.43 (CS1)
unnamed: R2.1, U1.42 (CS2)
unnamed: R3.1, U1.41 (CS3)
unnamed: R4.1, U1.40 (CS4)
unnamed: R5.1, U1.38 (CS5)
unnamed: R6.1, U1.37 (CS6)
unnamed: R7.1, U1.36 (CS7)
unnamed: R8.1, U1.35 (CS8)
unnamed: R9.1, U1.34 (CS9)
unnamed: R10.1, U1.22 (CS10)
unnamed: R11.1, U1.21 (CS11)
unnamed: R12.1, U1.20 (CS12)
unnamed: R13.1, U1.19 (CS13)
unnamed: R14.1, U1.18 (CS14)
unnamed: R15.1, U1.16 (CS15)
unnamed: R16.1, U1.15 (CS16)
unnamed: R17.1, U1.14 (CS17)
unnamed: R18.1, U1.13 (CS18)
unnamed: R184.2, U1.32 (ISET)
unnamed: R19.2, U2.43 (CS1)
unnamed: R20.1, U2.42 (CS2)
unnamed: R21.1, U2.41 (CS3)
unnamed: R22.1, U2.40 (CS4)
unnamed: R23.1, U2.38 (CS5)
unnamed: R24.1, U2.37 (CS6)
unnamed: R25.1, U2.36 (CS7)
unnamed: R26.1, U2.35 (CS8)
unnamed: R27.1, U2.34 (CS9)
unnamed: R28.1, U2.22 (CS10)
unnamed: R29.1, U2.21 (CS11)
unnamed: R30.1, U2.20 (CS12)
unnamed: R31.1, U2.19 (CS13)
unnamed: R32.1, U2.18 (CS14)
unnamed: R33.1, U2.16 (CS15)
unnamed: R34.1, U2.15 (CS16)
unnamed: R35.1, U2.14 (CS17)
unnamed: R36.1, U2.13 (CS18)
unnamed: R185.2, U2.32 (ISET)
unnamed: R37.2, U3.43 (CS1)
unnamed: R38.1, U3.42 (CS2)
unnamed: R39.1, U3.41 (CS3)
unnamed: R40.1, U3.40 (CS4)
unnamed: R41.1, U3.38 (CS5)
unnamed: R42.1, U3.37 (CS6)
unnamed: R43.1, U3.36 (CS7)
unnamed: R44.1, U3.35 (CS8)
unnamed: R45.1, U3.34 (CS9)
unnamed: R46.1, U3.22 (CS10)
unnamed: R47.1, U3.21 (CS11)
unnamed: R48.1, U3.20 (CS12)
unnamed: R49.1, U3.19 (CS13)
unnamed: R50.1, U3.18 (CS14)
unnamed: R51.1, U3.16 (CS15)
unnamed: R52.1, U3.15 (CS16)
unnamed: R53.1, U3.14 (CS17)
unnamed: R54.1, U3.13 (CS18)
unnamed: R186.2, U3.32 (ISET)
SCK_A: U1.30 (SCK), U2.30 (SCK), U3.30 (SCK); also elsewhere on the board

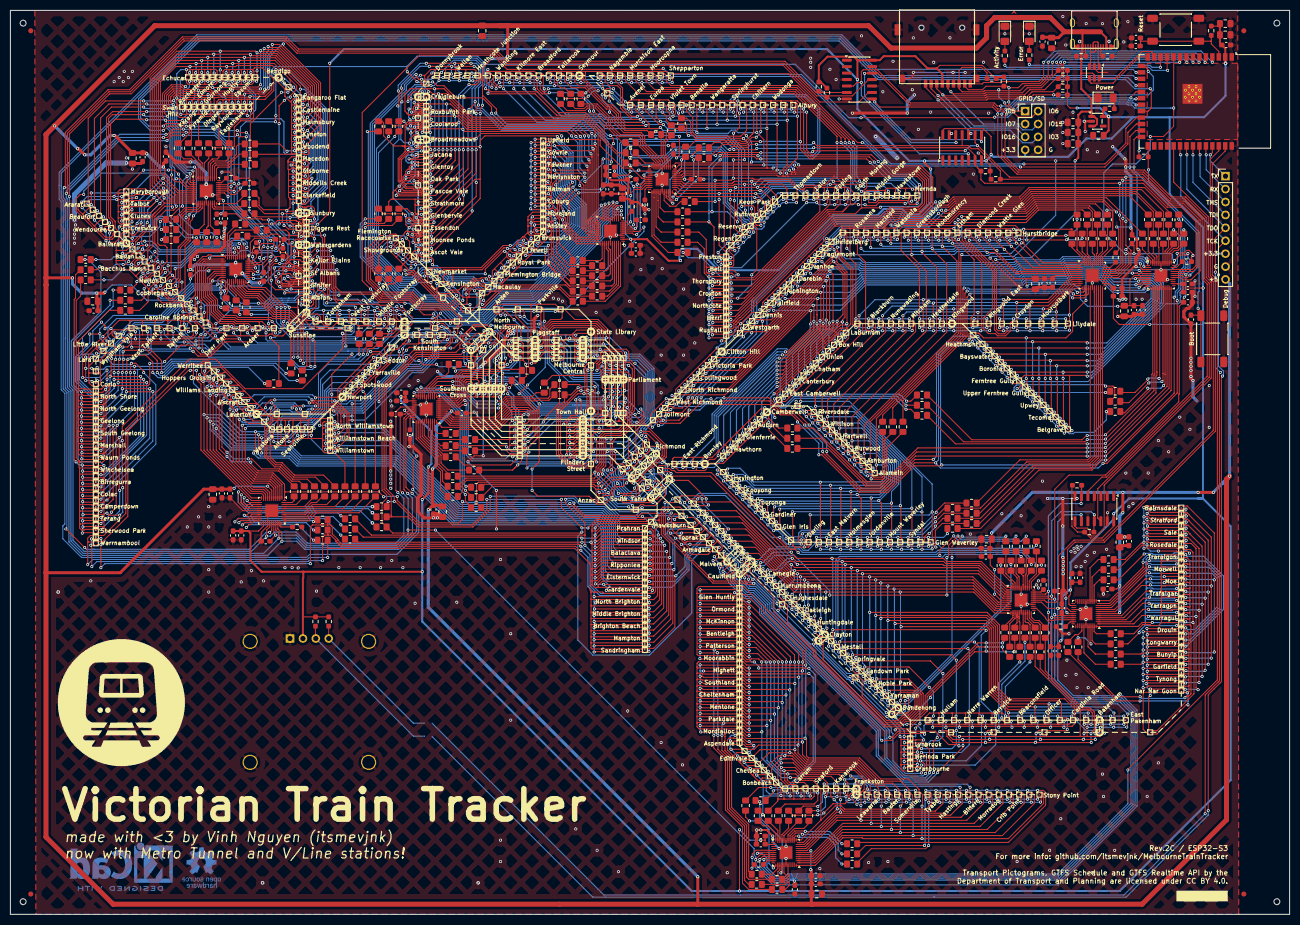
[picture p14: board Rev2.kicad_pcb from above]

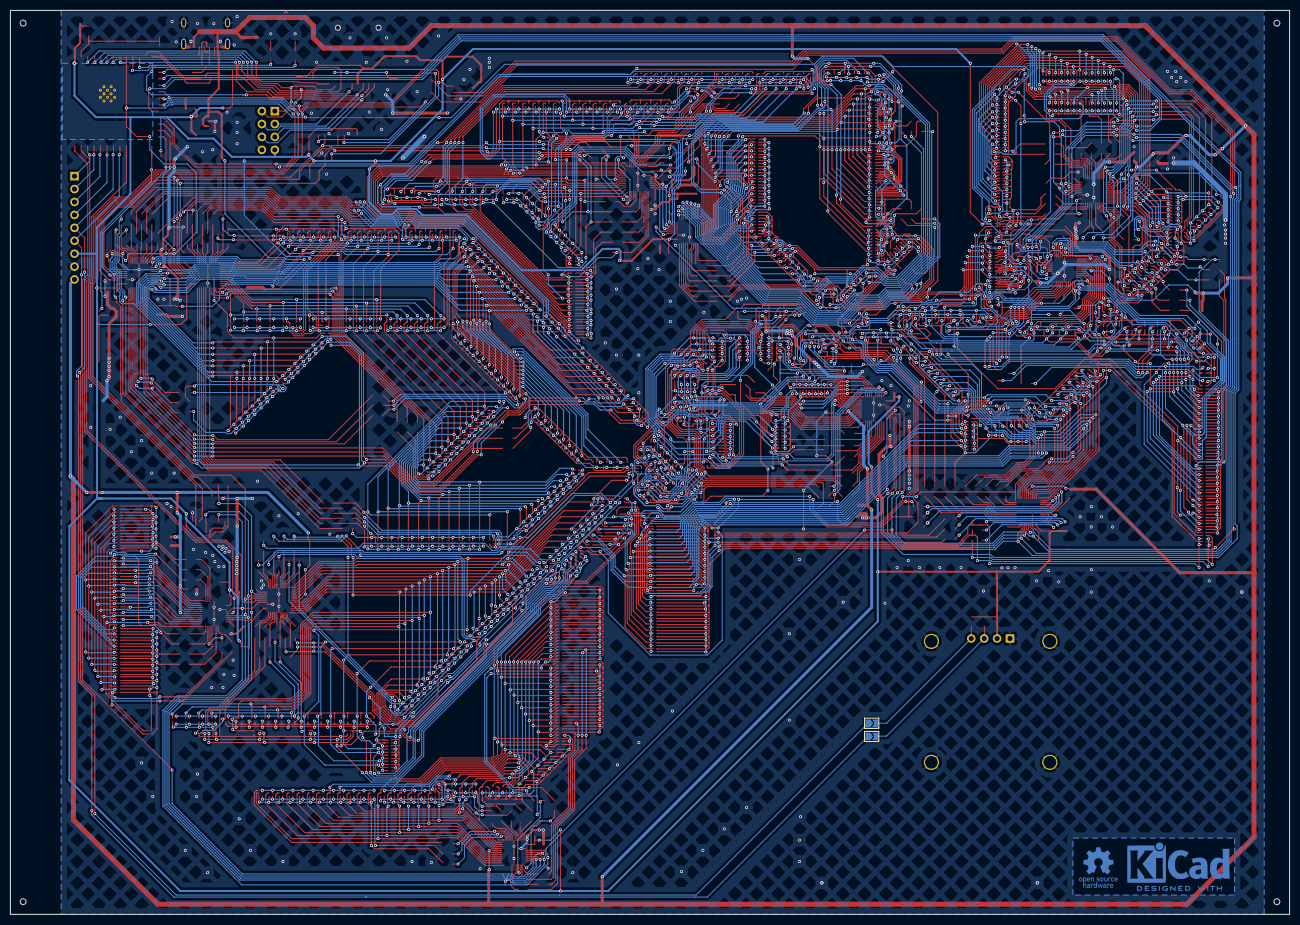
[picture p15: board Rev2.kicad_pcb from below]

Board: 2 copper layers, 251.6 x 177.8 mm, 1060 parts (2 on the bottom side), 570 nets.
