itsmevjnk/MelbourneTrainTracker/MTT_Firmware/main/src/subsystems/led_matrix.cpp

#include "subsystems/led_matrix.h"

#include <string.h>
#include <algorithm>

#include "esp_check.h"

/* for logging */
#include "esp_log.h"
#include "hwconfig/led_matrix.h"
const char* LEDMatrix::kTag = "led_matrix";

/* SPI configs */
#if CONFIG_IDF_TARGET_ESP32
static const spi_bus_config_t kSPI2BusConfig = {
    .mosi_io_num = SPI2_MOSI,
    .miso_io_num = SPI2_MISO,
    .sclk_io_num = SPI2_SCK,
    .data2_io_num = -1,
    .data3_io_num = -1,
    .data4_io_num = -1,
    .data5_io_num = -1,
    .data6_io_num = -1,
    .data7_io_num = -1,
    .max_transfer_sz = 216 + 2,
    
};
#endif
static const spi_bus_config_t kSPI3BusConfig = {
    .mosi_io_num = SPI3_MOSI,
    .miso_io_num = SPI3_MISO,
    .sclk_io_num = SPI3_SCK,
    .data2_io_num = -1,
    .data3_io_num = -1,
    .data4_io_num = -1,
    .data5_io_num = -1,
    .data6_io_num = -1,
    .data7_io_num = -1,
    .max_transfer_sz = 216 + 2
};

const size_t LEDMatrix::kBufferOffsets[NUM_DRIVERS] = {
    L0_OFFSET, L1_OFFSET, L2_OFFSET, L3_OFFSET, L4_OFFSET, L5_OFFSET, L6_OFFSET, L7_OFFSET,
#if CONFIG_IDF_TARGET_ESP32S3
    L8_OFFSET, L9_OFFSET, L10_OFFSET
#endif
};

float LEDMatrix::m_brightness = 1.0;
AW20216S* LEDMatrix::m_drivers[NUM_DRIVERS];
uint8_t* LEDMatrix::m_buffer; // LED matrix frame buffer
bool LEDMatrix::m_driverState = false;

const size_t LEDMatrix::kBurnleyOffsets[] = { LMAT_BURNLEY };
const size_t LEDMatrix::kCliftonOffsets[] = { LMAT_CLIFTON };
const size_t LEDMatrix::kCrossCityOffsets[] = { LMAT_CROSSCITY };
const size_t LEDMatrix::kDandenongOffsets[] = { LMAT_DANDENONG };
const size_t LEDMatrix::kMunnelOffsets[] = { LMAT_MUNNEL };
const size_t LEDMatrix::kFlemingtonOffsets[] = { LMAT_FLEMINGTON };
const size_t LEDMatrix::kNorthernOffsets[] = { LMAT_NORTHERN };
const size_t LEDMatrix::kSandringhamOffsets[] = { LMAT_SANDRINGHAM };
const size_t LEDMatrix::kVLineOffsets[] = { LMAT_VLINE };

#ifdef CONFIG_LMAT_STRICT_COLOUR_CHECK
const uint8_t* LEDMatrix::m_expectedColours;
#endif

StaticSemaphore_t LEDMatrix::m_bufferMutexBuf;
SemaphoreHandle_t LEDMatrix::m_bufferMutex = xSemaphoreCreateRecursiveMutexStatic(&m_bufferMutexBuf);

esp_err_t LEDMatrix::init() {
    /* allocate framebuffer */
    m_buffer = new uint8_t[LMAT_SIZE];
#ifdef CONFIG_LMAT_STRICT_COLOUR_CHECK
    // populate expected colours buffer
    m_expectedColours = m_buffer;
    setMulti(kBurnleyOffsets, sizeof(kBurnleyOffsets) / sizeof(size_t), kBurnley);
    setMulti(kCliftonOffsets, sizeof(kCliftonOffsets) / sizeof(size_t), kClifton);
    setMulti(kCrossCityOffsets, sizeof(kCrossCityOffsets) / sizeof(size_t), kFrankston);
    setMulti(kDandenongOffsets, sizeof(kDandenongOffsets) / sizeof(size_t), kDandenong);
    setMulti(kMunnelOffsets, sizeof(kMunnelOffsets) / sizeof(size_t), kDandenong);
    setMulti(kFlemingtonOffsets, sizeof(kFlemingtonOffsets) / sizeof(size_t), kFlemington);
    setMulti(kNorthernOffsets, sizeof(kNorthernOffsets) / sizeof(size_t), kNorthern);
    setMulti(kSandringhamOffsets, sizeof(kSandringhamOffsets) / sizeof(size_t), kSandringham);
    setMulti(kVLineOffsets, sizeof(kVLineOffsets) / sizeof(size_t), kVLine);
    m_buffer = new uint8_t[LMAT_SIZE]; // reallocate new buffer
#endif
    memset(m_buffer, 0, LMAT_SIZE); // clear framebuffer here too
    ESP_LOGV(kTag, "%u byte framebuffer allocated at 0x%x", LMAT_SIZE, (uintptr_t)m_buffer);

    /* initialise DRV_EN pin */
    ESP_RETURN_ON_ERROR(gpio_set_direction(DRV_EN, GPIO_MODE_OUTPUT), kTag, "cannot set pin %u direction", DRV_EN);
    ESP_RETURN_ON_ERROR(disableDrivers(), kTag, "cannot disable driver output initially");

    /* initialise SPI buses */
#if CONFIG_IDF_TARGET_ESP32 && !defined(CONFIG_SPI3_ONLY)
    ESP_RETURN_ON_ERROR(spi_bus_initialize(
        SPI2_HOST,
        &kSPI2BusConfig,
        SPI_DMA_CH_AUTO
    ), kTag, "SPI2 bus initialisation failed");
    spi_device_handle_t spi2Handle;
    ESP_RETURN_ON_ERROR(spi_bus_add_device(
        SPI2_HOST,
        &AW20216S::kSPIDeviceConfig,
        &spi2Handle
    ), kTag, "SPI2 device add failed");
#endif

    ESP_RETURN_ON_ERROR(spi_bus_initialize(
        SPI3_HOST,
        &kSPI3BusConfig,
        SPI_DMA_CH_AUTO
    ), kTag, "SPI3 bus initialisation failed");
    spi_device_handle_t spi3Handle;
    ESP_RETURN_ON_ERROR(spi_bus_add_device(
        SPI3_HOST,
        &AW20216S::kSPIDeviceConfig,
        &spi3Handle
    ), kTag, "SPI3 device add failed");

    /* initialise LED drivers */
#if CONFIG_IDF_TARGET_ESP32S3 || defined(CONFIG_SPI3_ONLY)
#define SPI_HANDLE(host)                spi3Handle
#else
#define SPI_HANDLE(host)                (((host) == SPI2_HOST) ? spi2Handle : spi3Handle) // macro to select SPI handle
#endif
    m_drivers[0] = new AW20216S("aw0", SPI_HANDLE(L0_SPI), L0_CS, &m_buffer[kBufferOffsets[0]], L0_ROWS); ESP_RETURN_ON_ERROR(m_drivers[0]->init(), kTag, "L0 init failed");
    m_drivers[1] = new AW20216S("aw1", SPI_HANDLE(L1_SPI), L1_CS, &m_buffer[kBufferOffsets[1]], L1_ROWS); ESP_RETURN_ON_ERROR(m_drivers[1]->init(), kTag, "L1 init failed");
    m_drivers[2] = new AW20216S("aw2", SPI_HANDLE(L2_SPI), L2_CS, &m_buffer[kBufferOffsets[2]], L2_ROWS); ESP_RETURN_ON_ERROR(m_drivers[2]->init(), kTag, "L2 init failed");
    m_drivers[3] = new AW20216S("aw3", SPI_HANDLE(L3_SPI), L3_CS, &m_buffer[kBufferOffsets[3]], L3_ROWS); ESP_RETURN_ON_ERROR(m_drivers[3]->init(), kTag, "L3 init failed");
    m_drivers[4] = new AW20216S("aw4", SPI_HANDLE(L4_SPI), L4_CS, &m_buffer[kBufferOffsets[4]], L4_ROWS); ESP_RETURN_ON_ERROR(m_drivers[4]->init(), kTag, "L4 init failed");
    m_drivers[5] = new AW20216S("aw5", SPI_HANDLE(L5_SPI), L5_CS, &m_buffer[kBufferOffsets[5]], L5_ROWS); ESP_RETURN_ON_ERROR(m_drivers[5]->init(), kTag, "L5 init failed");
    m_drivers[6] = new AW20216S("aw6", SPI_HANDLE(L6_SPI), L6_CS, &m_buffer[kBufferOffsets[6]], L6_ROWS); ESP_RETURN_ON_ERROR(m_drivers[6]->init(), kTag, "L6 init failed");
    m_drivers[7] = new AW20216S("aw7", SPI_HANDLE(L7_SPI), L7_CS, &m_buffer[kBufferOffsets[7]], L7_ROWS); ESP_RETURN_ON_ERROR(m_drivers[7]->init(), kTag, "L7 init failed");
#if CONFIG_IDF_TARGET_ESP32S3
    m_drivers[8] = new AW20216S("aw8", SPI_HANDLE(L8_SPI), L8_CS, &m_buffer[kBufferOffsets[8]], L8_ROWS); ESP_RETURN_ON_ERROR(m_drivers[8]->init(), kTag, "L8 init failed");
    m_drivers[9] = new AW20216S("aw9", SPI_HANDLE(L9_SPI), L9_CS, &m_buffer[kBufferOffsets[9]], L9_ROWS); ESP_RETURN_ON_ERROR(m_drivers[9]->init(), kTag, "L9 init failed");
    m_drivers[10] = new AW20216S("aw10", SPI_HANDLE(L10_SPI), L10_CS, &m_buffer[kBufferOffsets[10]], L10_ROWS); ESP_RETURN_ON_ERROR(m_drivers[10]->init(), kTag, "L10 init failed");
#endif

    fill(kOff);
    update();
    ESP_RETURN_ON_ERROR(enableDrivers(), kTag, "cannot enable driver output");

    return ESP_OK;
}

esp_err_t LEDMatrix::setRaw(size_t offset, uint32_t colour) {
    if (offset == LMAT_NULL) return ESP_OK;
    
    if (offset % 3 != 0 || offset >= LMAT_SIZE) {
        ESP_LOGE(kTag, "offset %u given to LEDMatrix::set() is invalid", offset);
        return ESP_ERR_INVALID_ARG;
    }

    acquireBuffer();
    m_buffer[LMAT_R(offset)] = (colour >> 16) & 0xFF; // red
    m_buffer[LMAT_G(offset)] = (colour >> 8) & 0xFF; // green
    m_buffer[LMAT_B(offset)] = (colour >> 0) & 0xFF; // blue

#ifdef CONFIG_LMAT_STRICT_COLOUR_CHECK
    assert(colour == kOff || (!memcmp(&m_buffer[offset], &m_expectedColours[offset], 3)));
#endif

    releaseBuffer();
    return ESP_OK;
}

uint8_t LEDMatrix::getBrightness() {
    return (uint8_t)std::clamp(m_brightness * 100.0f, 0.0f, 100.0f);
}

void LEDMatrix::setBrightness(uint8_t value, bool rescale) {
    float normValue = std::clamp((float)value / 100.0f, 0.0f, 100.0f);
    if (normValue == m_brightness) return;

    float oldBrightness = m_brightness;
    m_brightness = normValue;
    if (rescale) {
        for (size_t i = 0; i < LMAT_SIZE; i++) {
            float oldVal = m_buffer[i];
            float newVal = std::clamp(oldVal / oldBrightness * normValue, 0.0f, 255.0f);
            m_buffer[i] = newVal;
        }
    }
}

uint32_t LEDMatrix::applyCorrection(colour_t colour) {
    uint8_t r = (colour >> 16) & 0xFF, // red
            g = (colour >> 8) & 0xFF, // green
            b = (colour >> 0) & 0xFF; // blue
    
    r = m_forwardLUT[0][r];
    g = m_forwardLUT[1][g];
    b = m_forwardLUT[2][b];

    float   rScaled = std::clamp((float)r * m_brightness, 0.0f, 255.0f),
            gScaled = std::clamp((float)g * m_brightness, 0.0f, 255.0f),
            bScaled = std::clamp((float)b * m_brightness, 0.0f, 255.0f);

    return ((uint8_t)rScaled << 16) | ((uint8_t)gScaled << 8) | (uint8_t)bScaled;
}

esp_err_t LEDMatrix::set(size_t offset, colour_t colour) {
    return LEDMatrix::setRaw(offset, applyCorrection(colour));
}

esp_err_t LEDMatrix::setMulti(const size_t* offsets, size_t leds, colour_t colour) {
    // uint8_t r = (colour >> 16) & 0xFF, // red
    //         g = (colour >> 8) & 0xFF, // green
    //         b = (colour >> 0) & 0xFF; // blue
    
    uint32_t correctedColour = applyCorrection(colour);

    esp_err_t ret = ESP_OK;
    acquireBuffer();
    
    for (size_t i = 0; i < leds && ret == ESP_OK; i++, offsets++) { // increment to next offset after each iteration
        size_t offset = *offsets;
        ret = setRaw(offset, correctedColour); // NOTE: the commented out code causes weird corruption??????

        // if (offset == LMAT_NULL) continue;
        // if (offset % 3 != 0) {
        //     ESP_LOGE(kTag, "offset %u given to LEDMatrix::setMulti() is invalid", offset);
        //     return ESP_ERR_INVALID_ARG;
        // }
        // m_buffer[LMAT_R(offset)] = r;
        // m_buffer[LMAT_G(offset)] = g;
        // m_buffer[LMAT_B(offset)] = b;
    }

    releaseBuffer();
    return ret;
}

esp_err_t LEDMatrix::fill(colour_t colour) {
    uint32_t correctedColour = applyCorrection(colour);
    uint8_t r = (correctedColour >> 16) & 0xFF, // red
            g = (correctedColour >> 8) & 0xFF, // green
            b = (correctedColour >> 0) & 0xFF; // blue
    
    acquireBuffer();
    if (r == g && g == b) memset(m_buffer, r, LMAT_SIZE); // use memset if possible because it's faster
    else {
        for (size_t offset = 0; offset < LMAT_SIZE; offset += 3) {
            m_buffer[LMAT_R(offset)] = r;
            m_buffer[LMAT_G(offset)] = g;
            m_buffer[LMAT_B(offset)] = b;
        }
    }
    releaseBuffer();

    return ESP_OK;
}

esp_err_t LEDMatrix::update() {
    /* TODO: more intelligent updating */
    acquireBuffer();
    for (int i = 0; i < NUM_DRIVERS; i++) {
        ESP_RETURN_ON_ERROR(m_drivers[i]->update(), kTag, "updating L%d failed", i);
    }
    releaseBuffer();

    return ESP_OK;
}
