itsmevjnk/MelbourneTrainTracker/MTT_Firmware/main/include/hwconfig/led_matrix.h

/* LED matrix configuration */

#pragma once

#include "sdkconfig.h"

#define LMAT_SPI_CLOCK                      1000000UL // SPI clock speed for LED matrix drivers

#if CONFIG_IDF_TARGET_ESP32S3
#define NUM_DRIVERS                         11
#else
#define NUM_DRIVERS                         8
#endif


/* number of rows per driver */
#define L0_ROWS                             (3 * 6)
#define L1_ROWS                             (3 * 6)
#define L2_ROWS                             (3 * 6)
#define L3_ROWS                             (3 * 6)
#define L4_ROWS                             (3 * 6)
#define L5_ROWS                             (3 * 6)
#define L6_ROWS                             (3 * 6)
#define L_ROWS(x)                           L##x##_ROWS

#if CONFIG_IDF_TARGET_ESP32S3
#define L7_ROWS                             (3 * 6)
#define L8_ROWS                             (3 * 6)
#define L9_ROWS                             (3 * 6)
#define L10_ROWS                            (3 * 6)
#else
#define L7_ROWS                             (3 * 4)
#endif

/* offsets into buffer */
#define L0_OFFSET                           0
#define L1_OFFSET                           (L0_OFFSET + 12 * L0_ROWS)
#define L2_OFFSET                           (L1_OFFSET + 12 * L1_ROWS)
#define L3_OFFSET                           (L2_OFFSET + 12 * L2_ROWS)
#define L4_OFFSET                           (L3_OFFSET + 12 * L3_ROWS)
#define L5_OFFSET                           (L4_OFFSET + 12 * L4_ROWS)
#define L6_OFFSET                           (L5_OFFSET + 12 * L5_ROWS)
#define L7_OFFSET                           (L6_OFFSET + 12 * L6_ROWS)

#if CONFIG_IDF_TARGET_ESP32S3
#define L8_OFFSET                           (L7_OFFSET + 12 * L7_ROWS)
#define L9_OFFSET                           (L8_OFFSET + 12 * L8_ROWS)
#define L10_OFFSET                          (L9_OFFSET + 12 * L9_ROWS)
#define LMAT_SIZE                           (L10_OFFSET + 12 * L10_ROWS)
#else
#define LMAT_SIZE                           (L7_OFFSET + 12 * L7_ROWS)
#endif

/* addressing macros */
#define L_OFFSET(x)                         L##x##_OFFSET
#define LMAT_BASE(chip, col, row)           (L_OFFSET(chip) + L_ROWS(chip) * (col) + 3 * (row))

#if CONFIG_IDF_TARGET_ESP32S3
#define LMAT_R(base)                        ((base) + 2)
#define LMAT_G(base)                        ((base) + 1)
#define LMAT_B(base)                        ((base) + 0)
#else
#define LMAT_R(base)                        ((base) + 0)
#define LMAT_G(base)                        ((base) + 1)
#define LMAT_B(base)                        ((base) + 2)
#endif


/* line LED offsets */
#if CONFIG_IDF_TARGET_ESP32S3 // TODO: new LED offsets
#include "hwconfig/leds/rev2/burnley.h"
#include "hwconfig/leds/rev2/clifton.h"
#include "hwconfig/leds/rev2/crosscity.h"
#include "hwconfig/leds/rev2/dandenong.h"
#include "hwconfig/leds/rev2/munnel.h"
#include "hwconfig/leds/rev2/northern.h"
#include "hwconfig/leds/rev2/sandringham.h"
#include "hwconfig/leds/rev2/vline.h"
#else
#include "hwconfig/leds/rev1/burnley.h"
#include "hwconfig/leds/rev1/clifton.h"
#include "hwconfig/leds/rev1/crosscity.h"
#include "hwconfig/leds/rev1/dandenong.h"
#include "hwconfig/leds/rev1/munnel.h"
#include "hwconfig/leds/rev1/northern.h"
#include "hwconfig/leds/rev1/sandringham.h"
#include "hwconfig/leds/rev1/vline.h"
#endif

#define LMAT_NULL                           0xFFFF
