itsmevjnk/MelbourneTrainTracker/MTT_Firmware/main/include/message.h

/* message parsing */

#pragma once

#include <bits/stdc++.h>

#include <sys/time.h>
#include "colours.h"
#include "lsid.h"

#include <freertos/FreeRTOS.h>

#include "subsystems/led_matrix.h"

struct MessageEntry {
    uint32_t tripHash; // 0
    infraid_t line; // 4
    infraid_t station; // 8
    int64_t timestamp; // 12
    struct Flags {
        uint8_t isDeparture : 1;
        uint8_t hasAdjacent : 1;
        uint8_t viaMunnel : 1;
        uint8_t mtOriginating : 1;
        uint8_t isRRB : 1;
        uint8_t viaCity : 1;
        uint8_t reserved : 2;
    } __attribute__((packed)) flags; // 20
    // 21 bytes

    /* only valid if hasAdjacent is set */
    infraid_t adjStation; // 21
    int64_t adjTimestamp; // 25
    // 33 bytes
} __attribute__((packed));

class Message {
public:
    static void parseFragment(const char* data, int length, bool first); // start/continue parsing message fragment
    static void finish(); // finish parsing entire message

private:
    static const char* kTag; // for logging

    static MessageEntry m_entryFragment; // for holding fragmented entry
    static int m_entryFragmentSize; // size of the first half of the fragment

    static size_t m_expectedEntries; // number of expected (from header) and received entries
    static size_t m_receivedEntries;
    static bool m_started;

    static bool checkVLine(infraid_t line, infraid_t station); // check if V/Line event entry is to be rejected due to not being represented on map
};
