itsmevjnk/MelbourneTrainTracker/(commit log)

2025-05-03 initial commit with LED flash
2025-05-03 add LED pins and cycle through colours
2025-05-03 remove Sandringham from Frankston line, which is added by mistake
    [crosscity.h]
2025-05-03 add custom partition table
    [partitions.csv]
2025-05-03 implement persistent configuration using NVS and configuration CLI
    [partitions.csv]
2025-05-04 simplify event filtering
2025-05-04 add adjacent station arrival/departure timestamp to handle multiple LEDs between stations
2025-05-04 implement MQTT subscription on ESP32 side
2025-05-06 prototype, still having problems
    - random trains get "teleported" to Craigieburn???
    - memory leaks hard
    [clifton.h, dandenong.h, led_matrix.cpp, led_matrix.h]
2025-05-06 clamp LED index
2025-05-06 reverse Laverton express LED order
    [crosscity.h]
2025-05-06 clear m_updatesMap after committing updates, seems to resolve memory leak
    [main.cpp, services.cpp]
2025-05-07 add option for running all LED drivers from SPI3/VSPI
2025-05-07 switch to vanilla ESP-IDF from PlatformIO
2025-05-08 switch to more compact message format
2025-05-08 show MQTT broker in configuration CLI
    [show_config.cpp]
2025-05-08 fix edge case where last MQTT payload chunk only contains a fragment of the last entry
    [message.cpp]
2025-05-08 make transition between intermediary LEDs smoother
2025-05-08 rollback conditional updating and hopefully fix disappearing trains... hopefully
    [main.cpp, services.cpp, services.h]
2025-05-08 fix reallocation assertion for when there are no entries on boot
    [services.cpp]
2025-05-09 wrap panic handler to turn on error LED and dump more info
    [services.cpp, services.h]
2025-05-09 move line LED offsets into public LEDMatrix class members
2025-05-09 batch insertions to make backend runnable on Oracle Cloud
2025-05-09 set default MQTT broker to the production server
    [config.cpp]
2025-05-09 use error LED to indicate MQTT errors
    [mqtt.cpp]
2025-05-13 add API endpoints for turning LED drivers on/off
2025-05-13 fetch LED matrix contents via HTTP
2025-05-13 broadcast LED matrix buffer over WebSocket
2025-05-13 serve board image over HTTP
    for future web interface
2025-05-14 start adding board view
2025-05-18 add LED offset map to board script
2025-05-18 finalise board view functionality
2025-05-18 minify board view HTML
2025-05-18 fix LED offsets
2025-05-19 add blinking LED in config mode
2025-05-20 control LED driver phase to smooth out load
    will probably need more testing
2025-05-23 add hardware schematic and PCB layout
    [mtt.kicad_sch]
2025-05-24 update PIR sensor pin
2025-08-06 fix SPI bus definitions
    [pindefs.h]
2025-10-15 fix config defines
    apparently all sdkconfig items have CONFIG_ automatically prepended
    [led_matrix.cpp, led_matrix.h, main.cpp, message.cpp, pindefs.h, services.cpp, webserver.cpp]
2025-10-17 change Caroline Springs code from CPS to RVH
2025-10-20 (untested) publish all lines' events over MQTT, and shift validity checking to firmware
    this should allow us to use the same backend for a potential rev2 board
2025-10-20 remove deprecated vPK code for V/Line Pakenham line
    this no longer exists in the GTFS feeds
    [lsid.cpp, lsid.h, message.cpp, services.cpp]
2025-10-21 port to ESP32-S3
    things that were changed:
    * all LED drivers are connected to a single SPI bus - SPI3 is used as SPI2 should be reserved for fast interface (e.g. SD card).
    * UART driver and configuration console were ported to use native USB-Serial-JTAG interface instead on ESP32-S3. this effectively makes the UART driver more like an stdin/stdout driver, but it's more of a misnomer than anything, and I'll probably not change this for some time.
2025-12-02 add new Rev2 board using ESP32-S3
    no SD card slot though, not that we may need it anyway (hopefully)
    [Rev2.kicad_pcb, Rev2.kicad_sch, city.kicad_sch, ctrl.kicad_sch, led3.kicad_sch, led4.kicad_sch, mtt.kicad_sch, mtt_final.kicad_pcb]
2025-12-03 add more vias and also KiCad logo
    [Rev2.kicad_pcb]
2025-12-03 add SD card for future expansion
    [Rev2.kicad_pcb, ctrl.kicad_sch]
2025-12-03 add power LED
    [Rev2.kicad_pcb, ctrl.kicad_sch]
2025-12-03 add OSHW logo on PCB back
    [Rev2.kicad_pcb]
2025-12-06 update fabrication info
    [Rev2.kicad_pcb]
2025-12-08 Malvern station hack for Rev1 board
2025-12-08 add 3D models, and change USB-C connector type
    [1010 led.STEP, Rev2.kicad_pcb, aw20216.STEP, ctrl.kicad_sch, sd.STEP, usbc.STEP]
2025-12-08 board cleanup
    [Rev2.kicad_pcb]
2025-12-09 add header for SD card pins
    [Rev2.kicad_pcb, ctrl.kicad_sch]
2025-12-09 hopefully final board design
    [Rev2.kicad_pcb]
2025-12-11 fix 10k resistor BOM
    [Rev2.kicad_pcb]
2025-12-12 allow pressing BOOT button to access configuration interface
2025-12-13 add Wi-FI configuration API endpoints, as well as remote reset
    [config.h, set_wifi.cpp, webserver.cpp, wifi.cpp]
2025-12-14 fix line enable/disable, and also support the Metro Tunnel
    [services.cpp]
2025-12-14 serve Bootstrap, rework status/normal mode config site, and fix HTTP server issues
    [webserver.cpp]
2025-12-25 first batch
    [Rev2.kicad_pcb]
2025-12-28 fix get MQTT endpoint
    [mqtt.cpp]
2025-12-28 make info retrieval sequential to not stress the ESP32 out
2025-12-31 add side edge rails for 2nd batch, hopefully JLCPCB will play nicely
    [Rev2.kicad_pcb]
2026-01-06 config stuff for newly arrived rev2 board, no LED offsets yet
2026-01-06 move LED matrix offsets to revision-specific directories
2026-01-06 silkscreen fixes
    [Rev2.kicad_pcb]
2026-01-06 invert RGB order for rev2 board
    [led_matrix.h]
2026-01-07 Burnley group LED offsets
    [burnley.h, led_matrix.h]
2026-01-07 Dandenong group LED offsets, and also fix rev1 hacks
    [dandenong.h, led_matrix.h, lsid.h]
2026-01-07 Clifton Hill group LED offsets
2026-01-07 Metro Tunnel LED offsets
2026-01-07 Sandringham line LED offsets
2026-01-07 Newport/Frankston group LED offsets
    TODO: implement switching mechanism between going to Frankston and Sandringham
2026-01-07 fix Armadale, Toorak and Hawksburn (Frankston line) LED wiring, and add Northern group LED offsets
    will need to run bodge wires for 1st batch boards
    [Rev2.kicad_pcb, city.kicad_sch, vline_west.kicad_sch]
2026-01-07 V/Line LED offsets for Ballarat, Geelong and Gippsland lines, as well as handling code for regional services on these lines
    will need to add the remaining lines too
2026-01-08 add option to run bodge test prior to booting
    this will be used during production only
    [main.cpp]
2026-01-09 fix Shepparton LED wiring
    same stuff as before :(
    [Rev2.kicad_pcb, city.kicad_sch]
2026-01-10 Bendigo and Seymour LED offsets and handling
2026-01-10 update bodge test code
    [main.cpp]
2026-01-10 revision 2B board: fixed SD card wiring
    [Rev2.kicad_pcb, city.kicad_sch]
2026-01-11 add rev2 board view, and also add gzip compression to build pipeline
2026-01-11 flip colour order for rev2 board
2026-01-11 add OTA partition tables for ESP32 and ESP32S3
    [partitions.csv, partitions.esp32.csv, partitions.esp32s3.csv]
2026-01-21 add ESP32S3 GitHub Actions workflow
2026-01-21 fix ESP32 partition table alignment
    [partitions.esp32.csv]
2026-01-21 fix TX buffer size
    [ota.cpp]
2026-01-21 reset all LED drivers before enabling drivers
    [led_matrix.cpp]
2026-02-10 disable activity LED flashing by default
    no need to have it as configurable option, since it doesn't really serve a function beyond debugging
2026-02-11 rename cross city LED colour to Frankston
2026-02-11 move Frankston line code out, and add City Loop display for the line using Caulfield loop track
2026-02-11 change Springhurst station code to SHT
2026-02-15 update daily timetable with rail replacement bus data
2026-02-15 prefix rail replacement bus trips with RRB
2026-02-15 publish rail replacement bus flag on MQTT
2026-02-15 show rail replacement buses on LED display; untested
    will need to be tested tomorrow after 8:30pm AEDT, as there will be rail replacement buses between Newport and Werribee
    [colours.h, lsid.cpp, lsid.h, message.cpp, message.h, services.cpp]
2026-02-17 implement colour correction, and also add colour calibration code in main
    [colours.h, led_matrix.cpp, led_matrix.h, main.cpp]
2026-02-17 implement reverse correction for correct displaying on web interface
    [led_matrix.cpp, led_matrix.h, webserver.cpp]
2026-02-18 move forward and reverse LUTs to constexpr so they get computed at compile time
    [led_matrix.cpp, led_matrix.h]
2026-02-18 make stop pattern part of daily cache too
    in case MTM is truly incompetent
2026-02-20 add workaround for Sunbury short workings not going through city
    [message.cpp, message.h]
2026-03-20 add calibration for rev1 board
2026-04-12 fix crashes occurring when m_nextTime == m_time (hopefully)
    [services.cpp]
2026-04-19 make line bitmask 64-bit
    fixes bug #36
    [services.cpp, services.h]
2026-05-26 switch to hatched fill
    [Rev2.kicad_pcb]
2026-05-27 add +5V rail to debug header
    someone might want to power the board that way :/
    [Rev2.kicad_pcb, ctrl.kicad_sch]
2026-05-28 add OLED display
    [Rev2.kicad_pcb, ctrl.kicad_sch]
2026-06-16 rev.2c revised PCB layout, final
    [Rev2.kicad_pcb, city.kicad_sch, ctrl.kicad_sch, led3.kicad_sch, led4.kicad_sch, vline_west.kicad_sch]
